octoprobe/tentacle/README.rst

Octoprobe Tentacle
==================

This is the `documentation <http://www.octoprobe.org/tentacle>`_

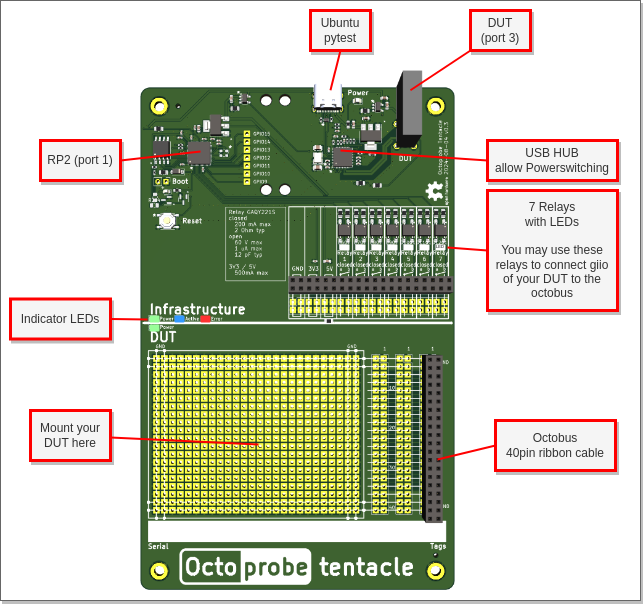
[picture p1: docs/tentacle_images/tentacle_intro.drawio.png]
