octoprobe/tentacle/docs/index.rst

Tentacle
======================

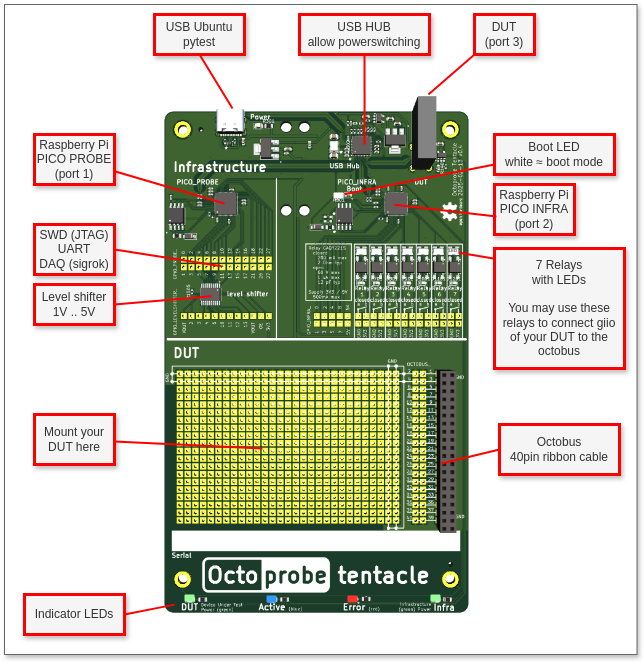
[picture p2: docs/tentacle_images/tentacle_intro_v0.4.drawio.png]


.. toctree::

    big_picture.rst
    tentacle_v0.9.rst
    tentacle_v0.8.rst
    tentacle_v0.7.rst
    tentacle_v0.6.rst
    tentacle_v0.5.rst
    tentacle_v0.4.rst
    tentacle_v0.3.rst
    pcb/bom.rst
    rp2_probe.rst
    rp2_probe-obsolete.rst
    license.rst
