octoprobe/tentacle/docs/tentacle_v0.9.rst

Tentacle v0.9 (recommended, 15 pieces produced)
=================================================================

This repo describes the hardware of a tentacle:

See also: :doc:`tentacle_v0.3`

Schematics
----------

:download:`Schematics v0.9 (Pdf) <../kicad/tentacle_v0.9/production_v0.9/schematics_tentacle_v0.9.pdf>`.

PCB
---
:doc:`Parts list <pcb/bom>`

The assembled PCB may be ordered at https://www.jclpcb.com. The production files are located here: `kicad/kicad_tentacle_v0.5/production_v0.5`.

The price of a assembled PCB is:

.. list-table::
    :header-rows: 1
    :align: right

    * - Pieces
      - USD total
      - USD per piece
    * - 15
      - 250
      - 16.7

The tentacle is described in more detail in :doc:`octoprobe:big_picture`



USB and Power
-----------------

This block diagram shows the power distribution with MT9700 switches and how to enable boot mode for `RP_INFRA` and `RP_PROBE`.
