octoprobe/tentacle/docs/big_picture.rst

Big Picture
===========================

A Octopus is flexible in using its tentacles. The same sence Octoprobe is flexible in using its tentacle PCB.
