octoprobe/tentacle/docs_working/working_v0.4/rp2_probe_logicanalyzer.md

# Logic Analyzer

https://github.com/gusmanb/logicanalyzer

https://github.com/gusmanb/logicanalyzer/blob/master/Schematic1.jpg

24 Channels

### JLC

* TXU0104PWR, JLC C2938871, USD0.7
