octoprobe/tentacle/docs_working/working_v0.4/rp2_probe_sigrok.md

# RP2 Sigrok

## Links

* https://github.com/dotcypress/ula/releases
  * https://forums.raspberrypi.com/viewtopic.php?t=350300
  * Written in Rust, Supported by standard Pulseview, seems to work.

* https://github.com/pico-coder/sigrok-pico/blob/main/README.md
  * No copyright
  * Written in C. Supported by standard Pulseview, seems to work.
