octoprobe/tentacle/docs/tentacle_v0.3.rst

Tentacle v0.3
===================

This repo describes the hardware of a tentacle:

Schematics
----------

:download:`Schematics v0.3 (Pdf) <../kicad/tentacle/production_v0.3/schematics.pdf>`.

PCB
---
:doc:`Parts list <pcb/bom>`

The assembled PCB may be ordered at https://www.jclpcb.com. The production files are located here: `kicad/kicad_tentacle_v0.3/production_v0.3`.

The price of a assembled PCB is ~USD10 when ordering 30 pieces.

The tentacle is described in more detail in :external+octoprobe:doc:`Octprobe <README>`

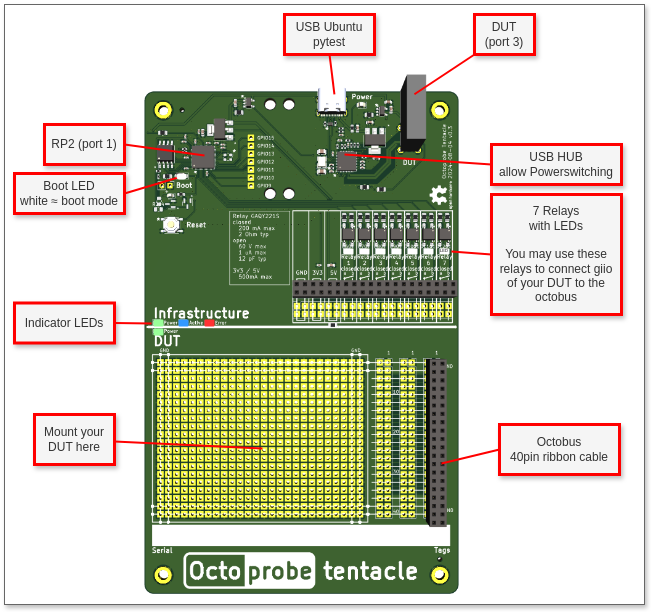
[picture p12: docs/tentacle_images/tentacle_intro_v0.3.drawio.png]
