octoprobe/tentacle/docs_working/2025-08_voltage-monitoring/2025-08-23_usb-cable-resistance_obsolete/README_usb_cable_resitance.md

## USB reference cable

| name | color |
| - | - |
| shield | None |
| GND | black |
| VBUS | red |
| D+ | green |
| D- | white |

| Connector | name | color | Treedix Pinrow | Treedix Pin |
| - | - | - | - | - |
| Micro | GND | black | B | 1 GND |
| Micro | VBUS | red | B | 9 VBUS |
| Micro | D+ | green | B | 6 D+ |
| Micro | D- | white | B | 7 D- |

## Treedix USB Cable Tester

TypeA 2.0: All connectors ARE CONNECTED!

Micro USB: As table above

## Instruction

Treedix USB Tester: Power Switch: Off
Treedix USB Tester: Plug TypeA / Micro: Plug cable
Treedix USB Tester: Measure resistance between GND and VBUS <== Meaningsless as everything is shortened

## Conclusion

Treedix USB Tester may not be used to measure the resitance
