octoprobe/tentacle/docs/pcb/bom_images/2x20_Header_mechanical_drawing.jpg

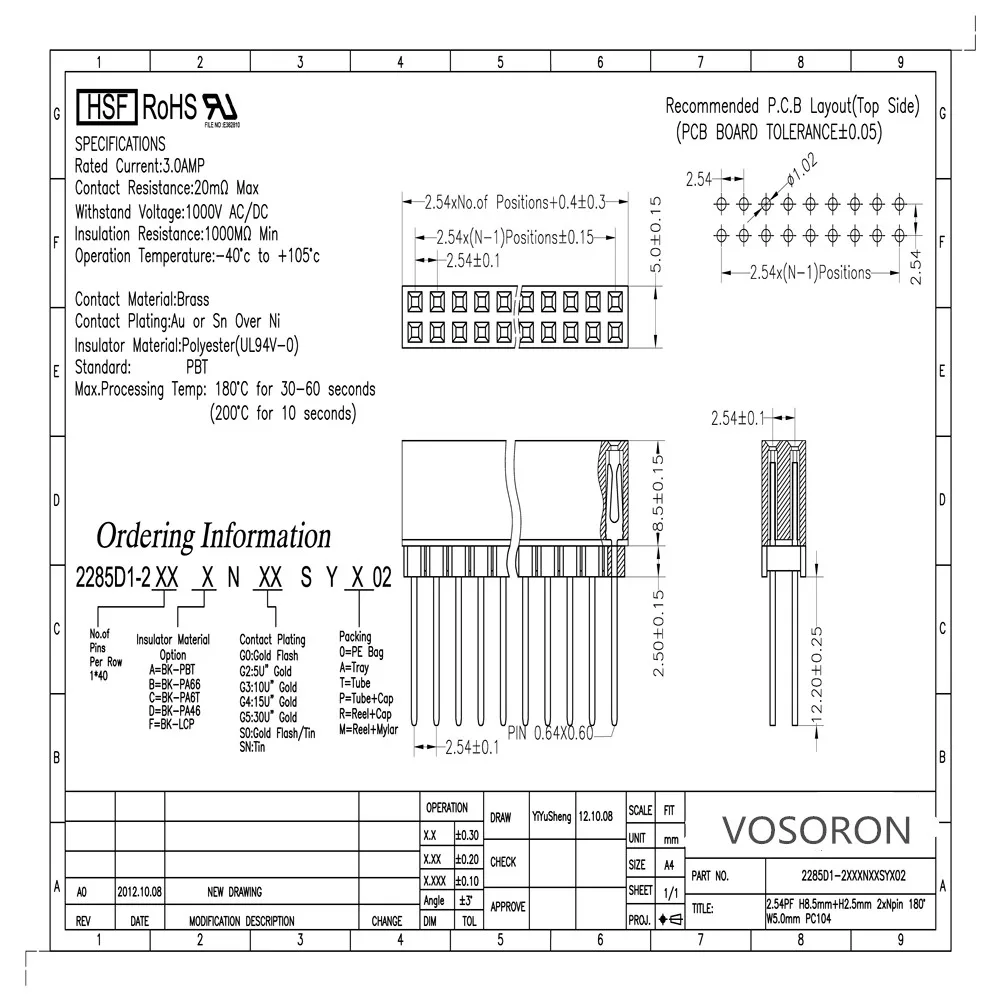
docs/pcb/bom_images/2x20_Header_mechanical_drawing.jpg
