octoprobe/tentacle/docs_working/2026-10-12_power_off_while_connecting/power_off_while_connecting.png

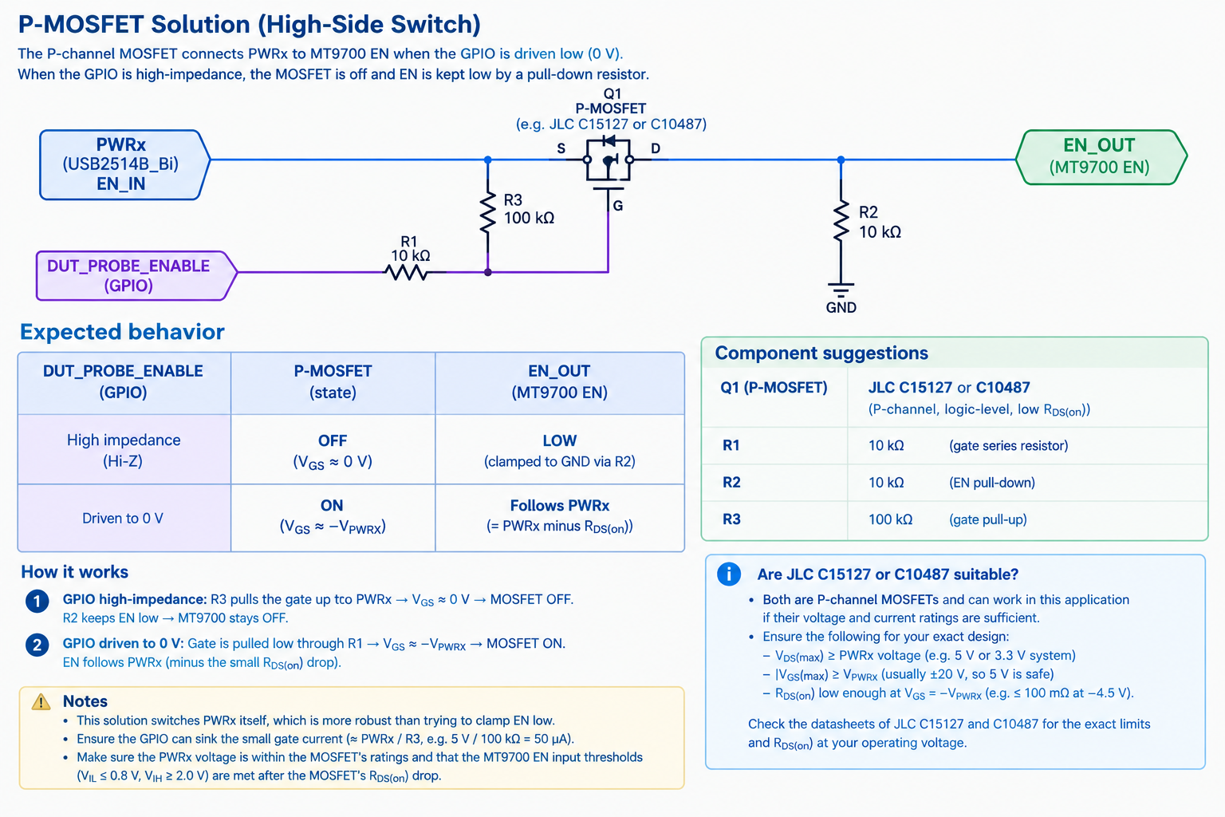
docs_working/2026-10-12_power_off_while_connecting/power_off_while_connecting.png
