octoprobe/tentacle/model3d_spacer_bolzone/20240719b_bolzone.png

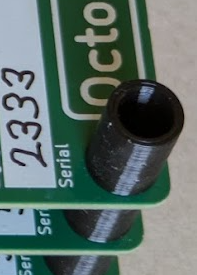
model3d_spacer_bolzone/20240719b_bolzone.png
