octoprobe/tentacle/kicad/tentacle_v0.8/00_project_parts/USB_A/USB-226-BRW_readme.md

https://componentsearchengine.com/part-view/USB-226-BRW/XUNPU
