octoprobe/tentacle/freecad_bolzone/bolzone_due_16.0.stl

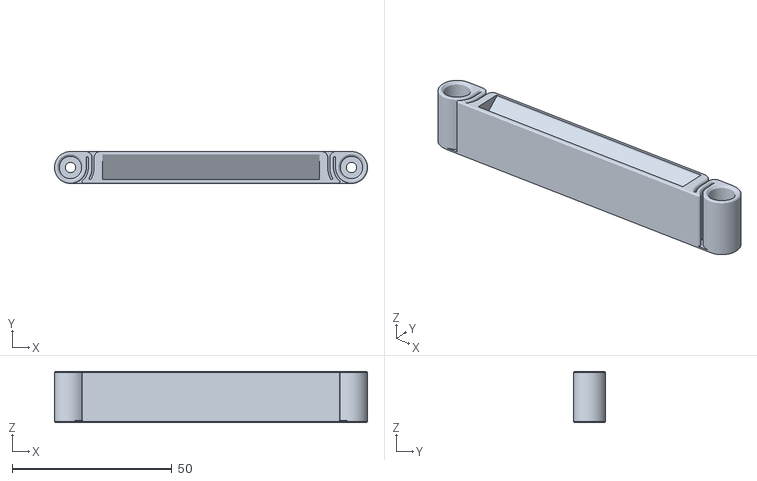
[picture p24: CAD file, 2026-05-20]
freecad_bolzone/bolzone_due_16.0.stl
98.0 x 10.0 x 16.0
