octoprobe/tentacle/freecad_bolzone/bolzone_uno_33.6.stl

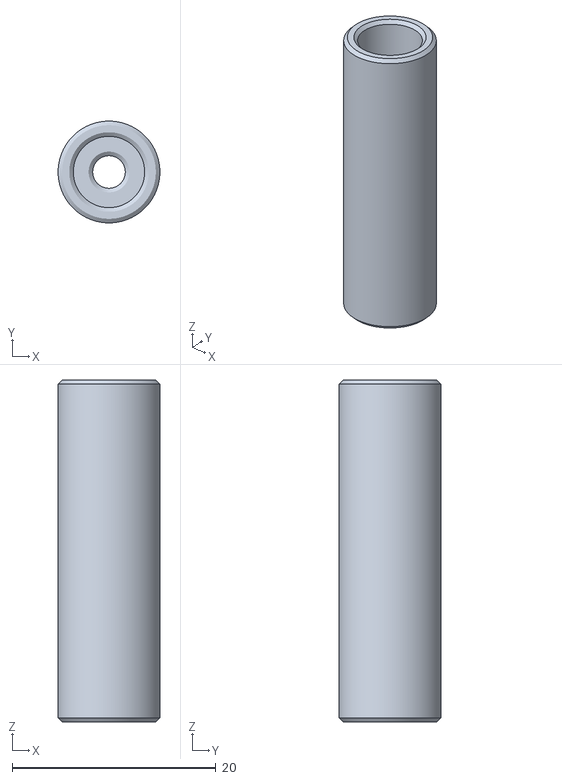
[picture p25: CAD file, 2026-05-20]
freecad_bolzone/bolzone_uno_33.6.stl
10.0 x 10.0 x 33.6
