octoprobe/tentacle/freecad_bolzone/bolzone_uno_16.0.stl

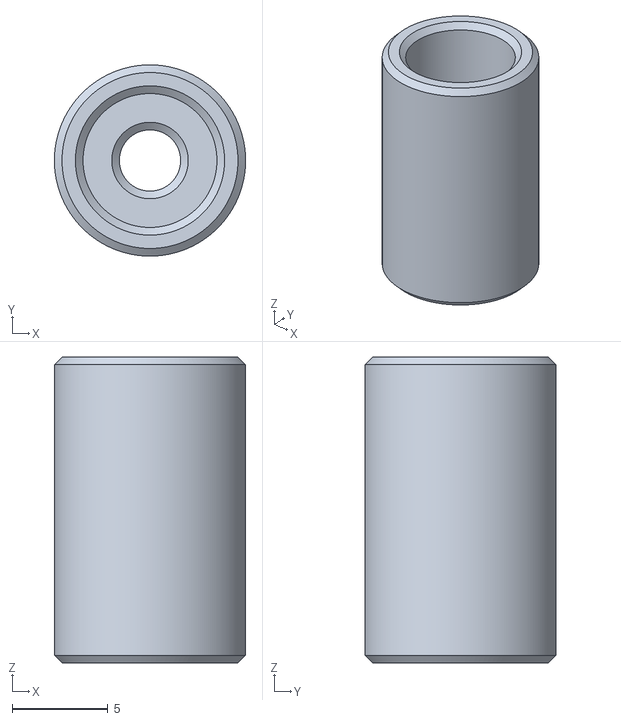
[picture p26: CAD file, 2026-05-20]
freecad_bolzone/bolzone_uno_16.0.stl
10.0 x 10.0 x 16.0
