octoprobe/tentacle/freecad_bolzone/bolzone_v20250418a.FCStd

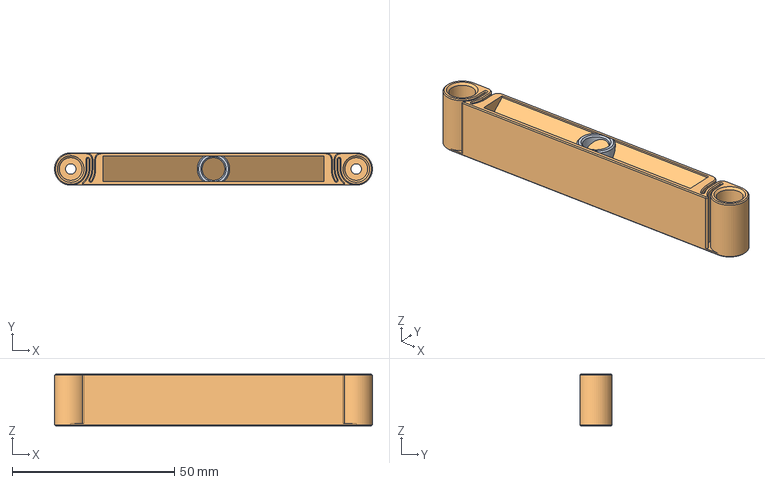
[picture p27: CAD file, 2026-05-20]
freecad_bolzone/bolzone_v20250418a.FCStd
98.0 x 10.0 x 16.0 mm
bolzone_uno
bolzone_due_label
