octoprobe/tentacle/freecad_bolzone/bolzone_due_33.6.stl

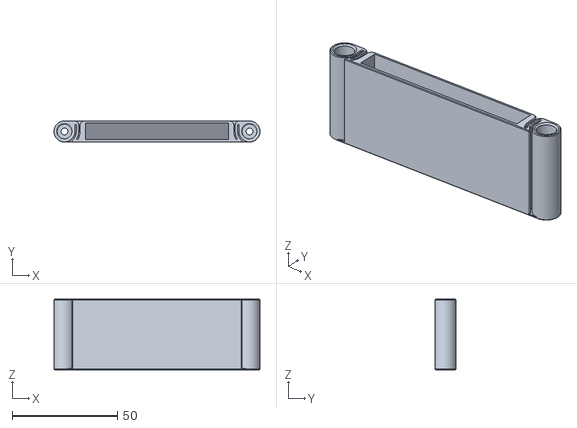
[picture p28: CAD file, 2026-05-20]
freecad_bolzone/bolzone_due_33.6.stl
98.0 x 10.0 x 33.6
