octoprobe/tentacle/kicad/tentacle_v0.8/00_project_parts/bizcard/footprints/TS-1187A-B-A-B.step

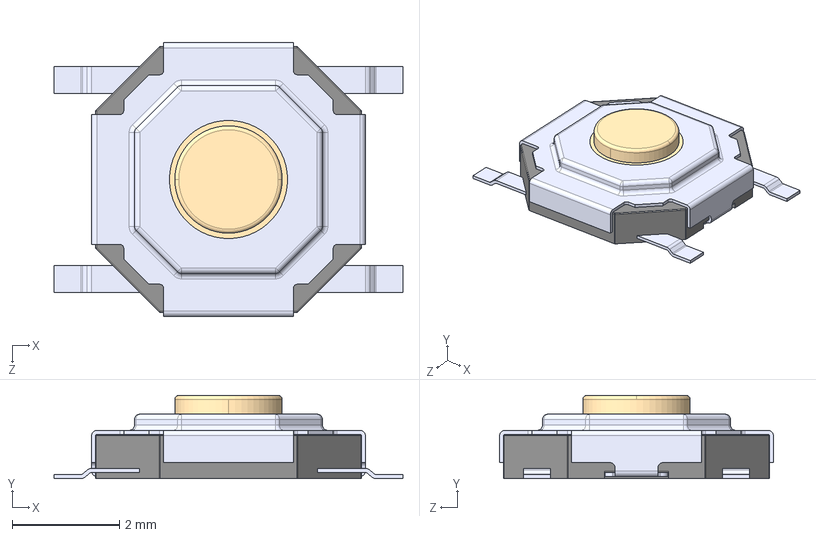
[picture p29: CAD file, 2024-08-17, an earlier design]
kicad/tentacle_v0.8/00_project_parts/bizcard/footprints/TS-1187A-B-A-B.step
6.50 x 1.55 x 5.10 mm
