octoprobe/tentacle/kicad/tentacle_v0.8/00_project_parts/USB_A/USB-226-BRW/USB-226-BRW.stp

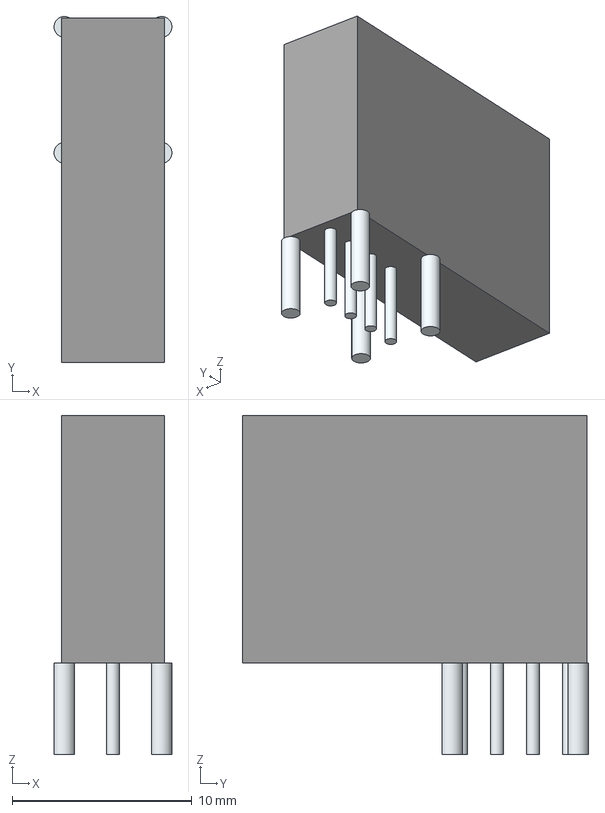
[picture p30: CAD file, 2024-08-17, an earlier design]
kicad/tentacle_v0.8/00_project_parts/USB_A/USB-226-BRW/USB-226-BRW.stp
6.55 x 19.2 x 18.9 mm
Leads
