octoprobe/tentacle/kicad/tentacle_v0.8/00_project_parts/bizcard/footprints/TYPE-C-31-M-12--3DModel-STEP-56544.STEP

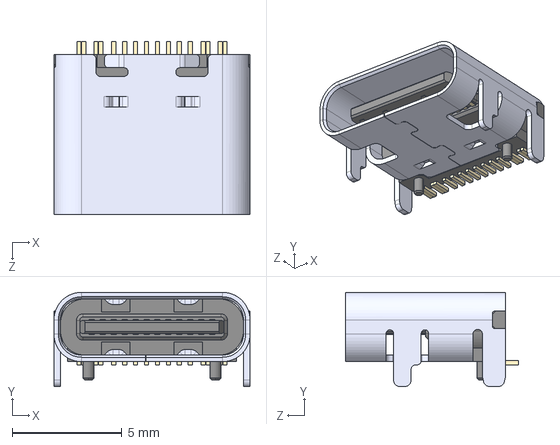
[picture p31: CAD file, 2024-08-17, an earlier design]
kicad/tentacle_v0.8/00_project_parts/bizcard/footprints/TYPE-C-31-M-12--3DModel-STEP-56544.STEP
8.94 x 4.30 x 7.90 mm
