octoprobe/tentacle/(list of files, cad)

Other CAD files:
model3d_spacer_bolzone/20240719b_bolzone.FCStd
model3d_spacer_bolzone/20240719b_bolzone.stl
