octoprobe/tentacle/docs_working/2025-08_voltage-monitoring/2025-08-23_usb-cable-resistance_obsolete/USB_Cable_Manual.pdf

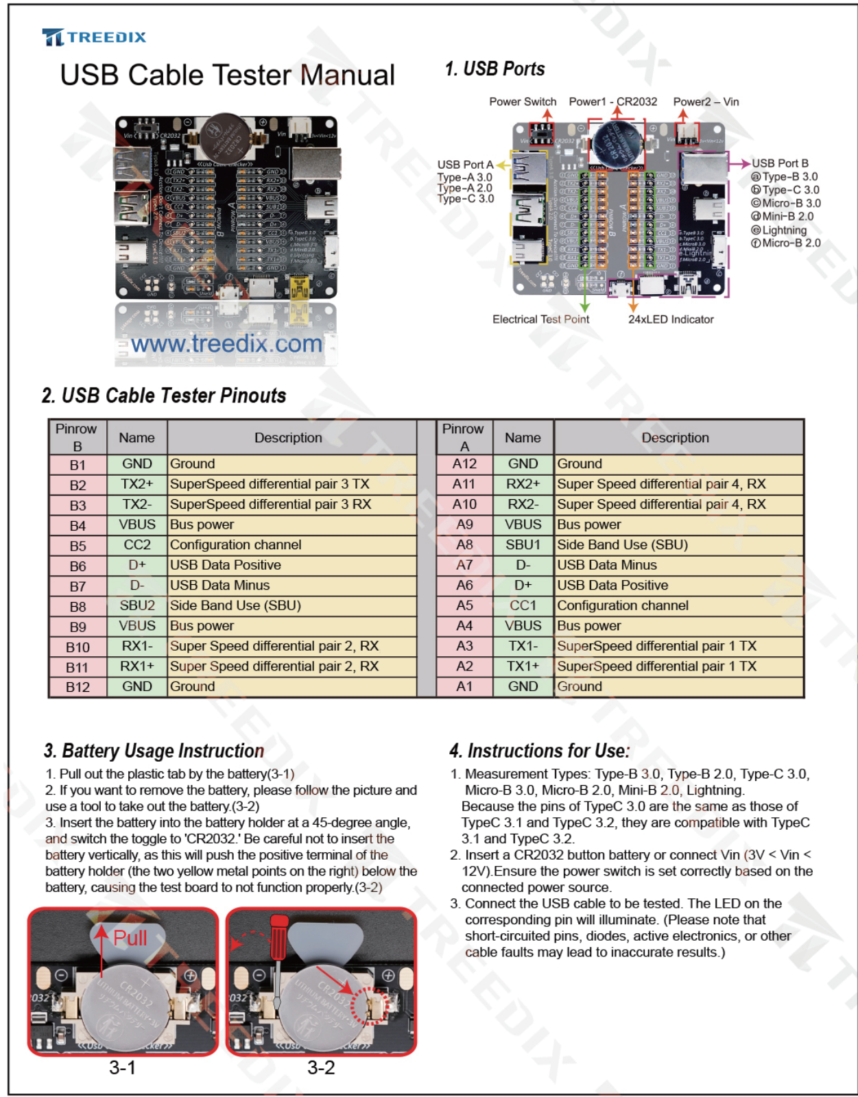
[picture p32: page 1]
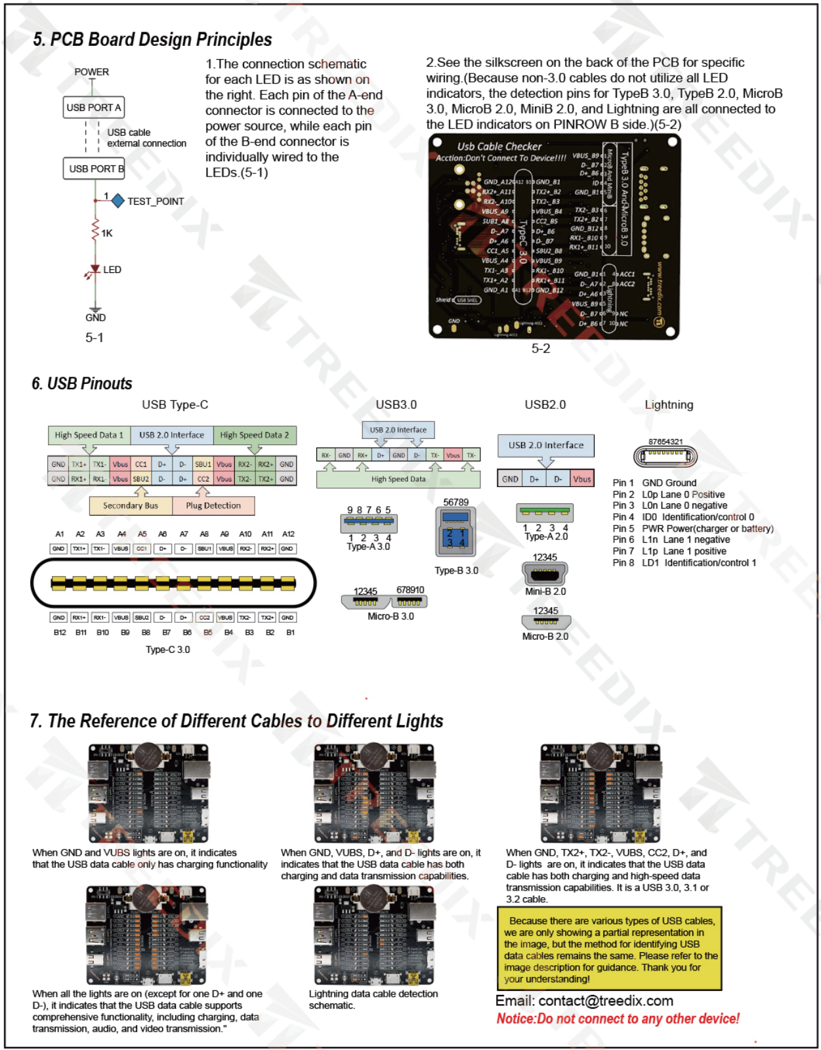
[picture p33: page 2]
