octoprobe/tentacle/docs_working/2025-12_voltage-monitoring/README_evaluation_hubs_powersupplies.md

# Evalation

## Power supplies

* https://www.distrelec.ch/de/industrie-netzteil-30w-5v-6a-mean-well-irm-30-5st/p/30060583

  CHF15, 6A

* https://www.distrelec.ch/de/netzteil-gst25-series-5v-4a-20w-iec-60320-c8-zylinderstecker-mm-mean-well-gst25b05-p1j/p/30042763

  CHF14, 4A

## USB Hubs, 2.0, USB-A, 4Port

* https://www.distrelec.ch/de/usb-hub-usb-stecker-usb-ports-usb-buchse-startech-com-st4200mini2/p/30214248

  CHF16, StarTech.com

* https://www.distrelec.ch/de/usb-hub-usb-stecker-usb-ports-usb-buchse-rs-pro-2206492/p/30390908

  CHF11, RS PRO

* https://www.distrelec.ch/de/usb-hub-mini-usb-buchse-usb-ports-usb-buchse-roline-14-02-5013/p/30114486

  CHF34, Roline

* https://www.distrelec.ch/de/usb-hub-usb-stecker-usb-ports-usb-buchse-rs-pro-1411989/p/30394878

  CHF14, RS PRO

* https://de.aliexpress.com/item/1005003614172238.html, https://de.aliexpress.com/item/1005006482609043.html

  USD3, Aiersai, GL850G-Chip, https://www.genesyslogic.com.tw/

  chip seams to be too cheap
