octoprobe/tentacle/docs_working/working_v0.4/tentacle_v04_bring_up.md

# Tentacle v0.4 bring up

Goal: Test all aspects of the tentacle

## Features of tentacle v0.3: Relays

Rationale:
 * Demonstrate that the relays work as expected
 * Demonstrate that the USB connection to the DUT works.
Setup:
 * Tentacle: MCU_RPI_PICO_W, de646cc20b684f25, v0.4
 * Tentacle: DAQ SALEAE, v0.3
 * Tentacle: DEVICE_POTPOURRY, v0.3
