octoprobe/tentacle/kicad/tentacle_v0.9/production_v0.9/schematics_tentacle_v0.9.pdf

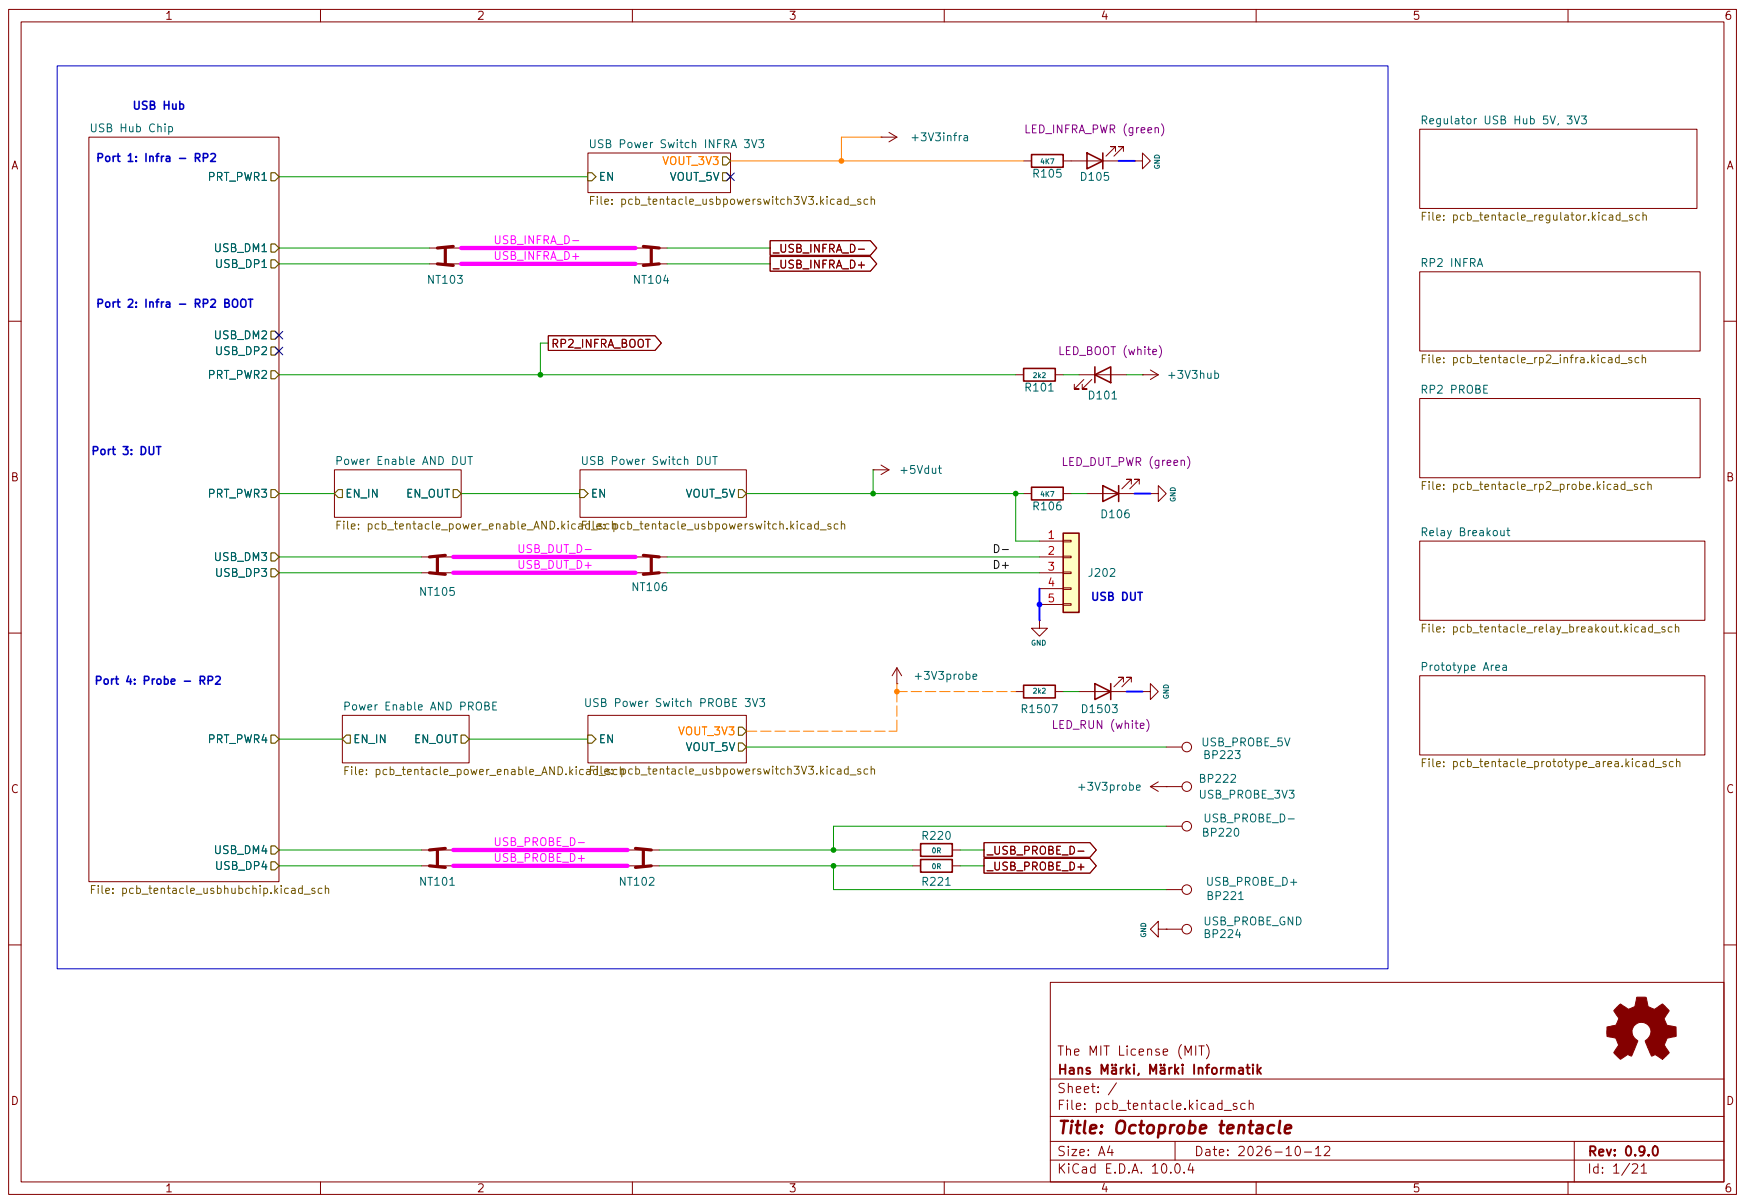
[picture p34: page 1]

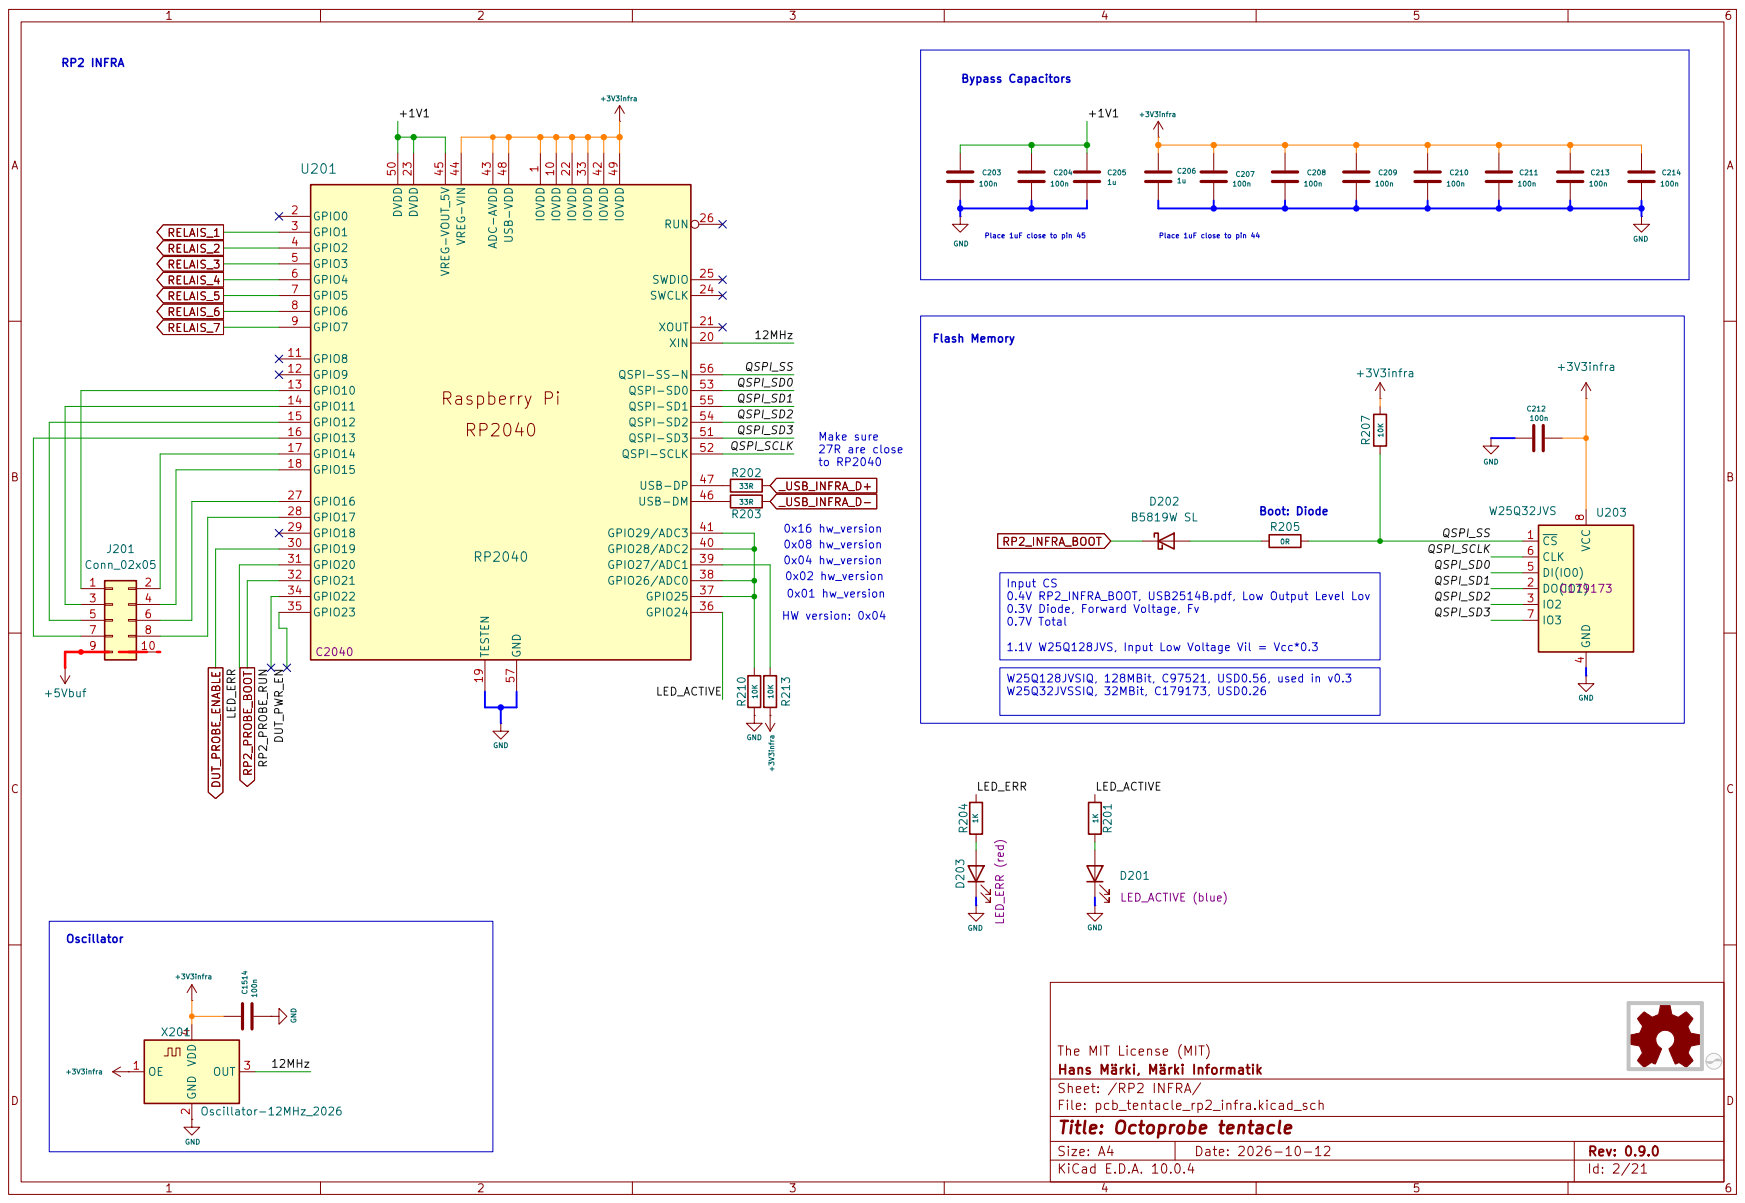
[picture p35: page 2]

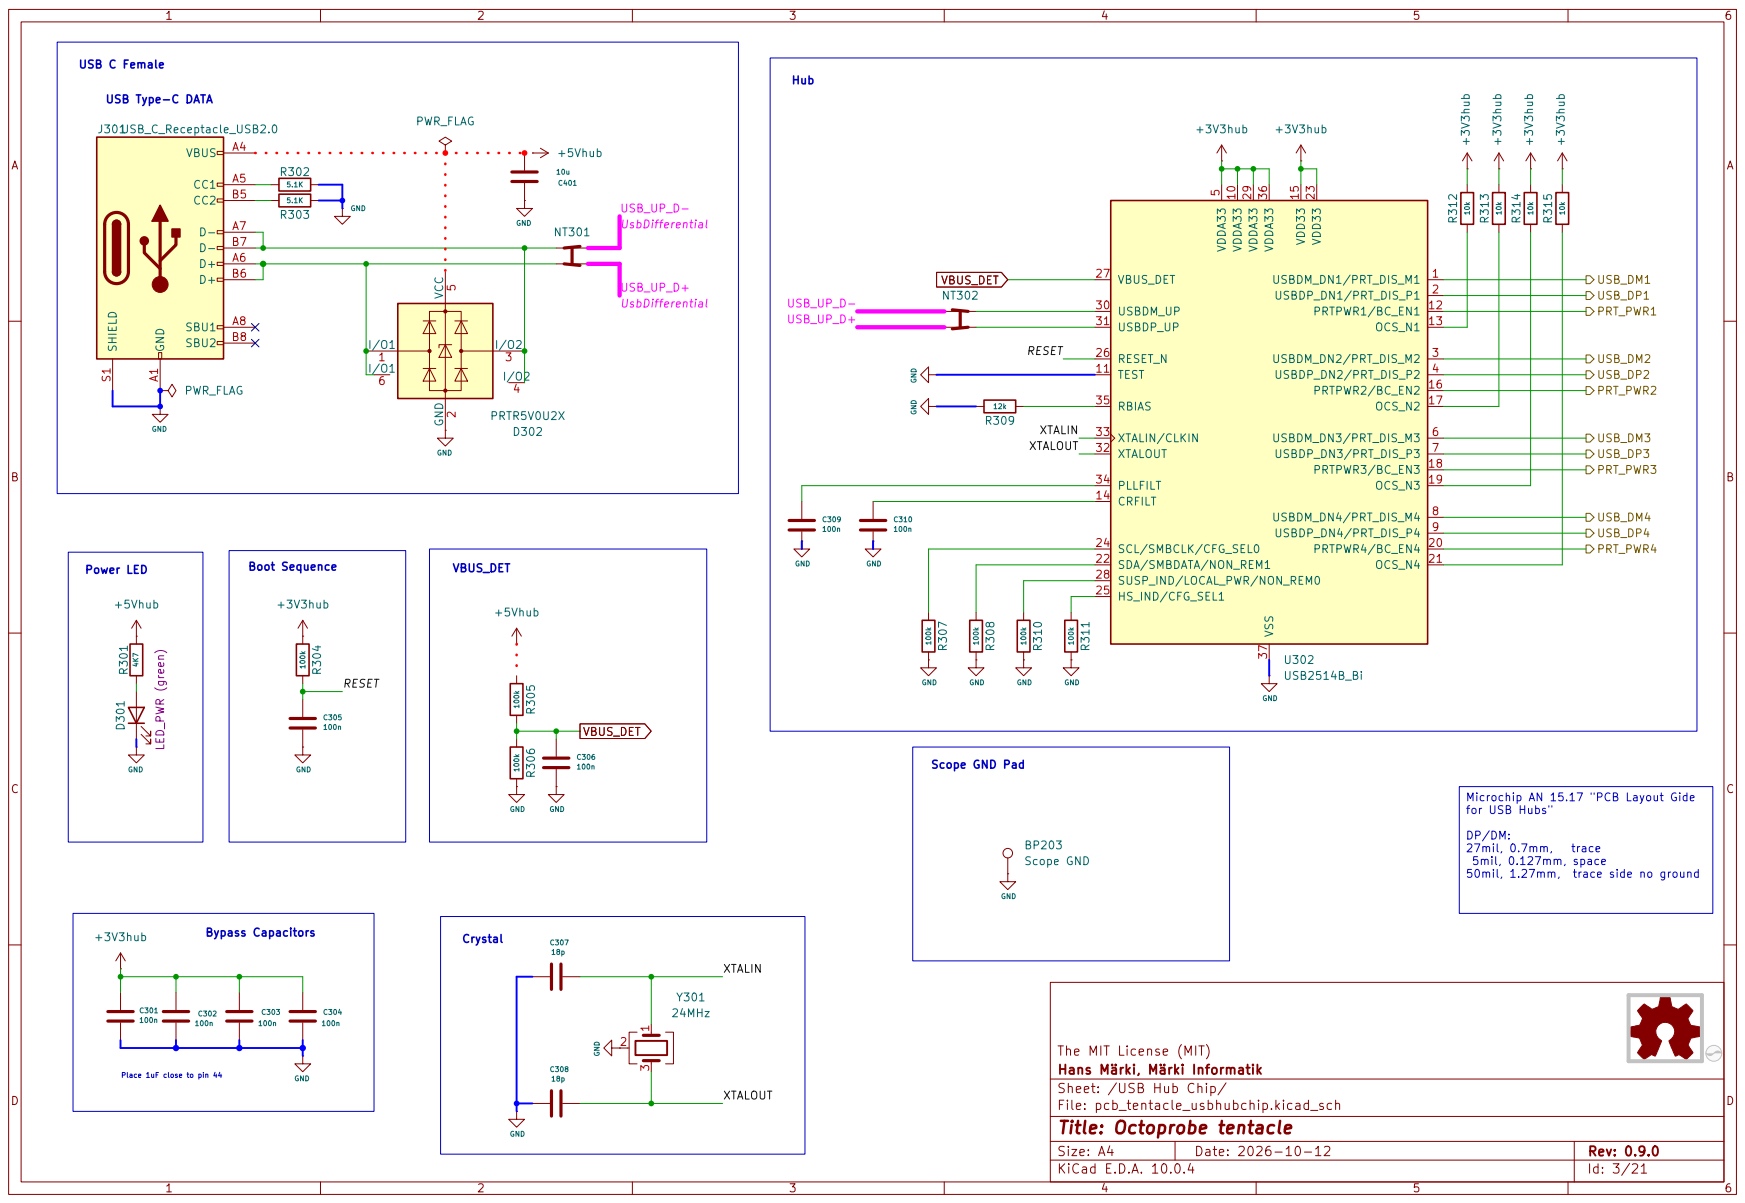
[picture p36: page 3]

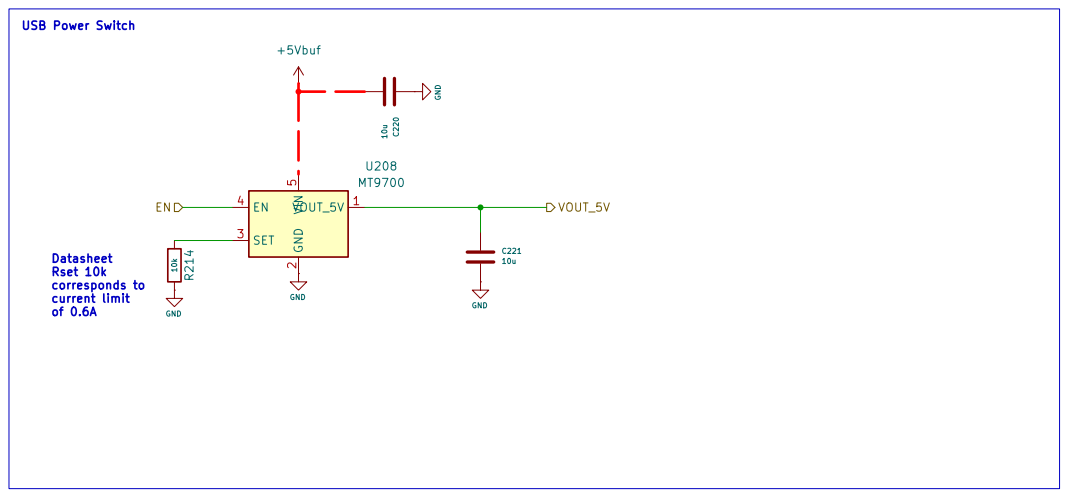
[picture p37: page 4]

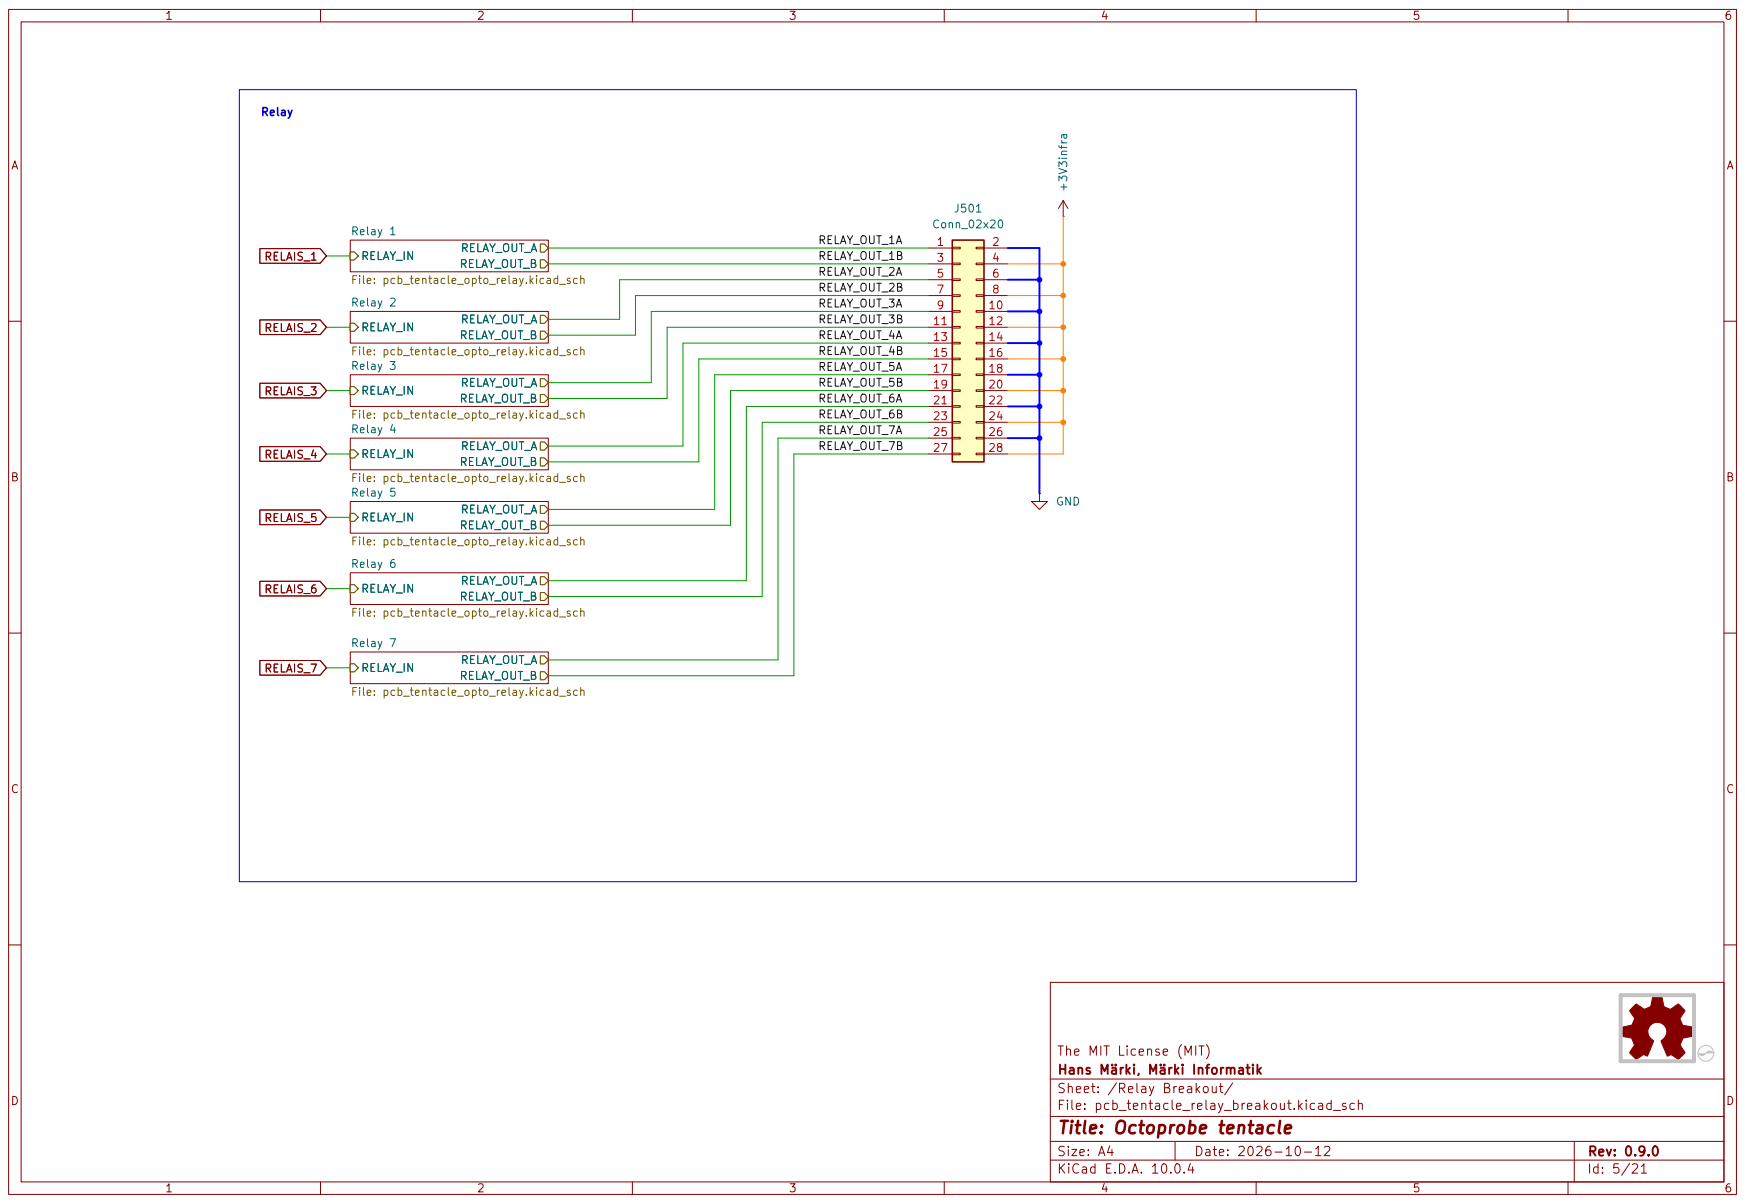
[picture p38: page 5]

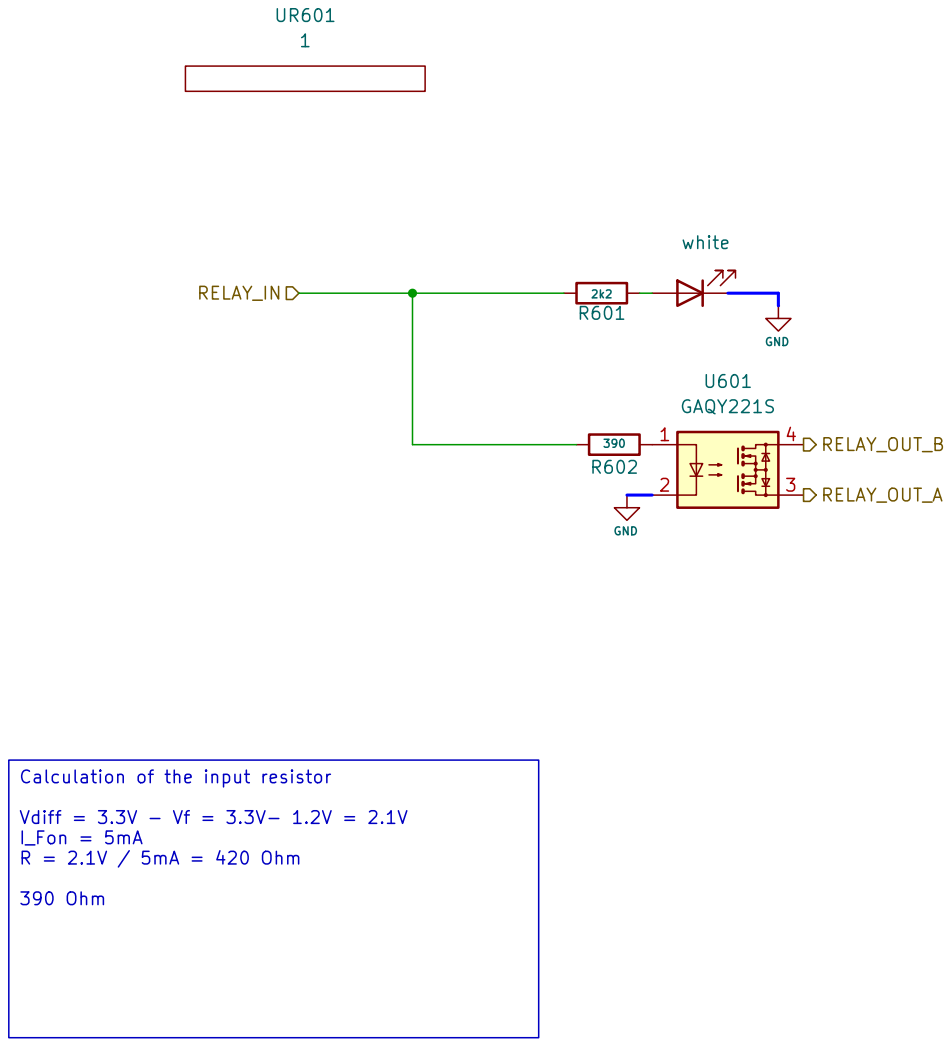
[picture p39: page 6]

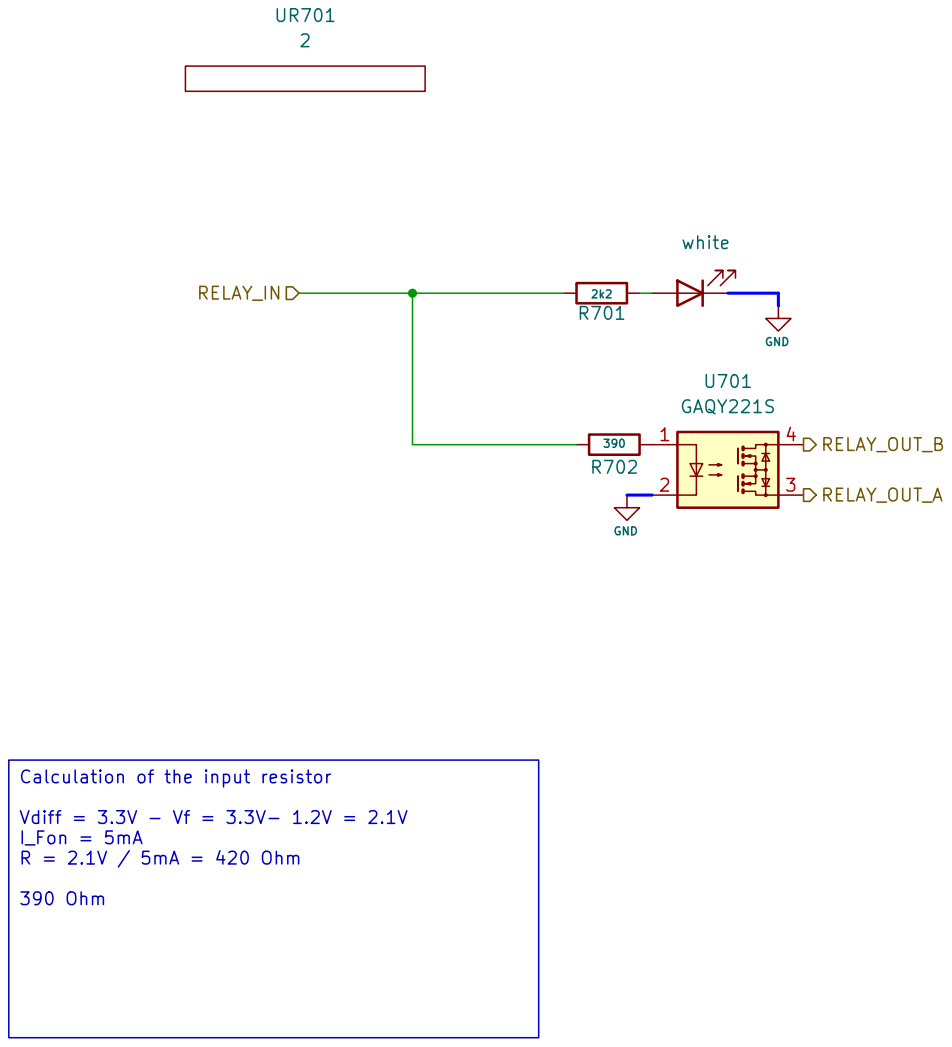
[picture p40: page 7]

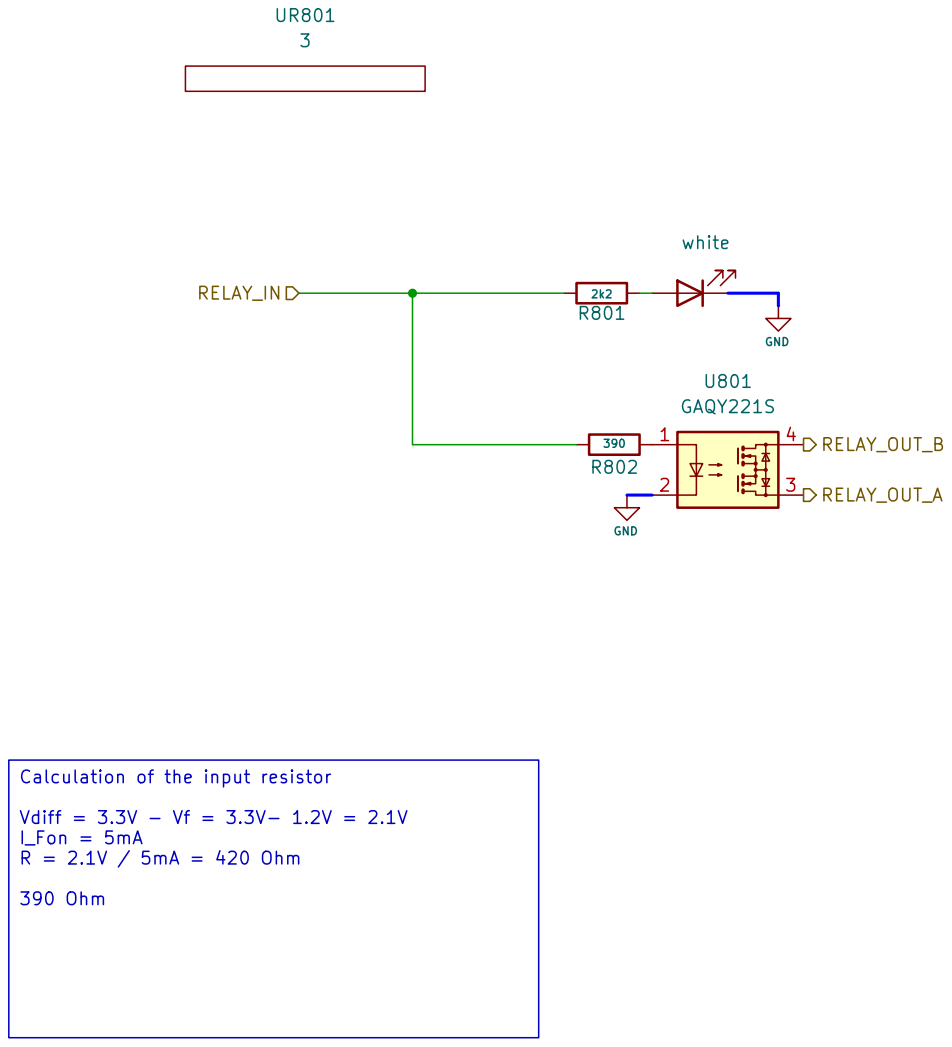
[picture p41: page 8]

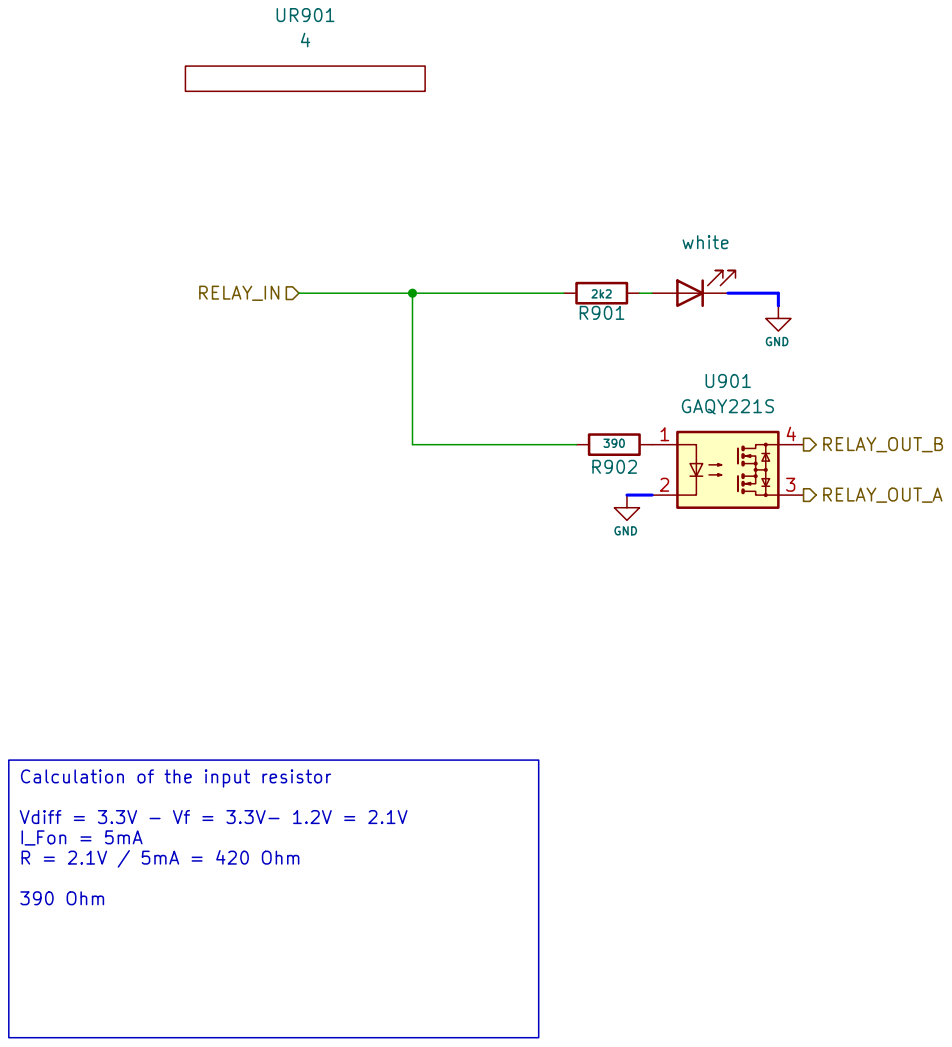
[picture p42: page 9]

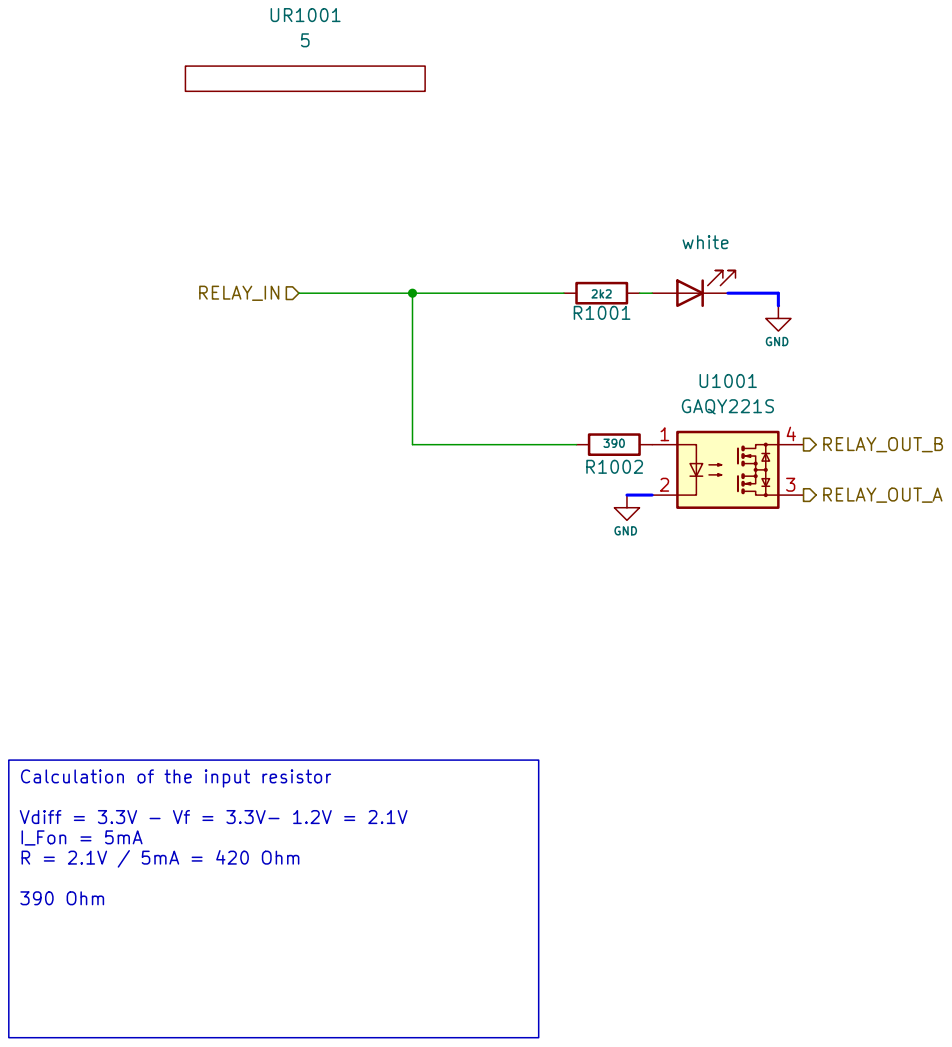
[picture p43: page 10]

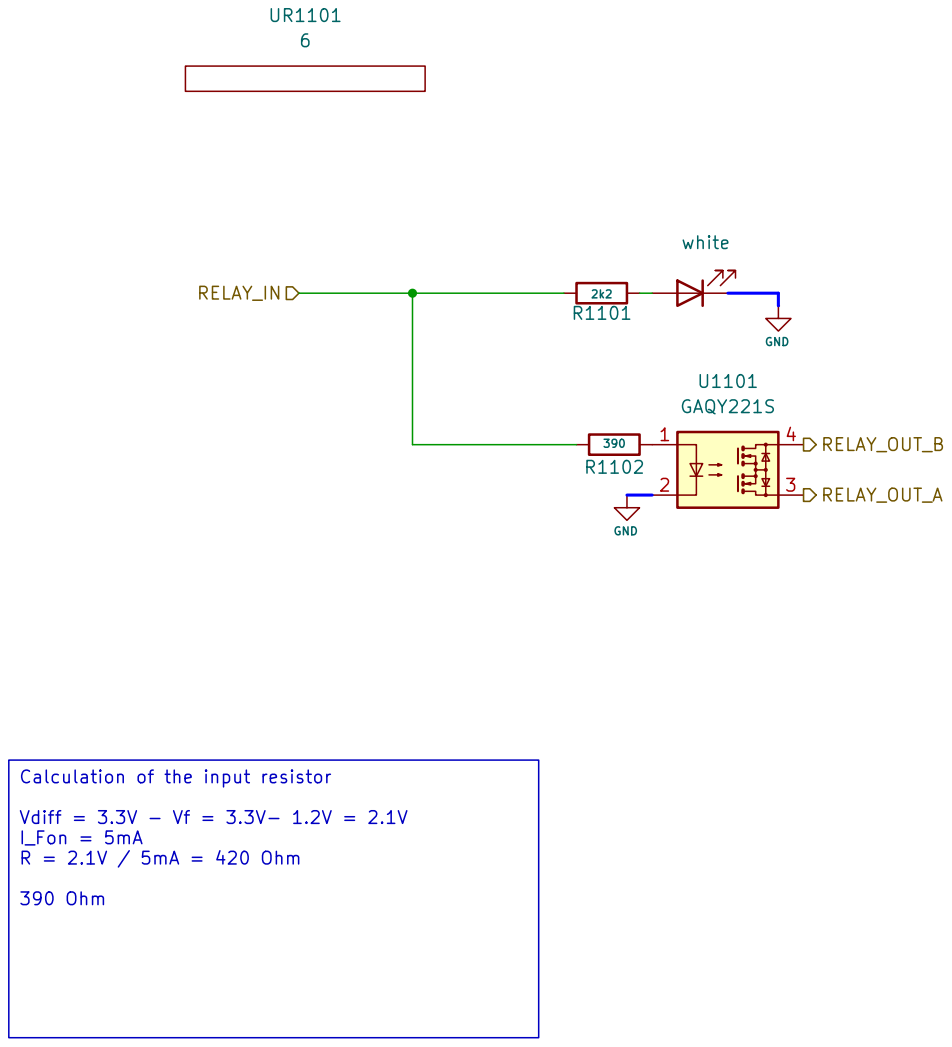
[picture p44: page 11]

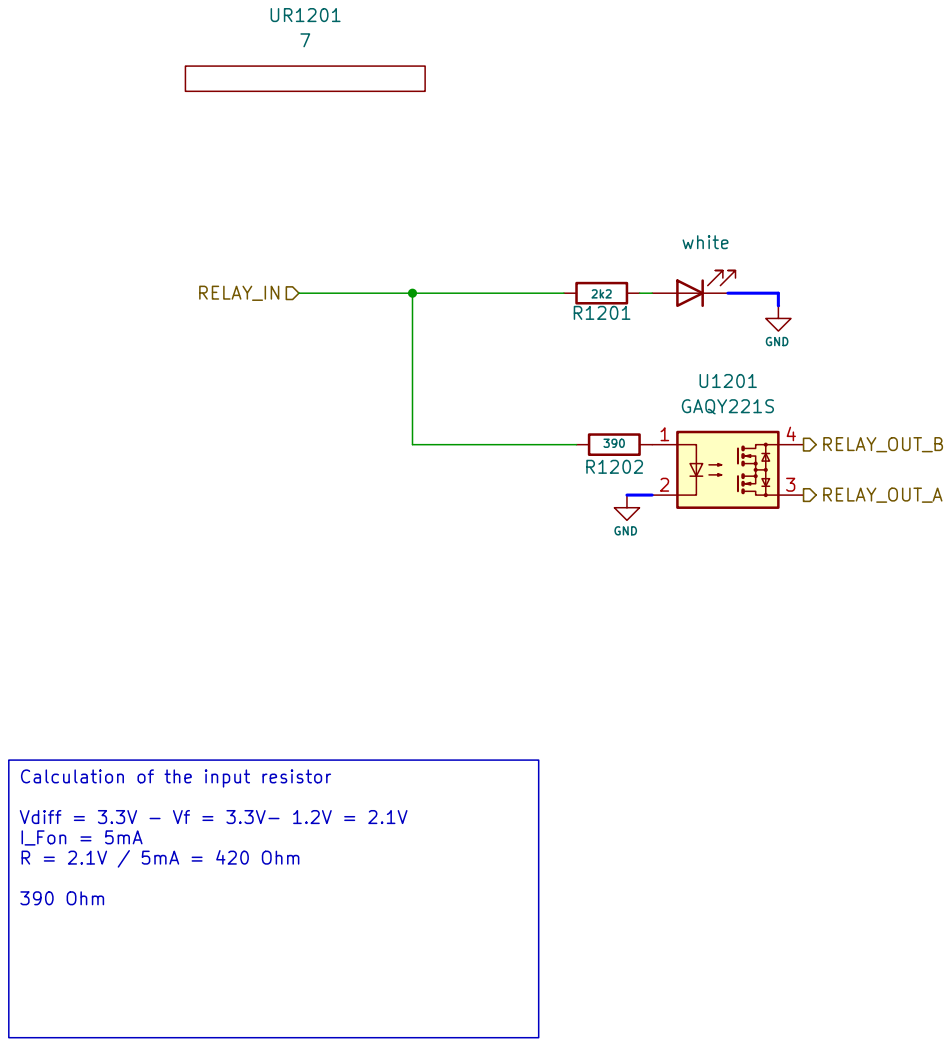
[picture p45: page 12]

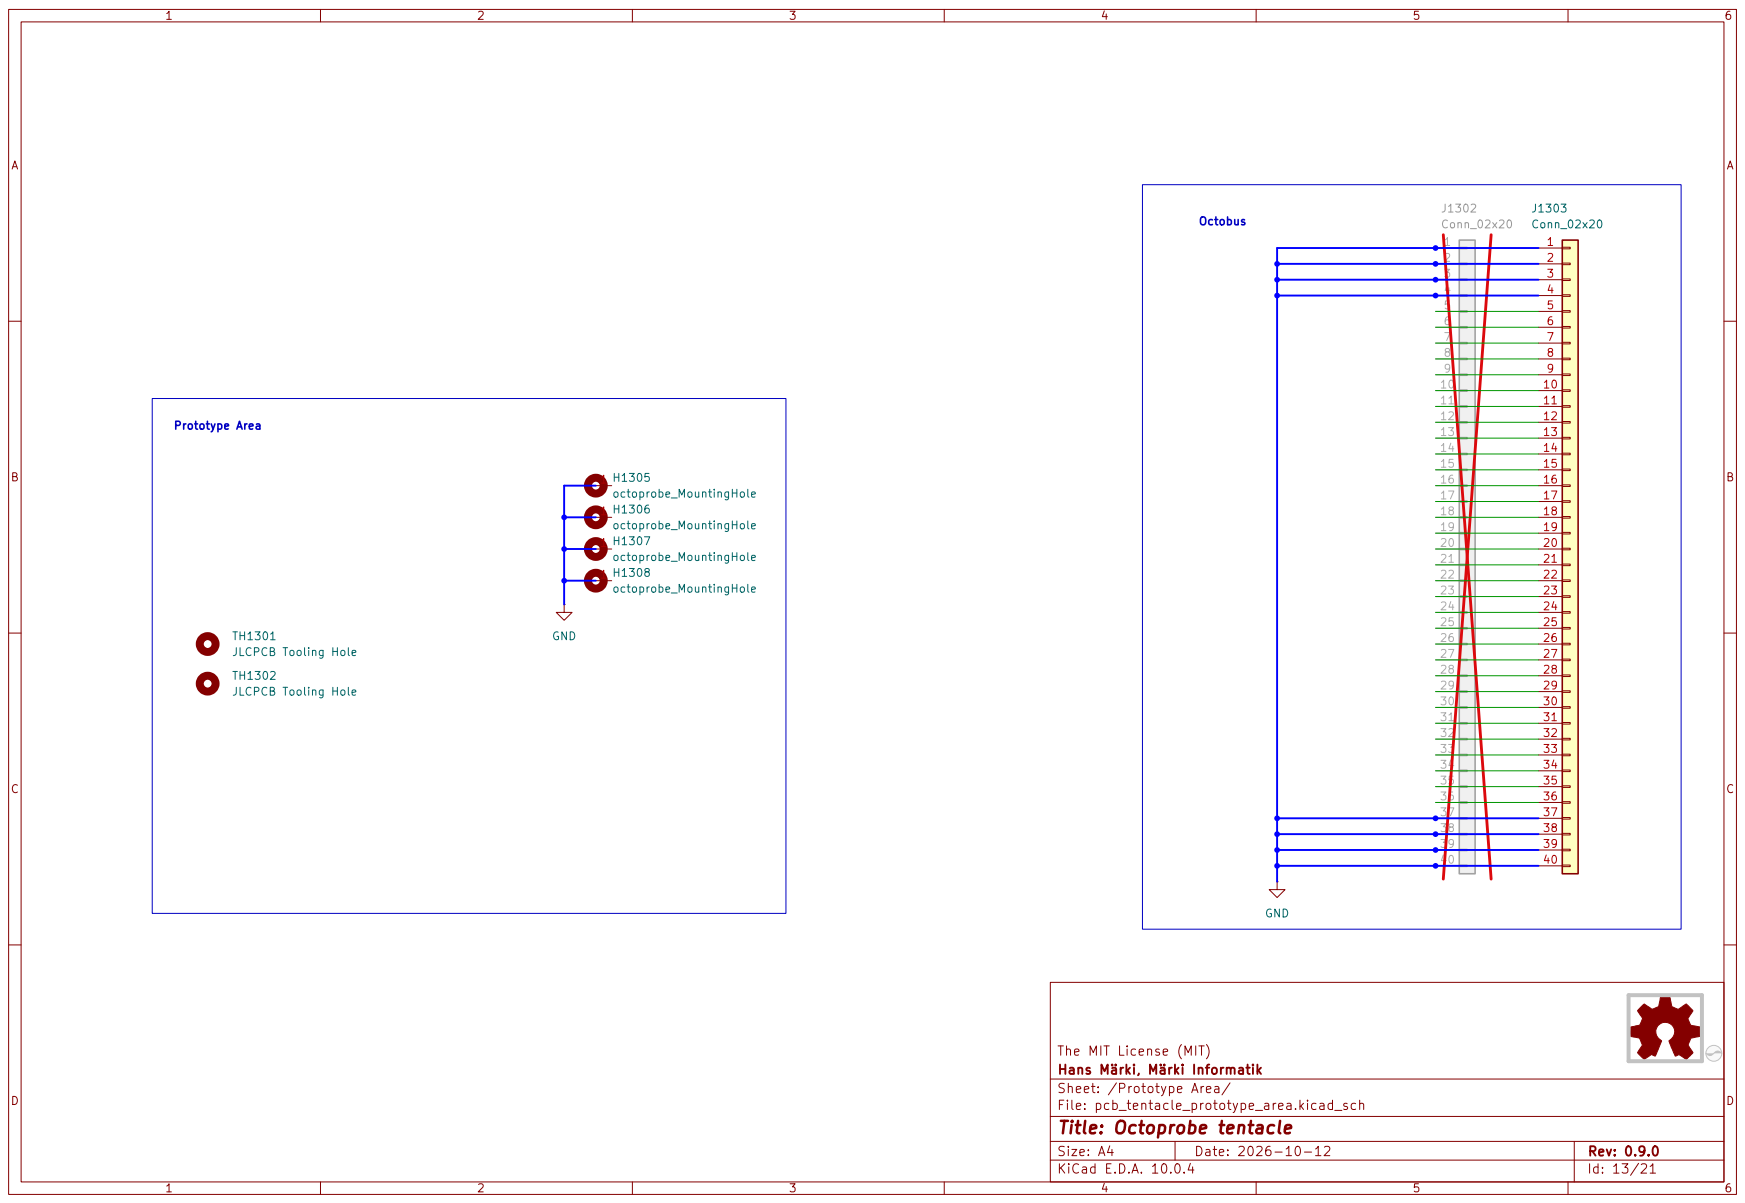
[picture p46: page 13]

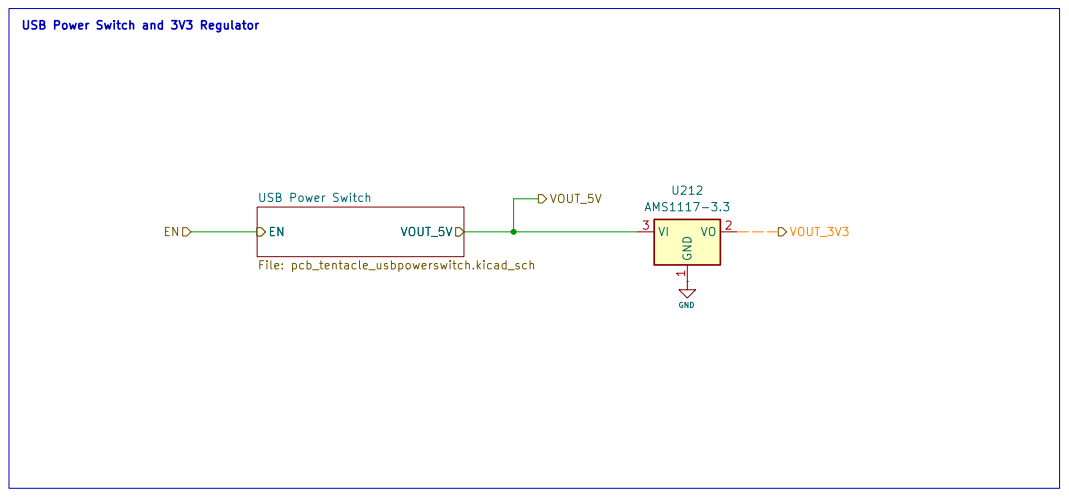
[picture p47: page 14]

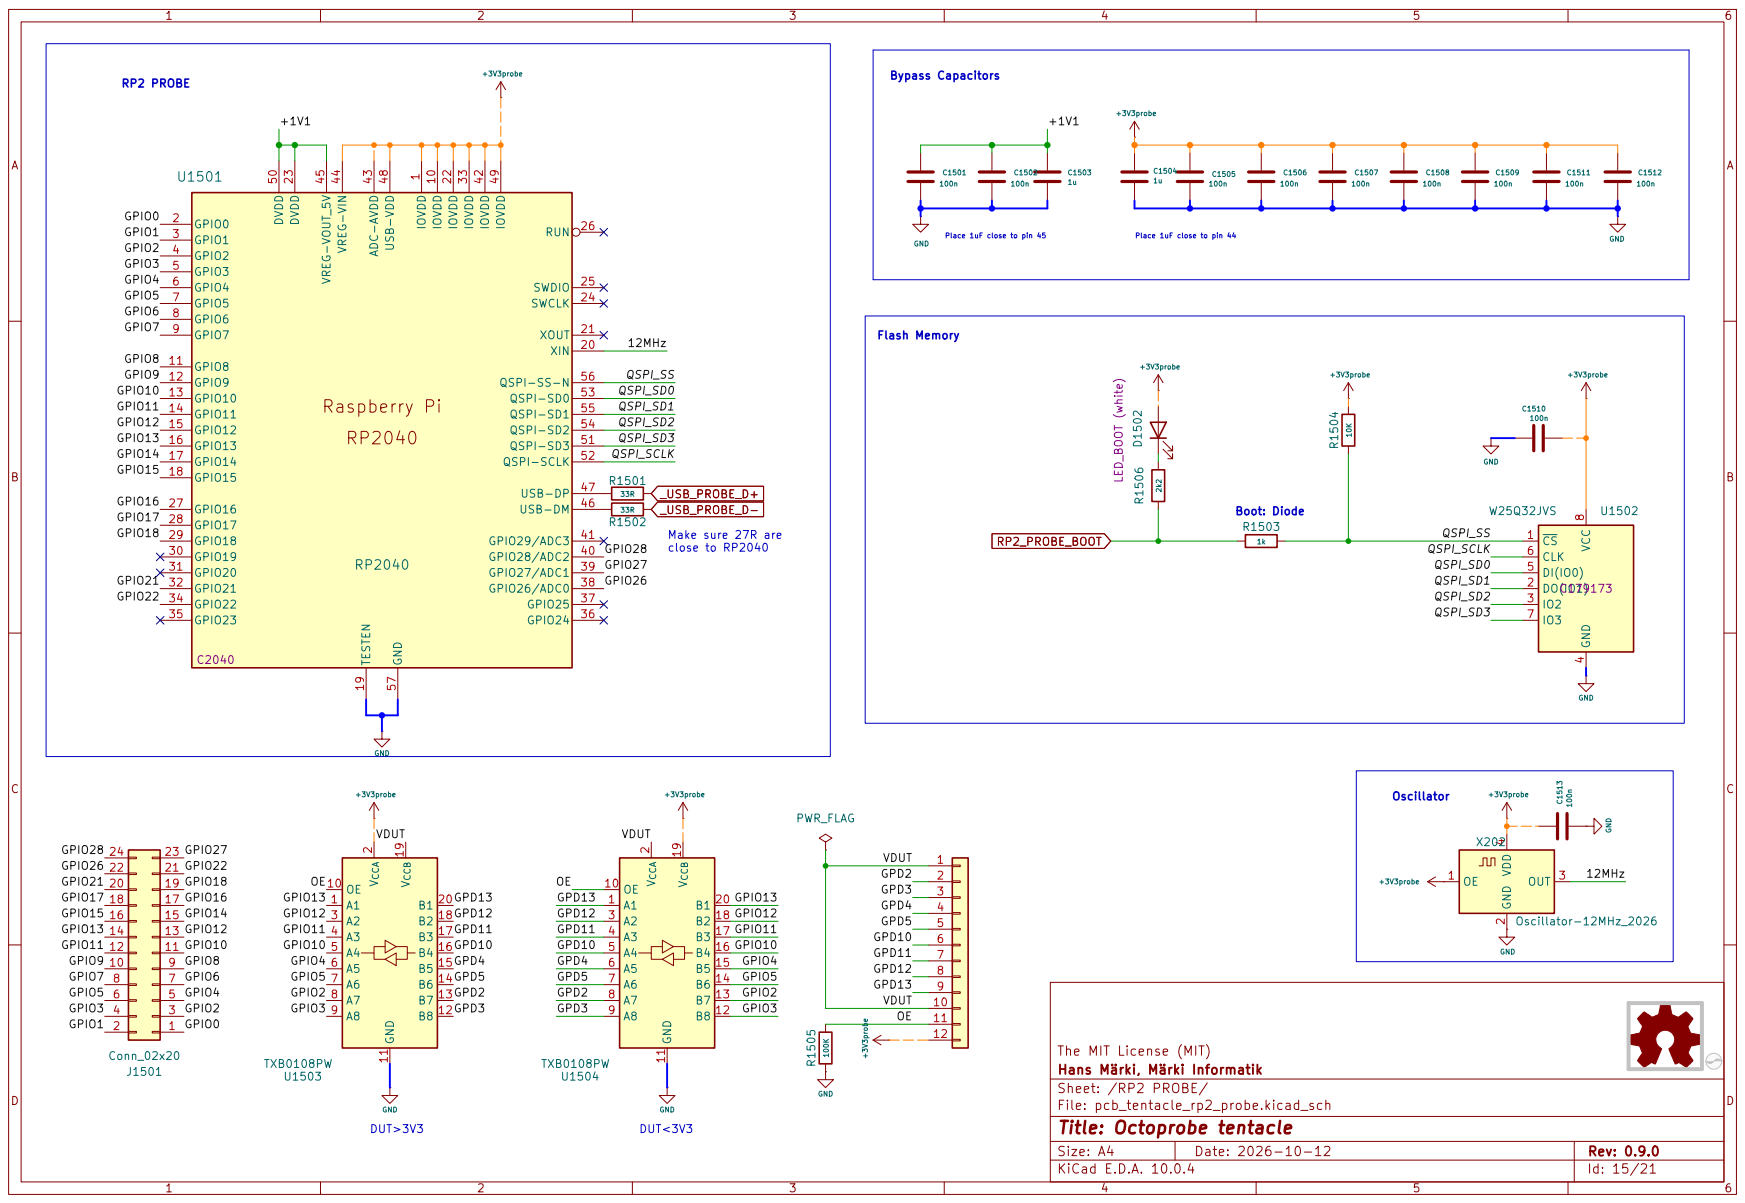
[picture p48: page 15]

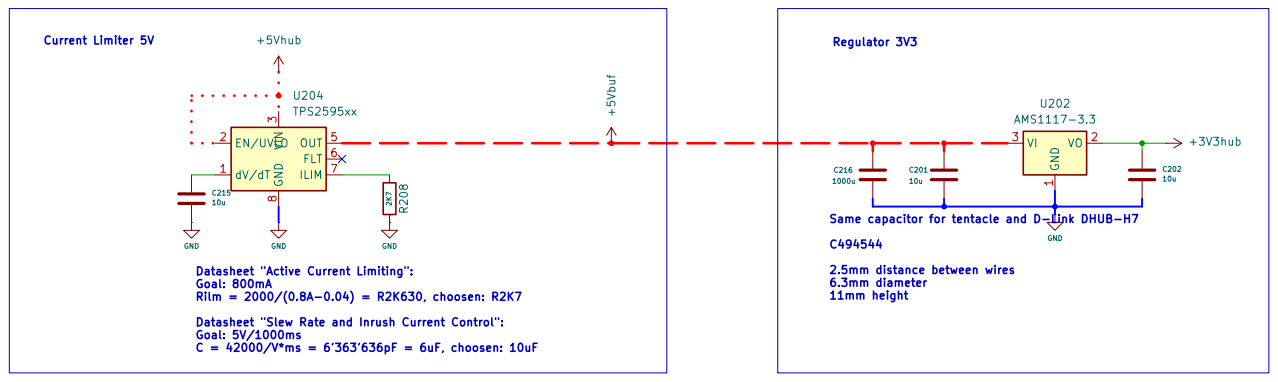
[picture p49: page 16]

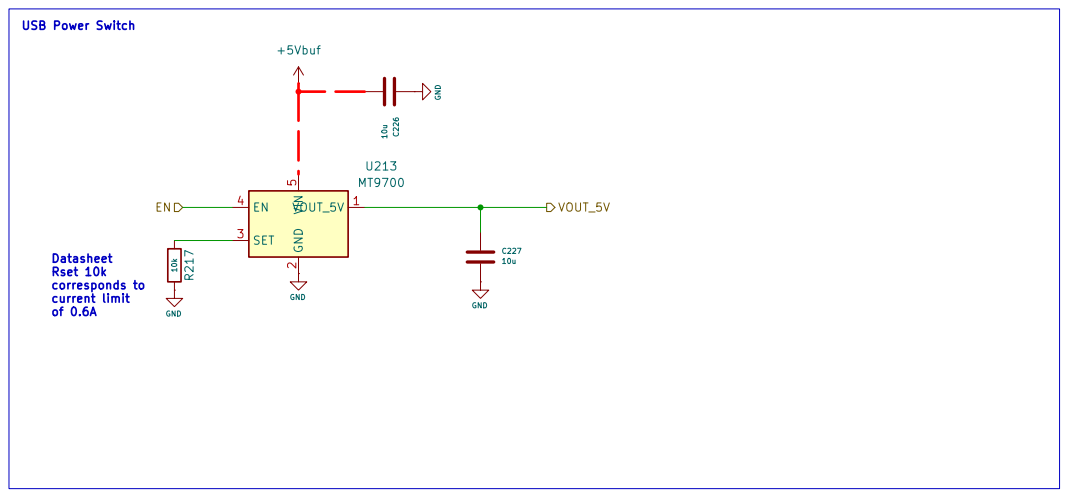
[picture p50: page 17]

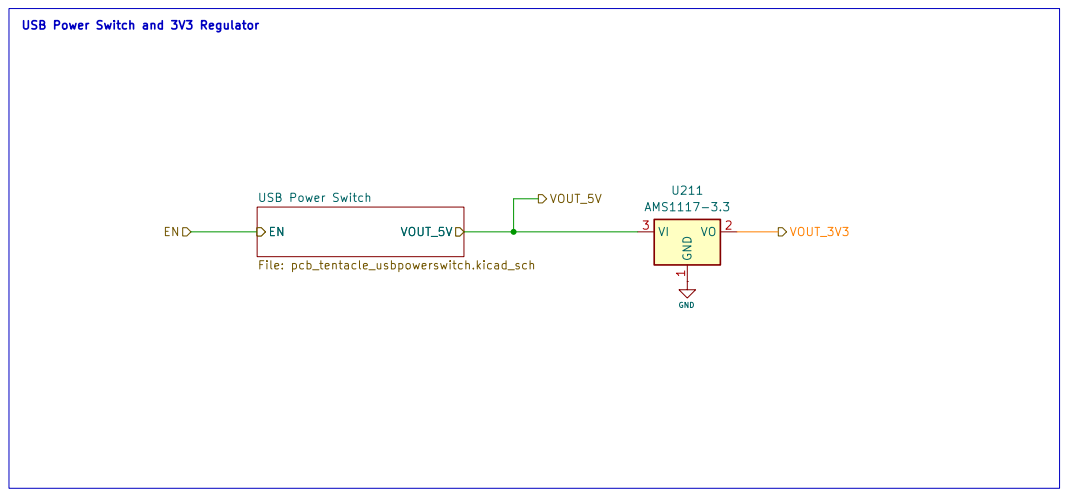
[picture p51: page 18]

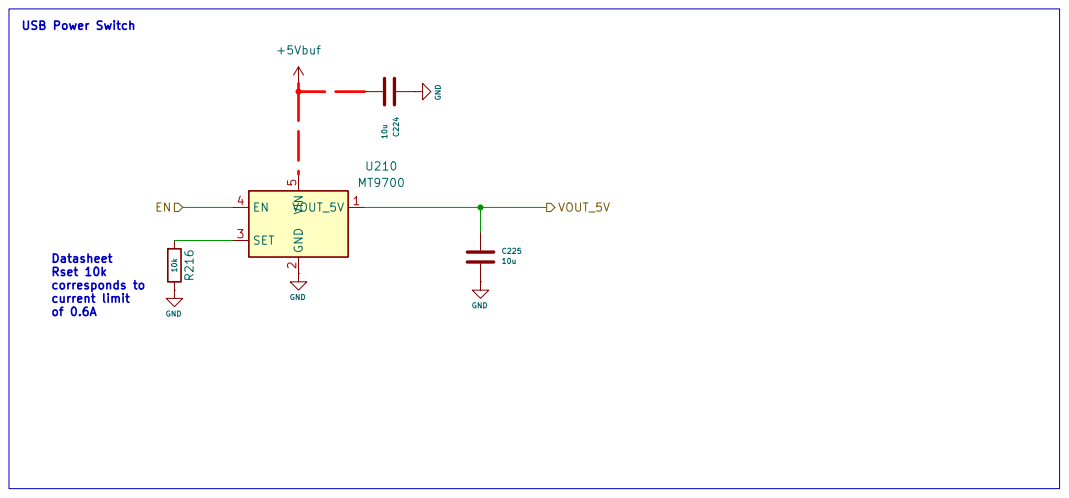
[picture p52: page 19]

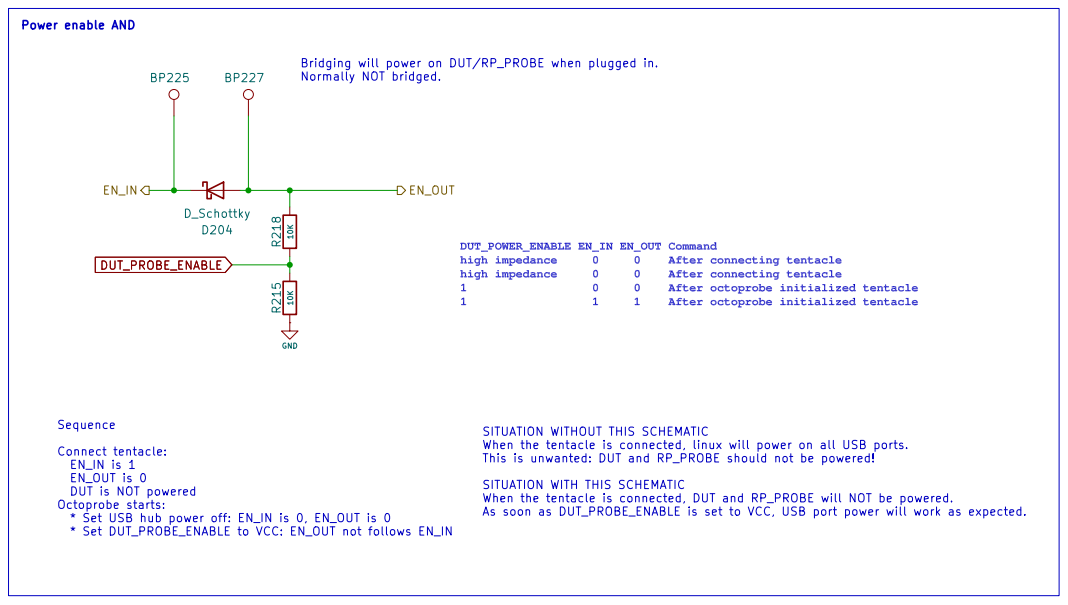
[picture p53: page 20]

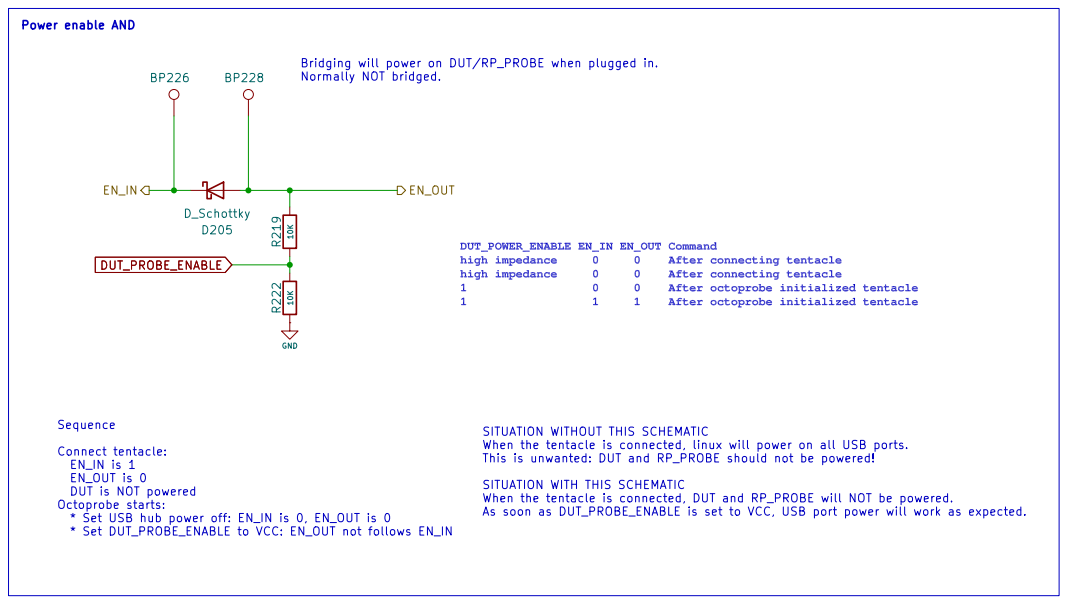
[picture p54: page 21]
