octoprobe/tentacle/kicad/tentacle_v0.8/production_v0.8/schematics_tentacle_v0.8.pdf

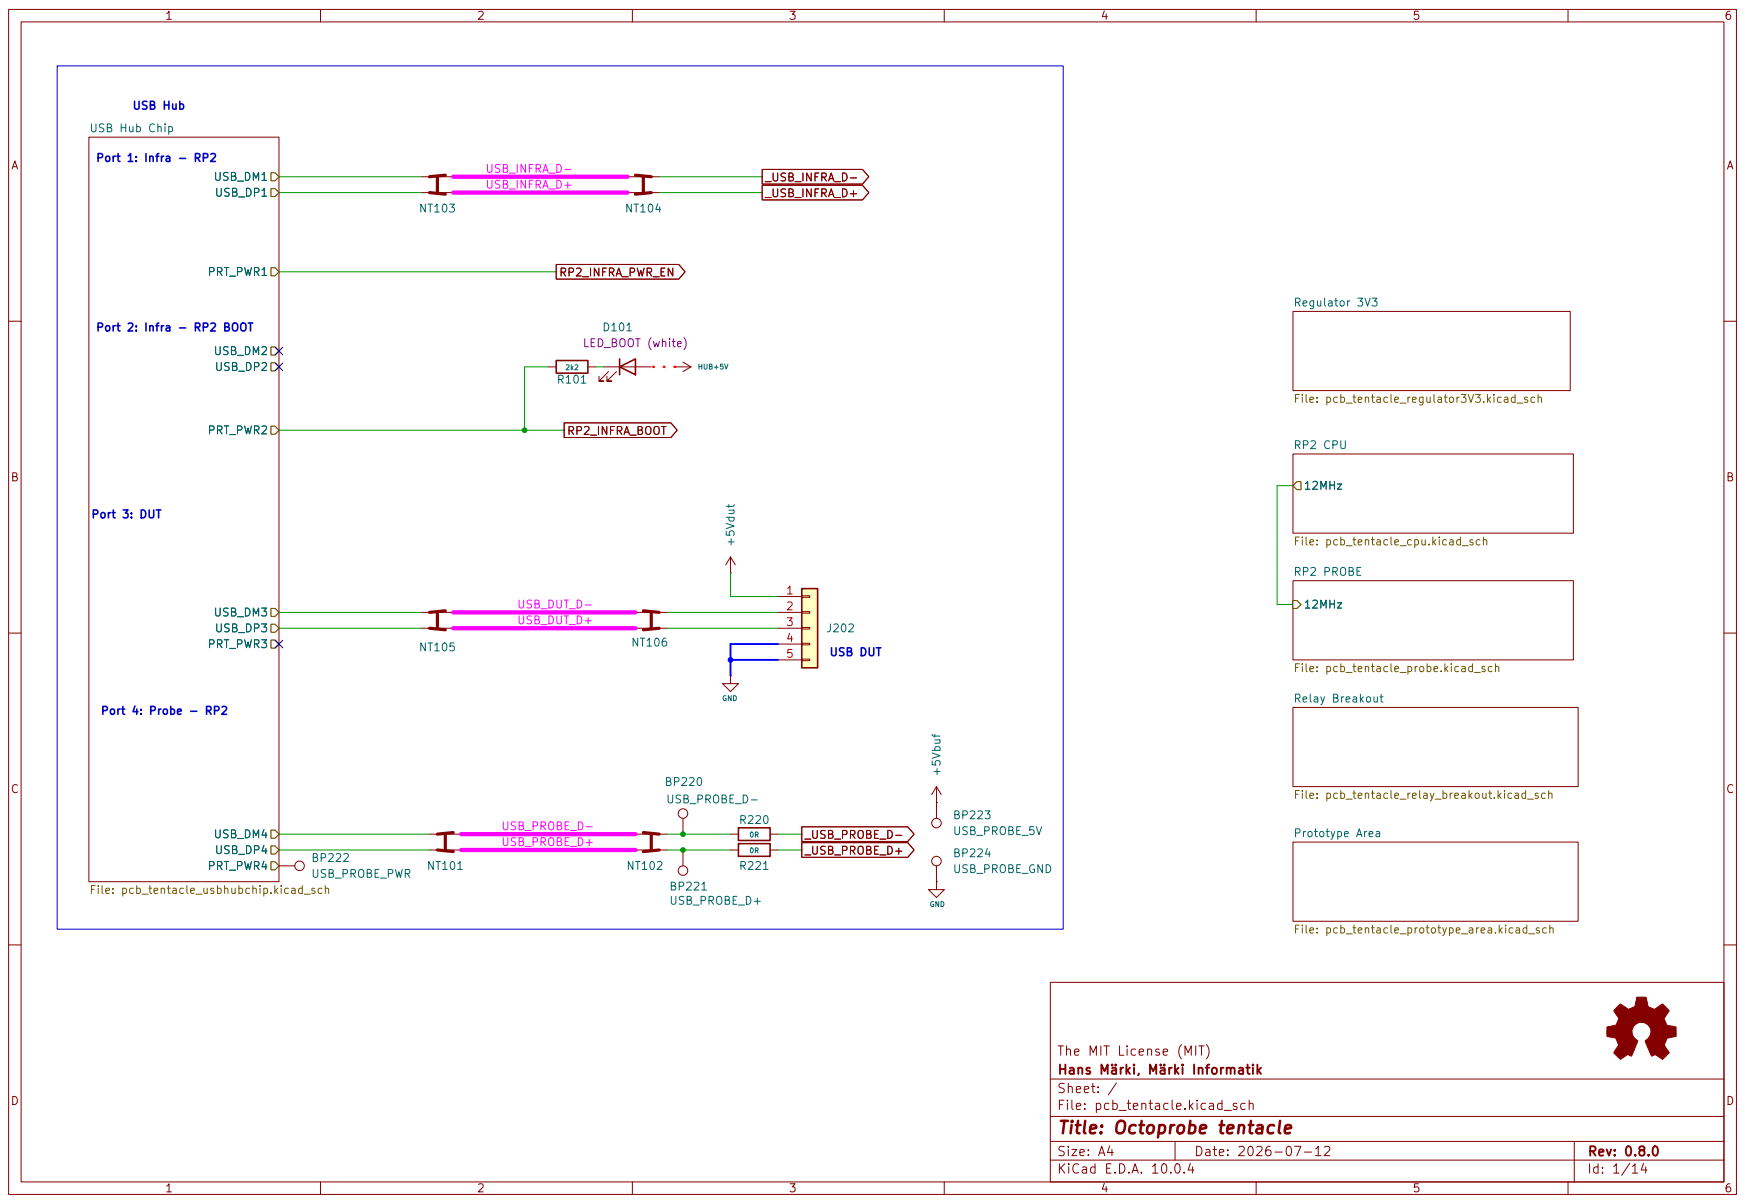
[picture p55: page 1]

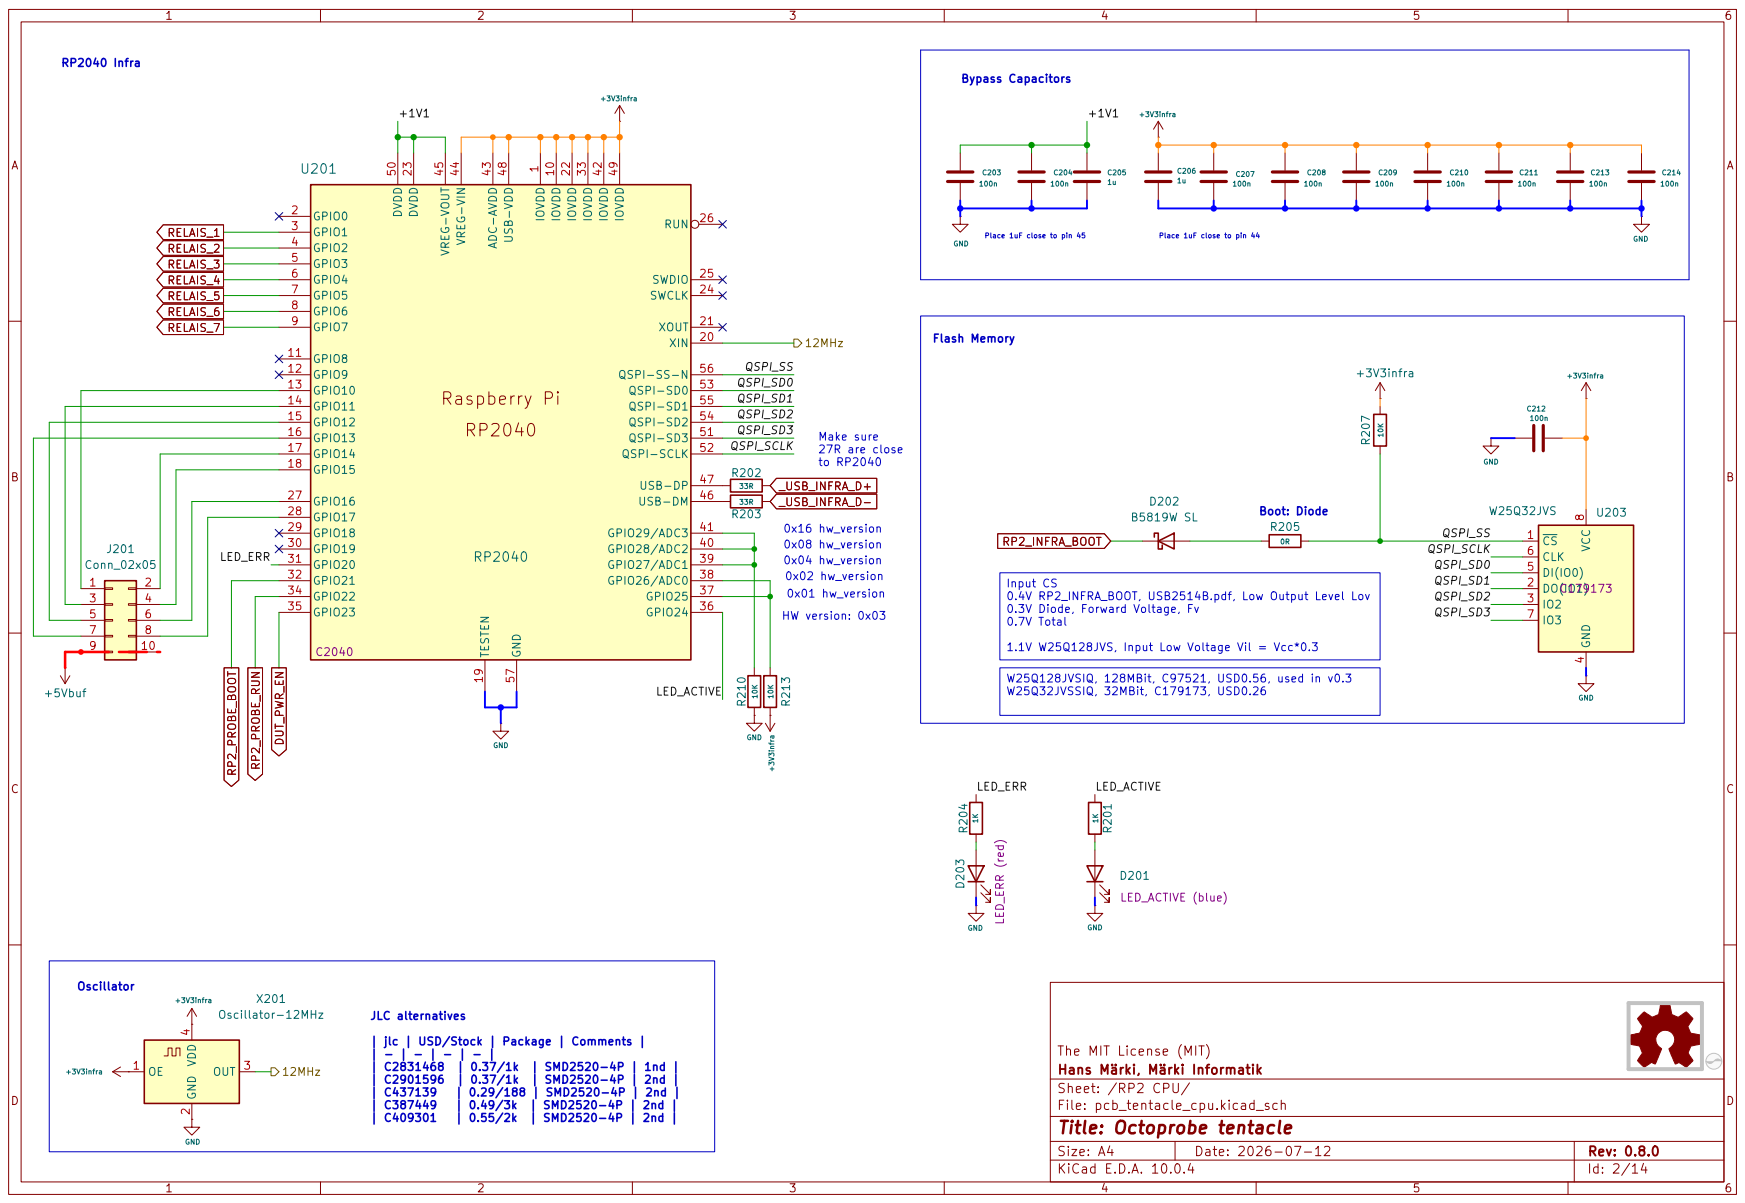
[picture p56: page 2]

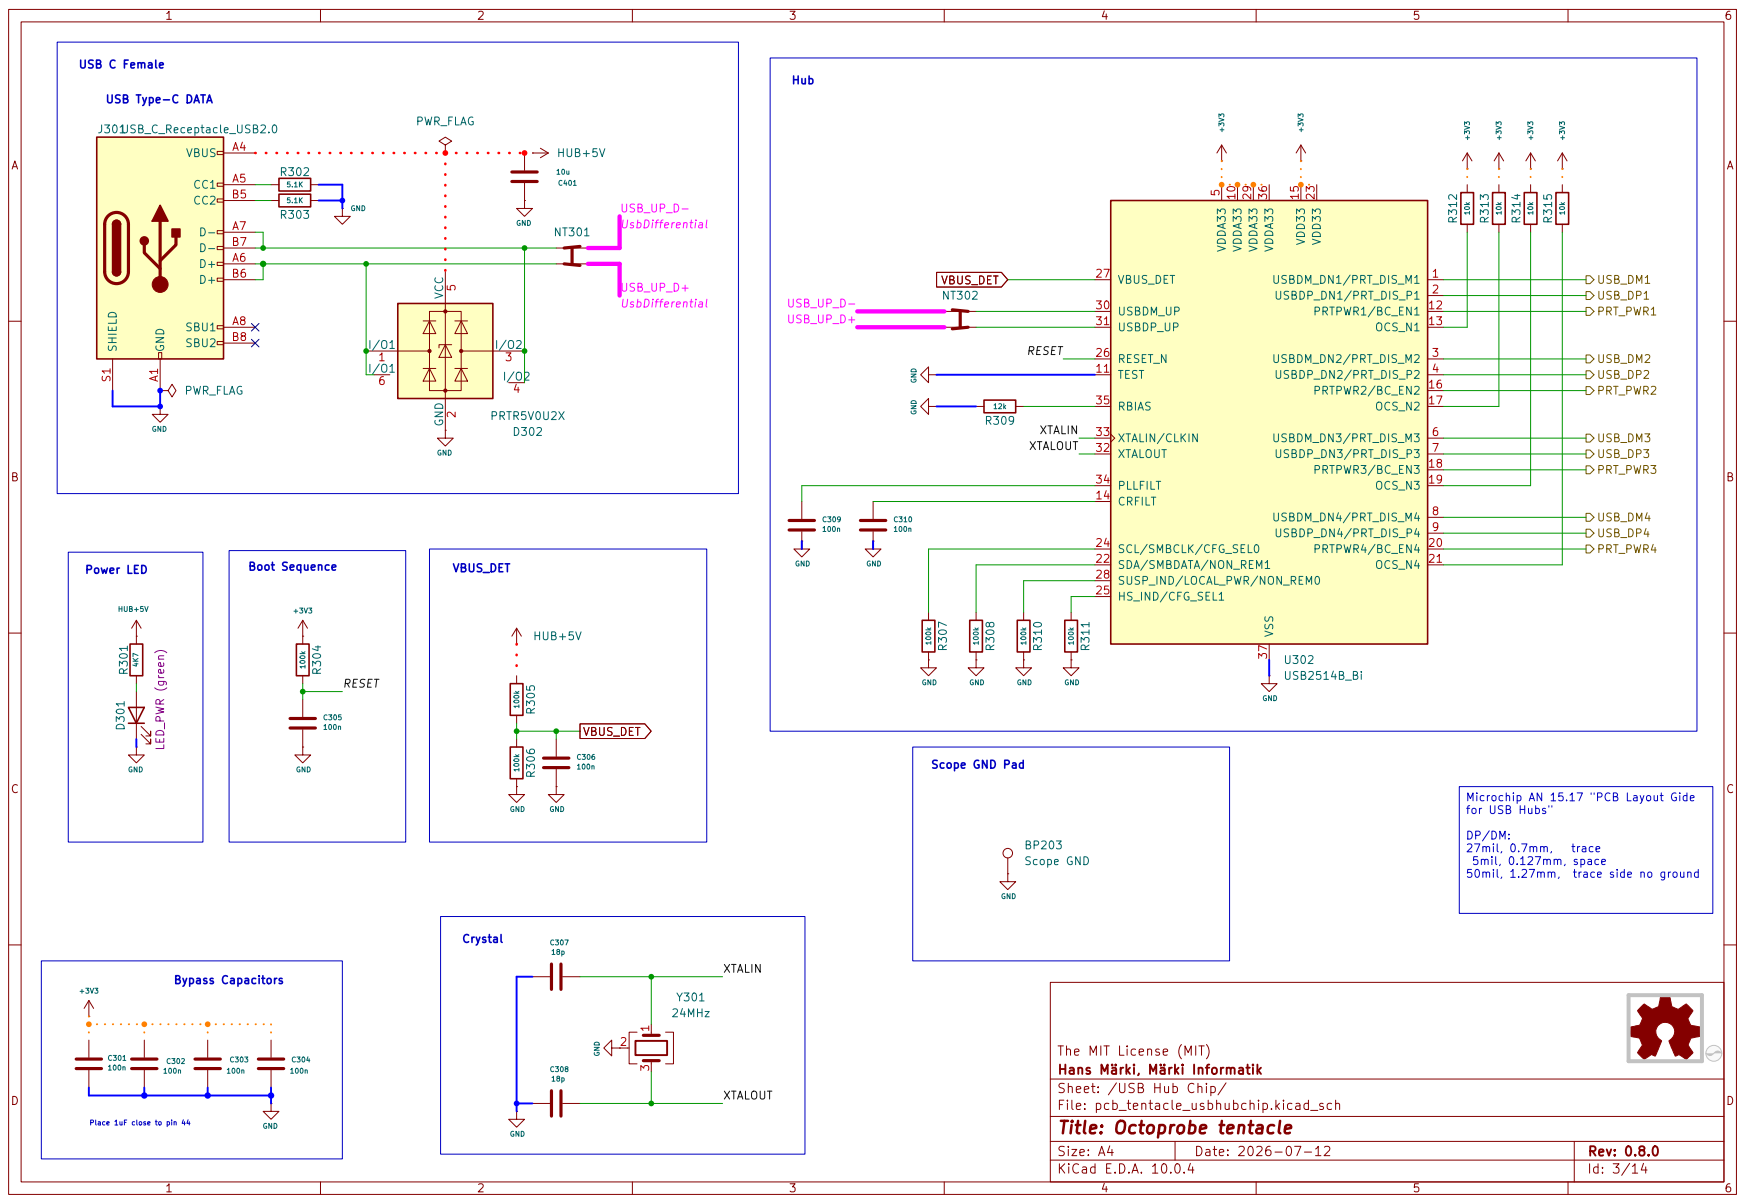
[picture p57: page 3]

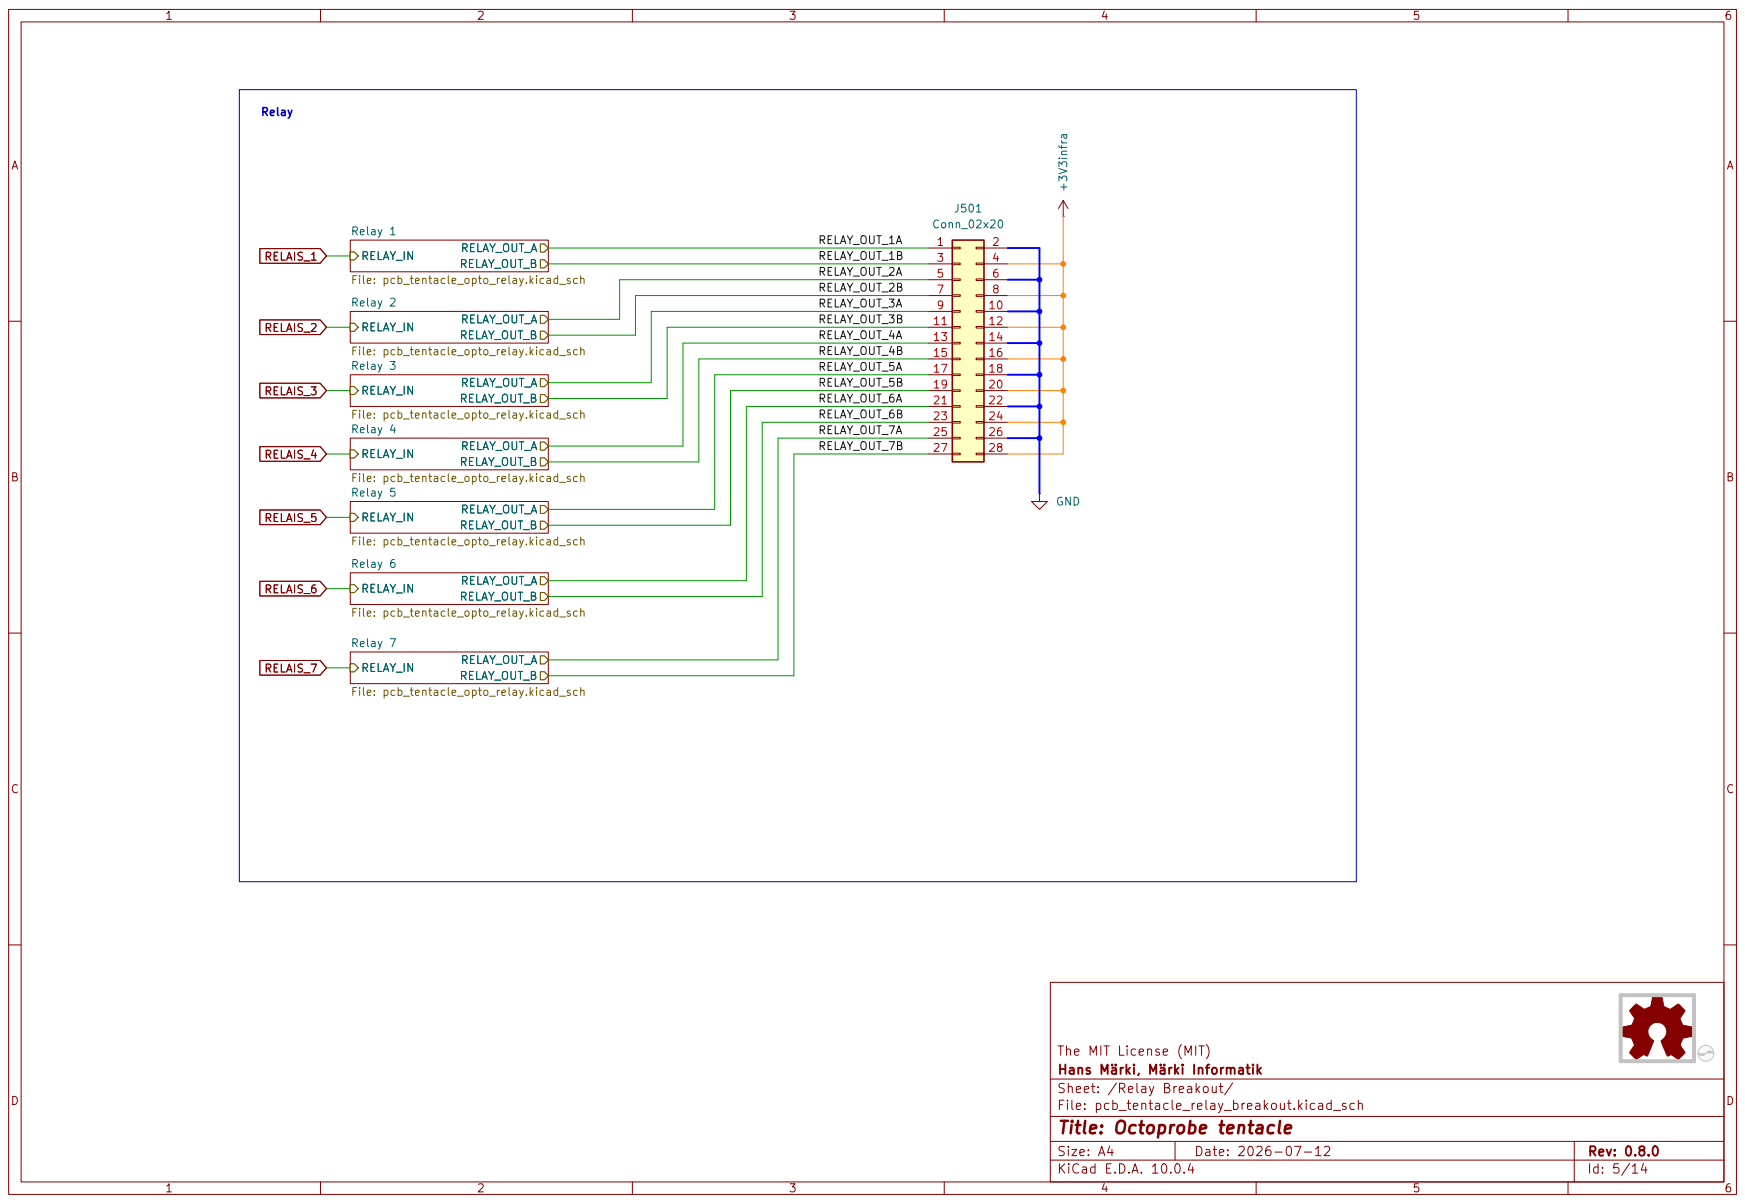
[picture p58: page 4]








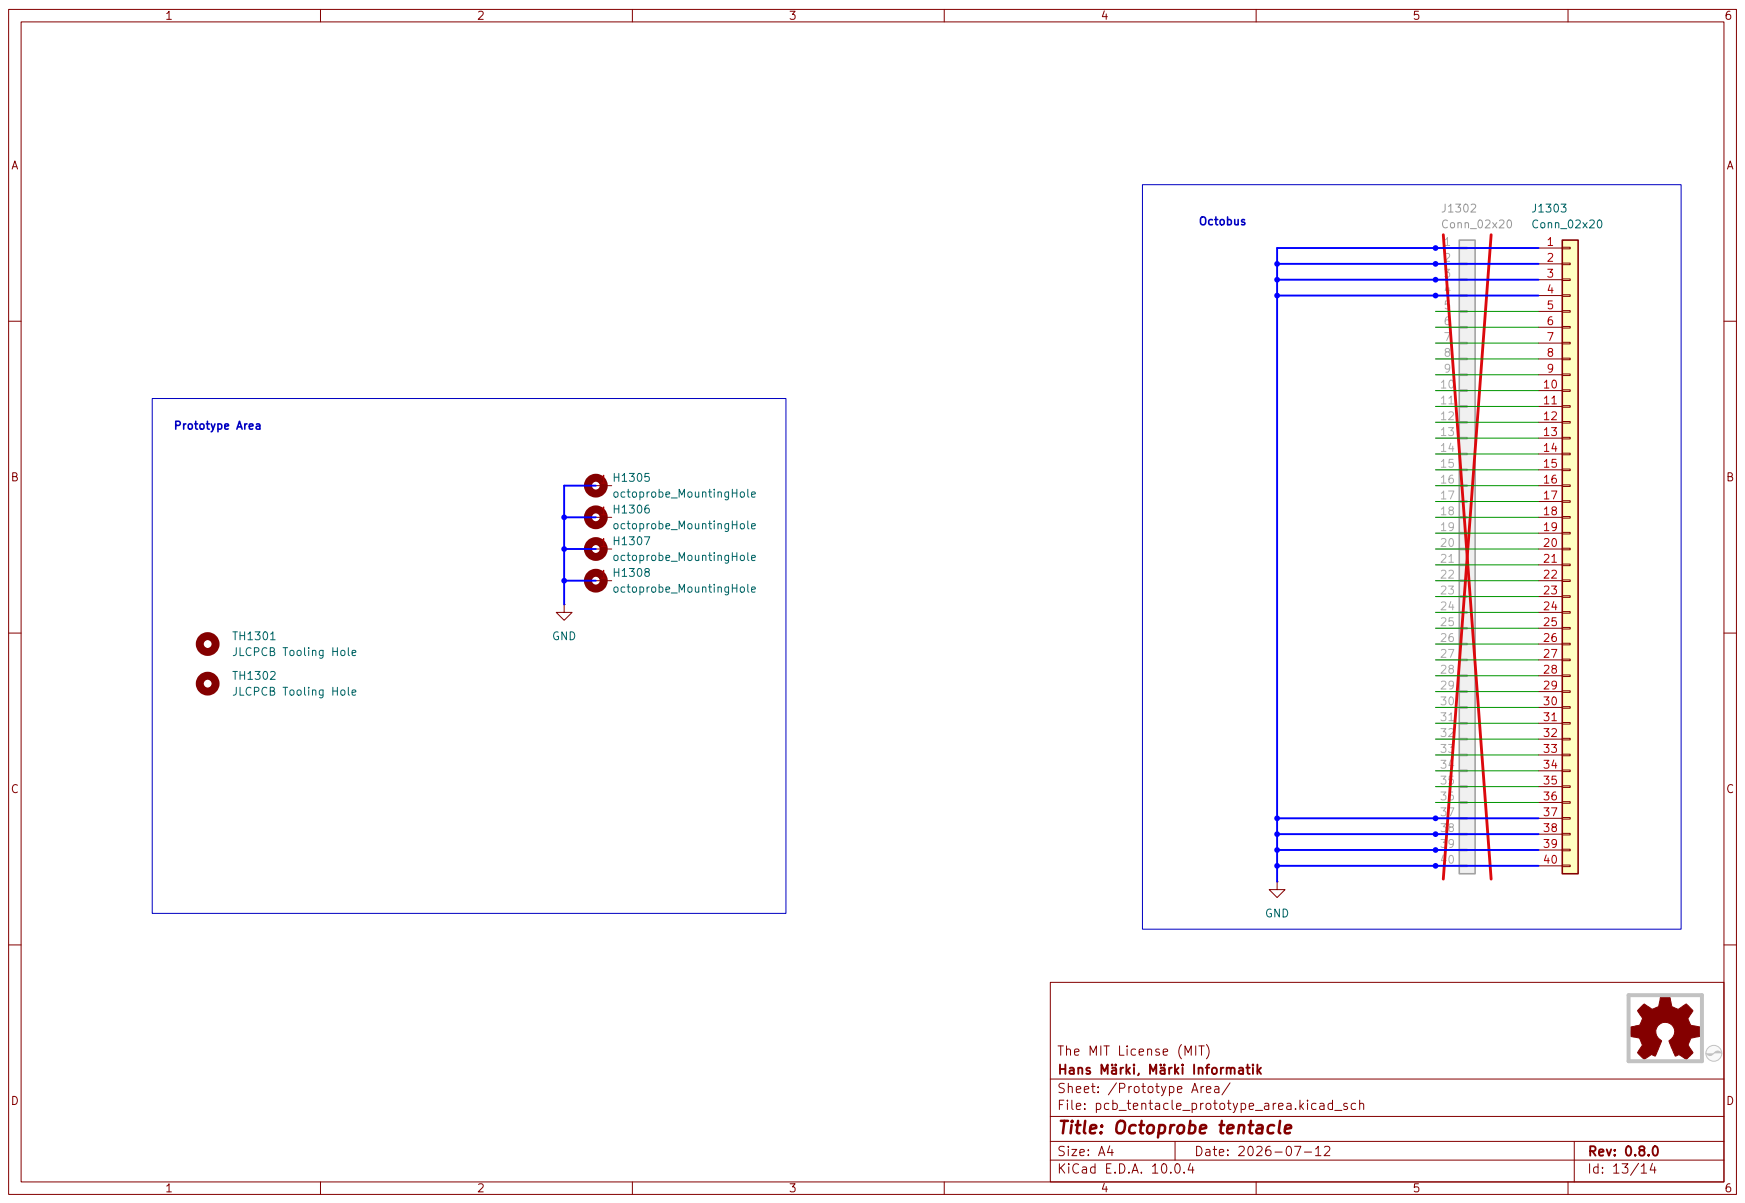
[picture p59: page 12]

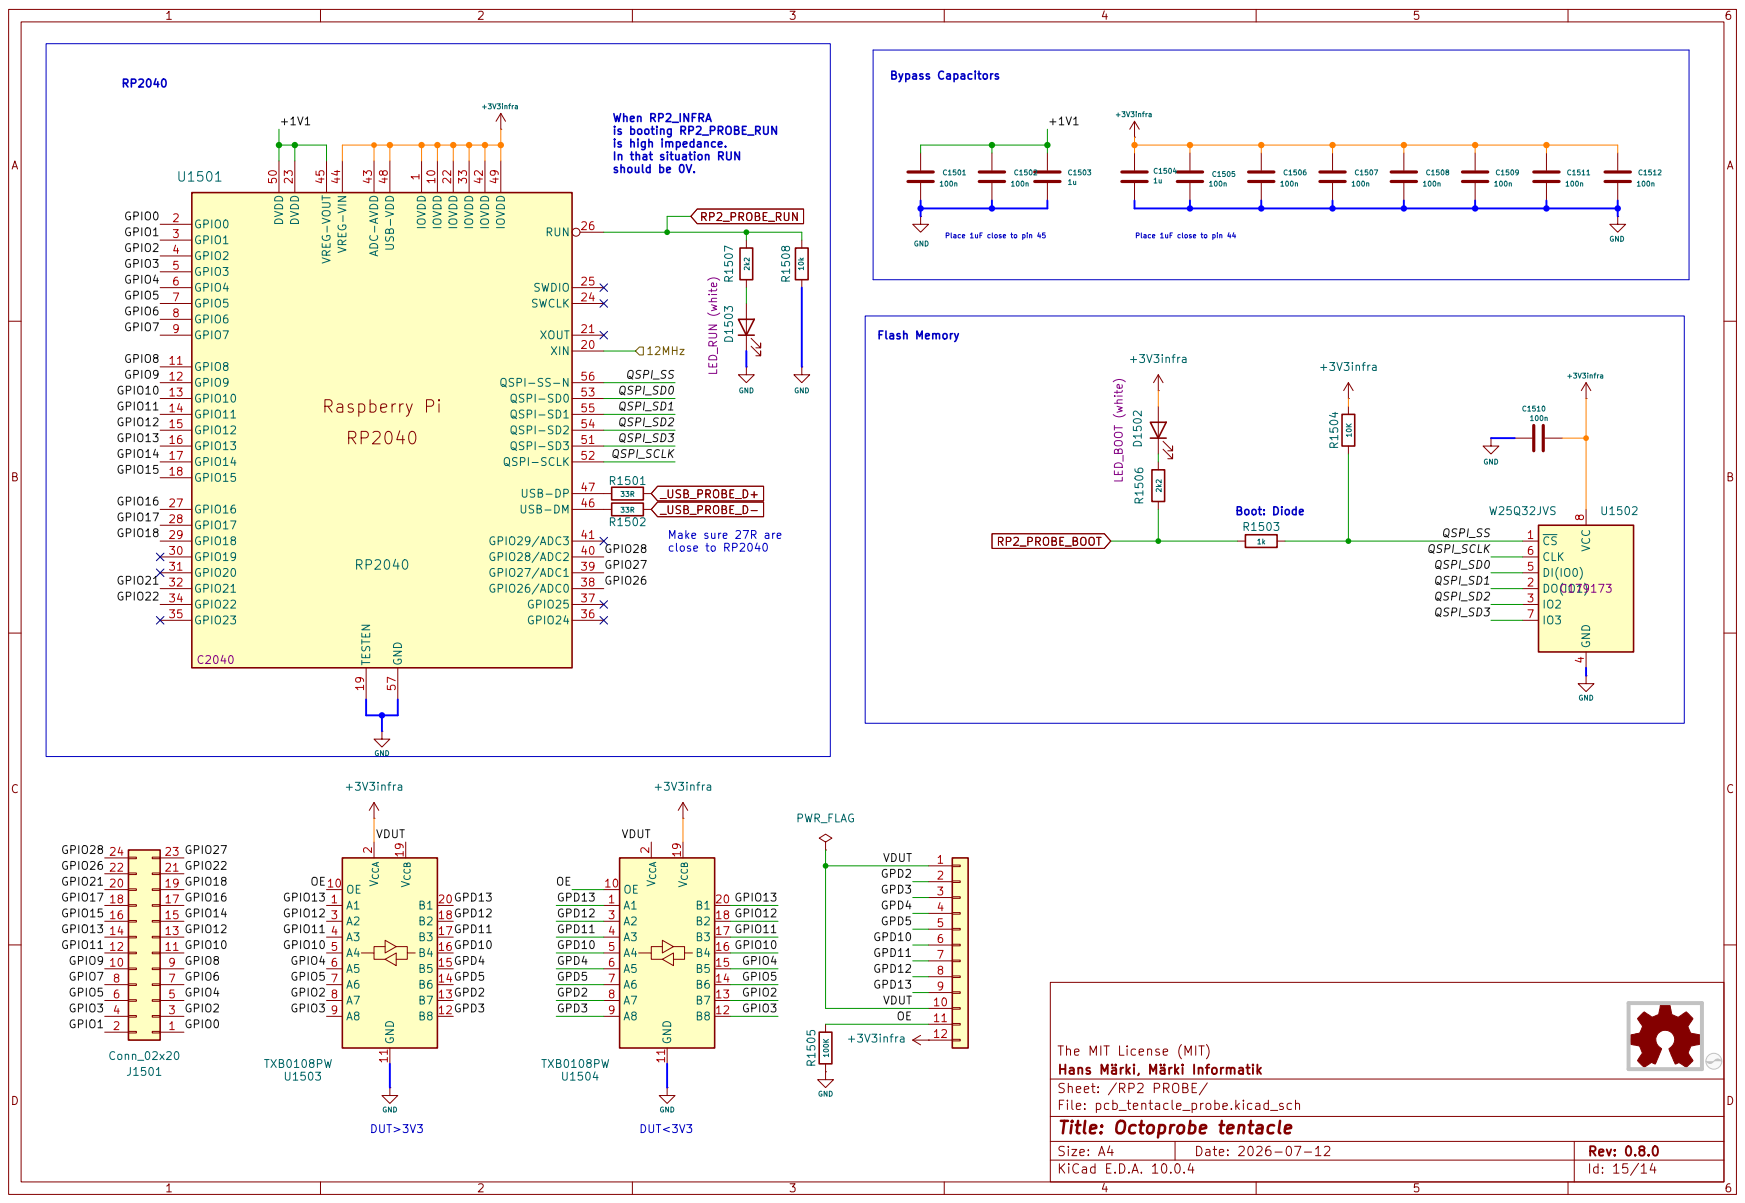
[picture p60: page 13]

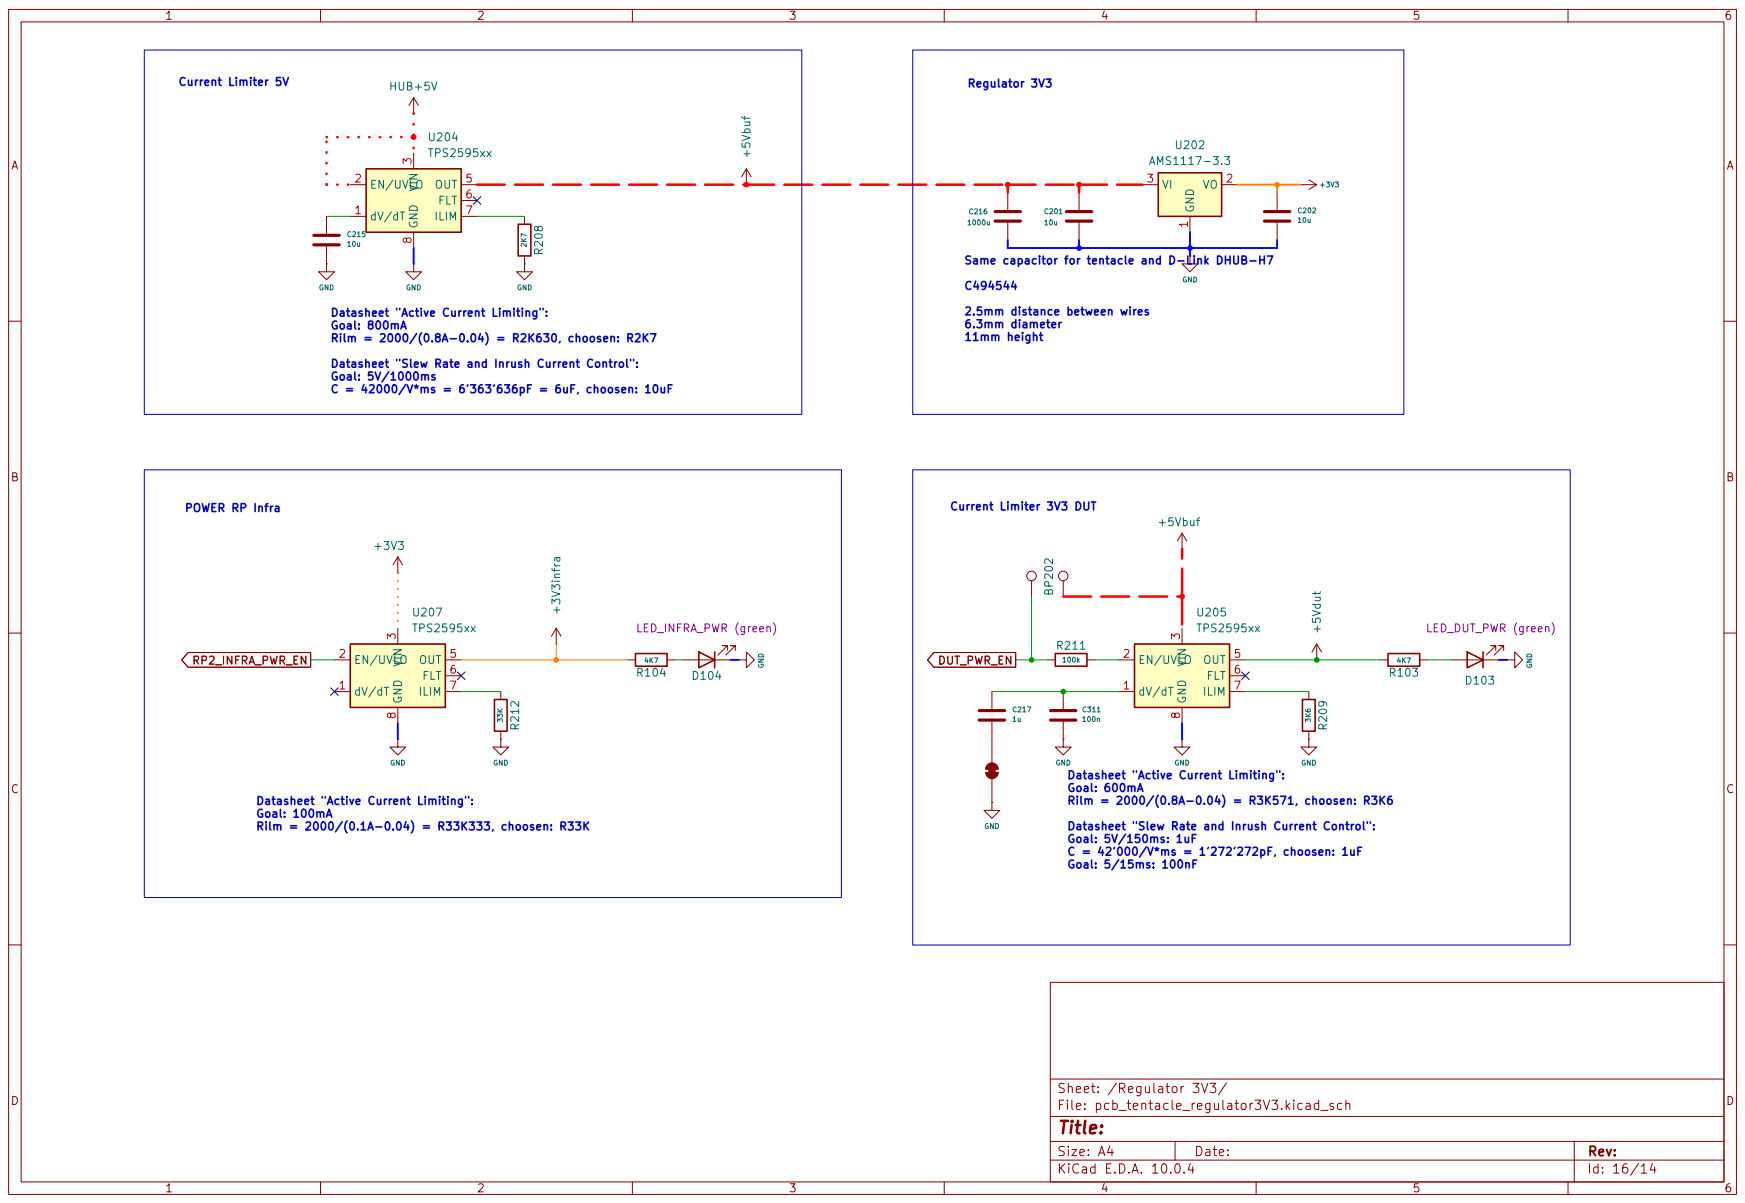
[picture p61: page 14]
