octoprobe/tentacle/kicad/tentacle/production_v0.4/schematics.pdf

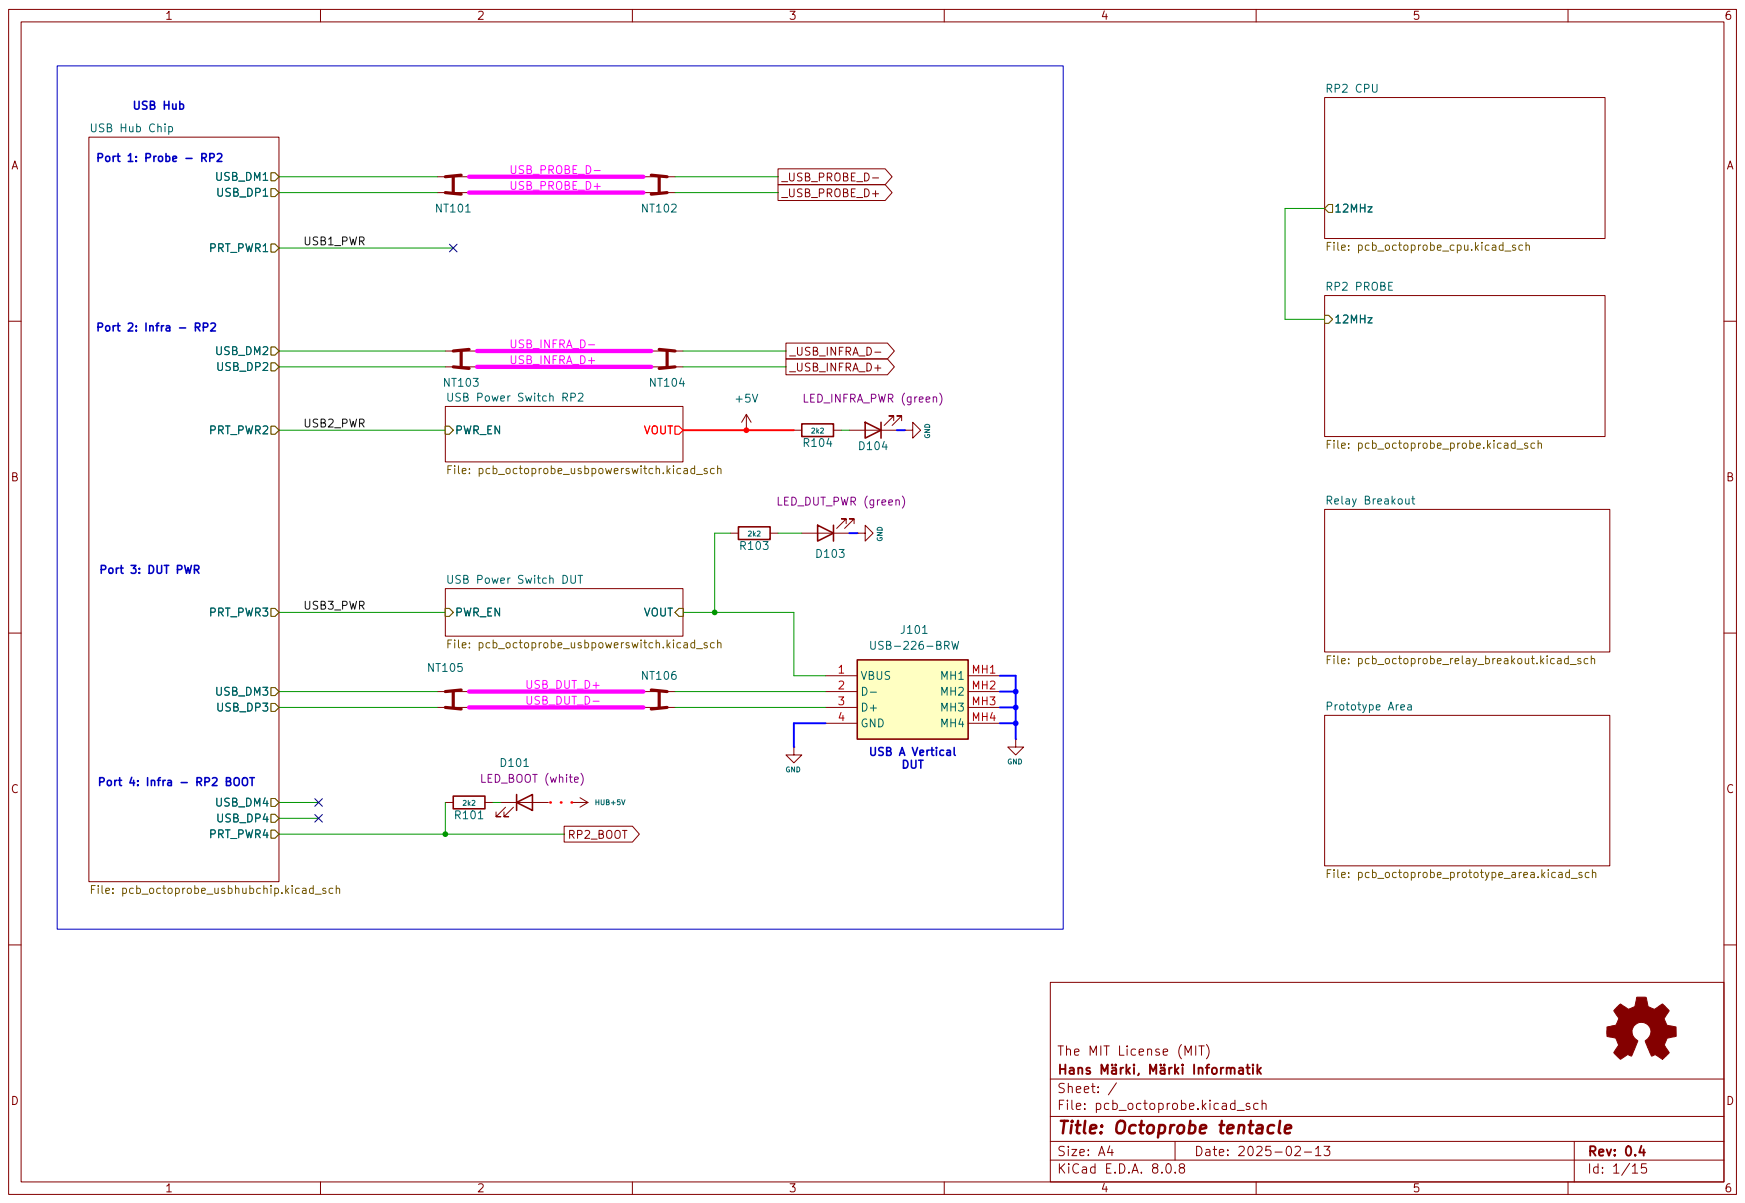
[picture p62: page 1]

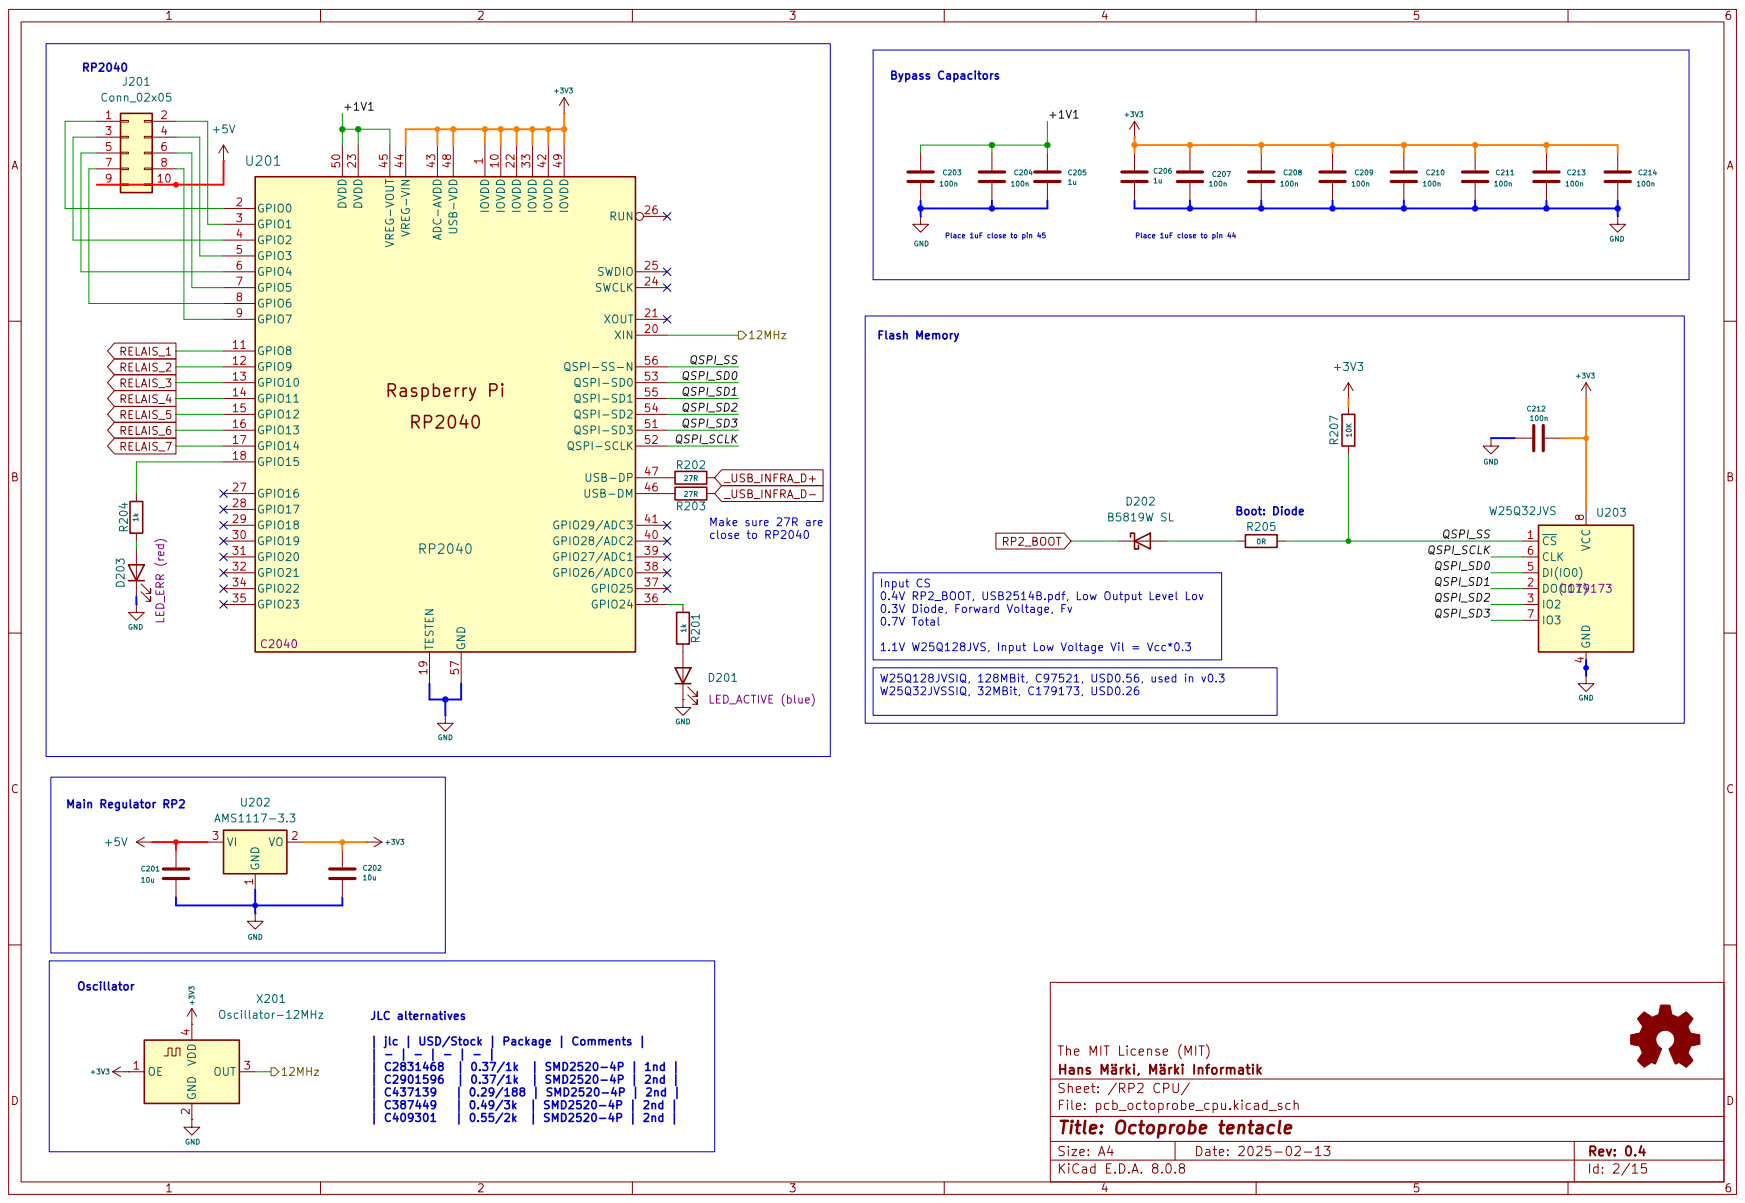
[picture p63: page 2]

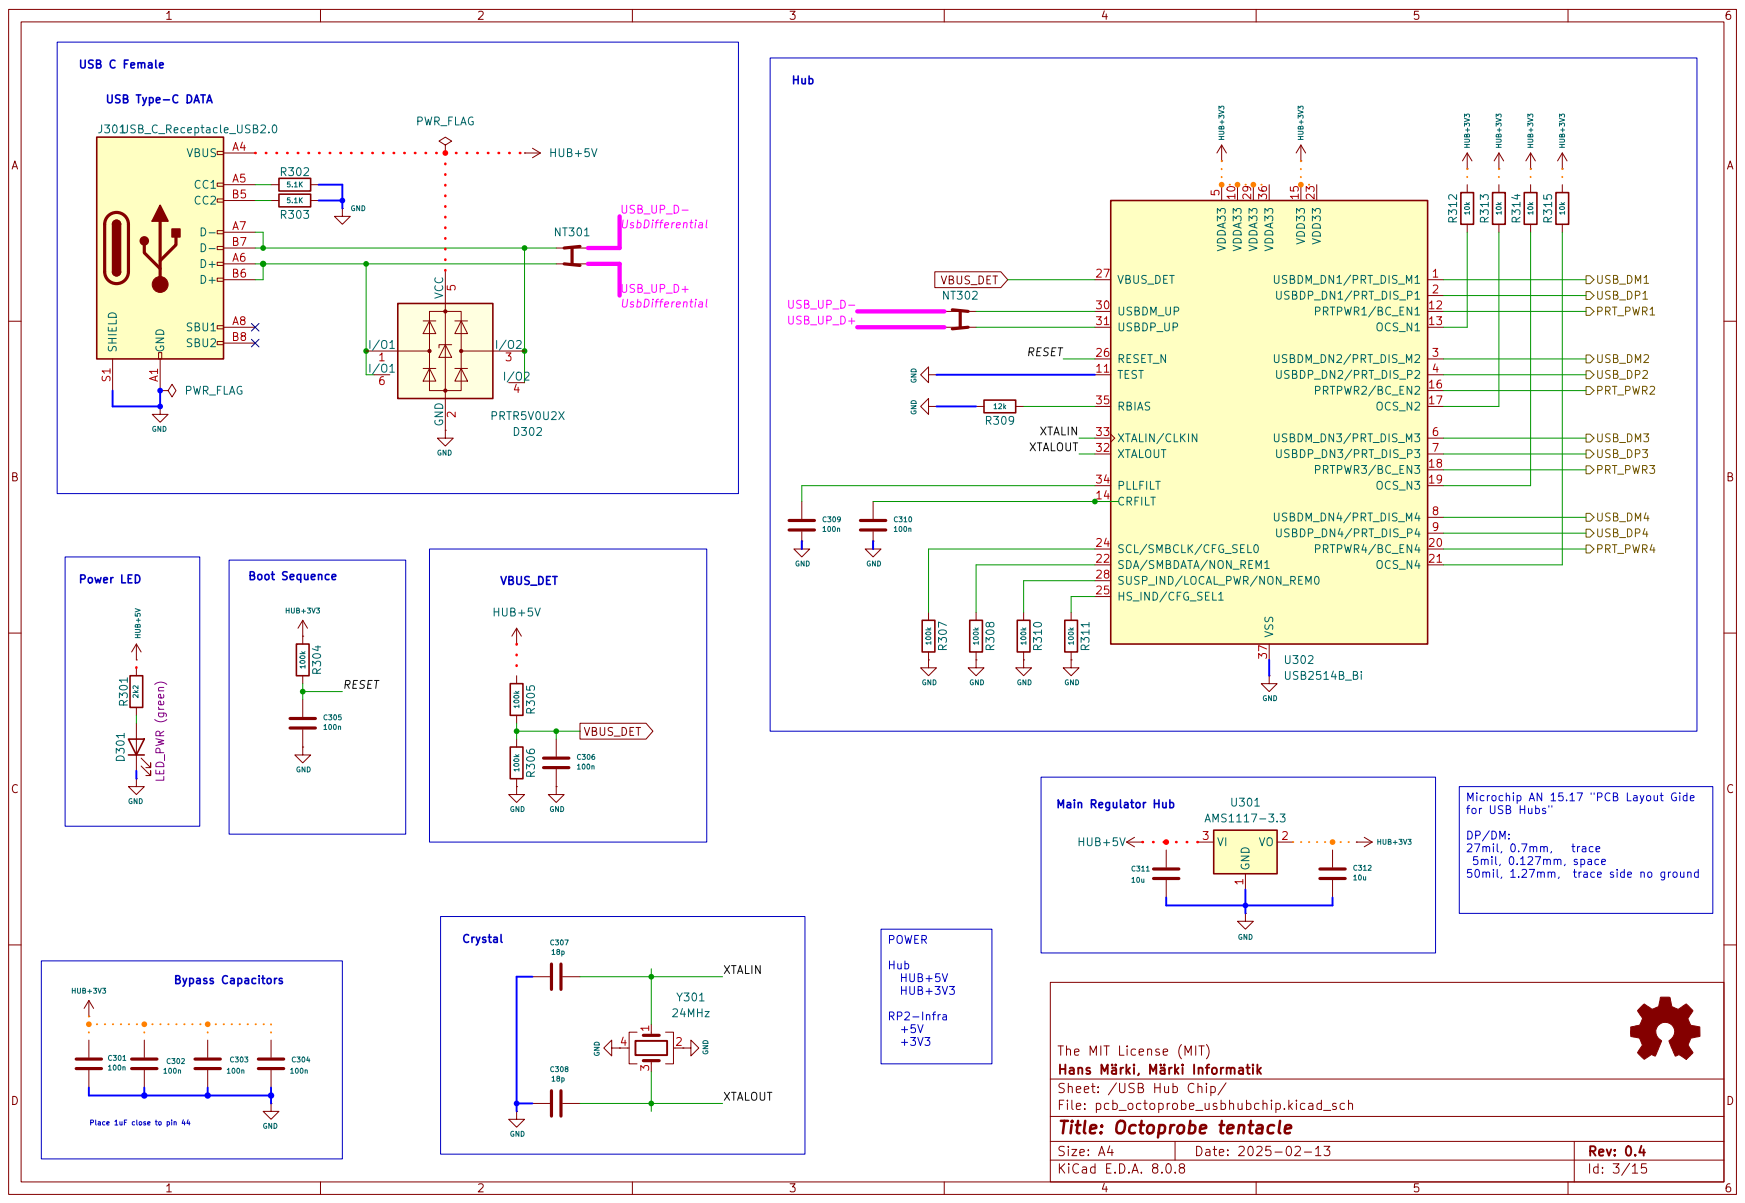
[picture p64: page 3]

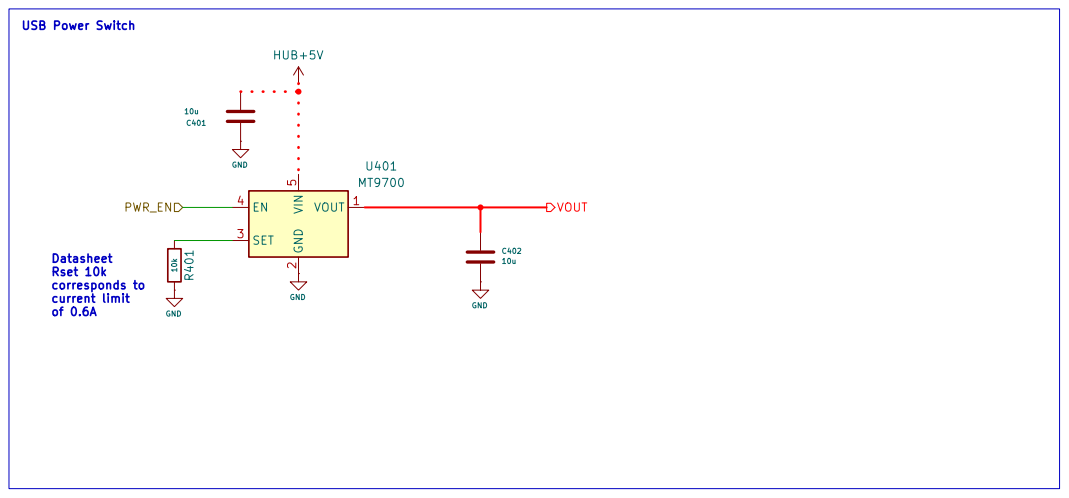
[picture p65: page 4]

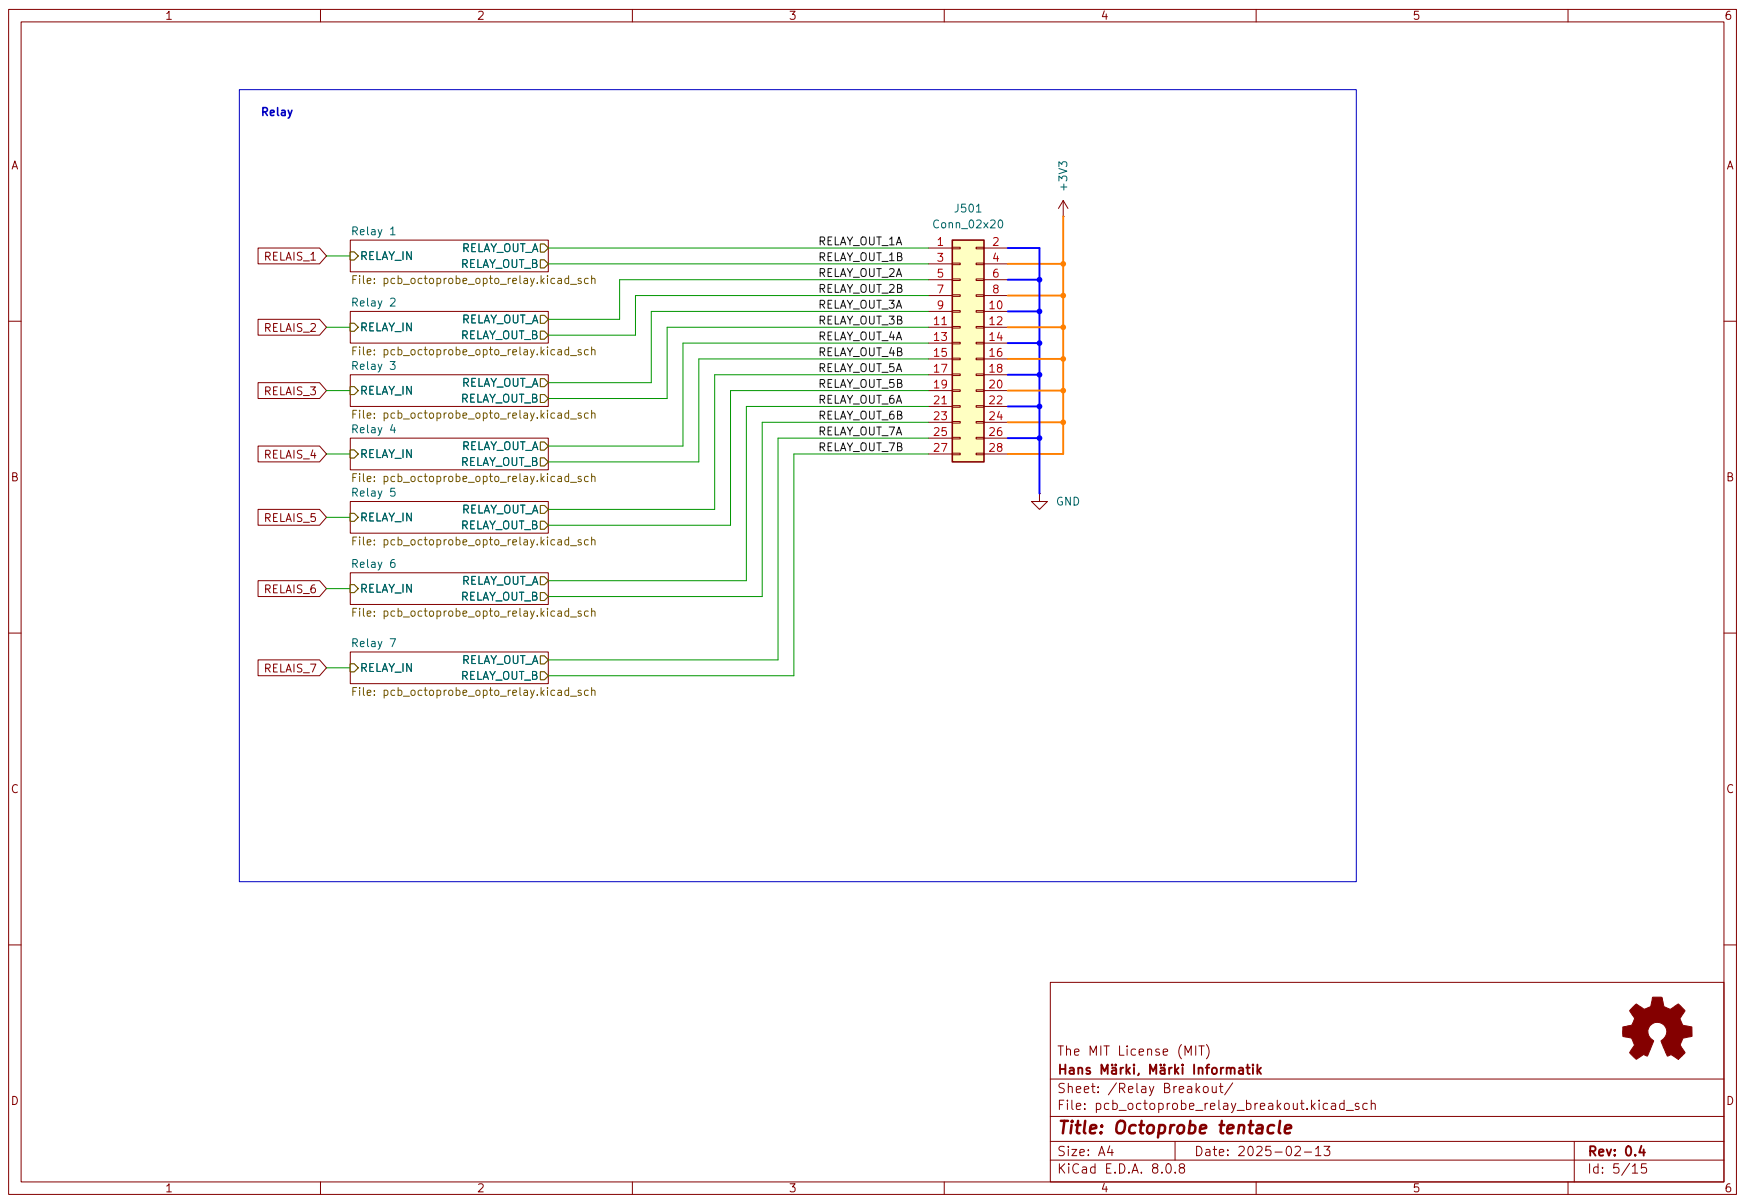
[picture p66: page 5]

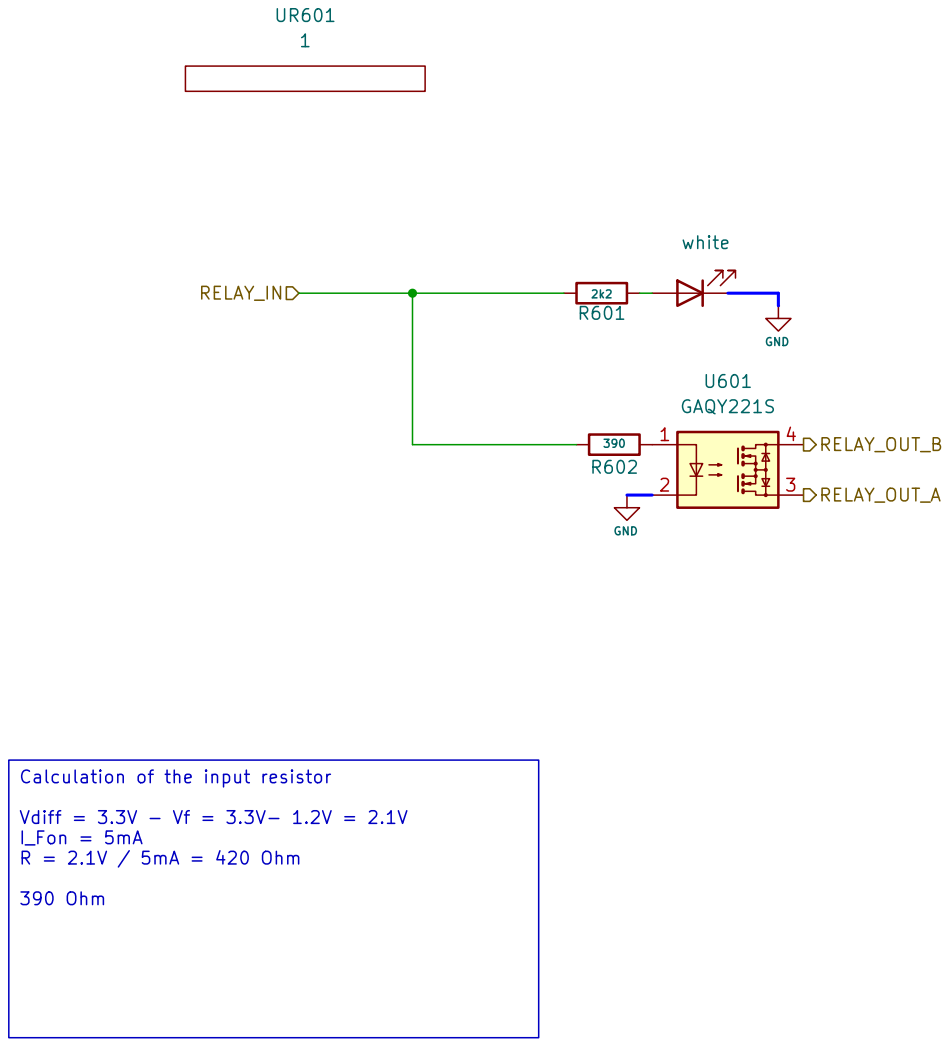
[picture p67: page 6]

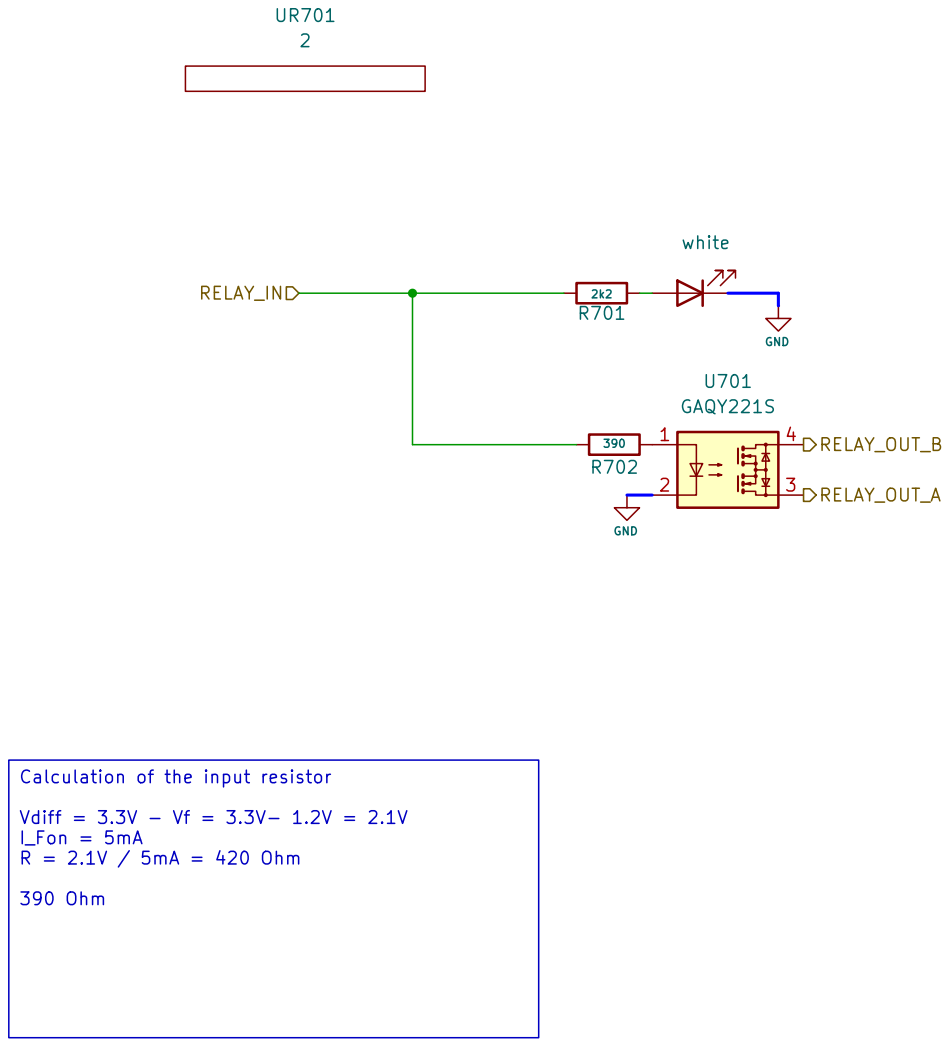
[picture p68: page 7]

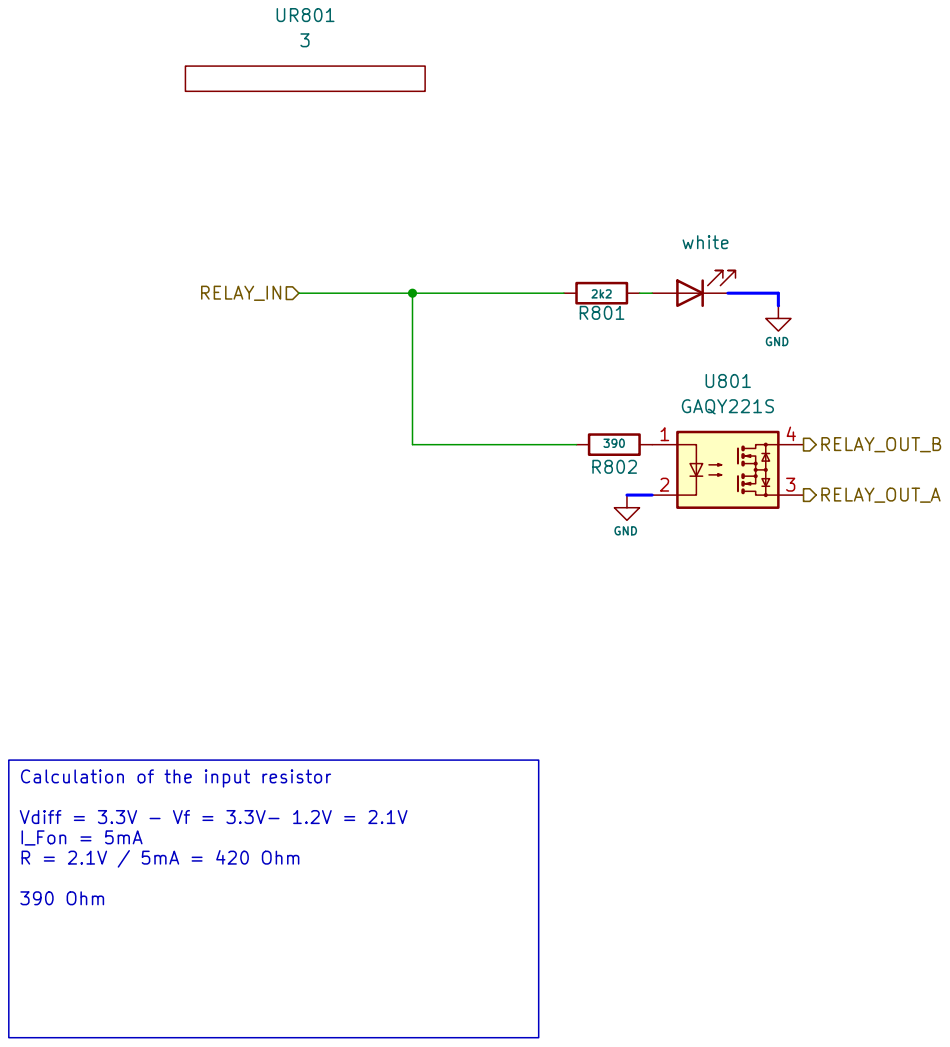
[picture p69: page 8]

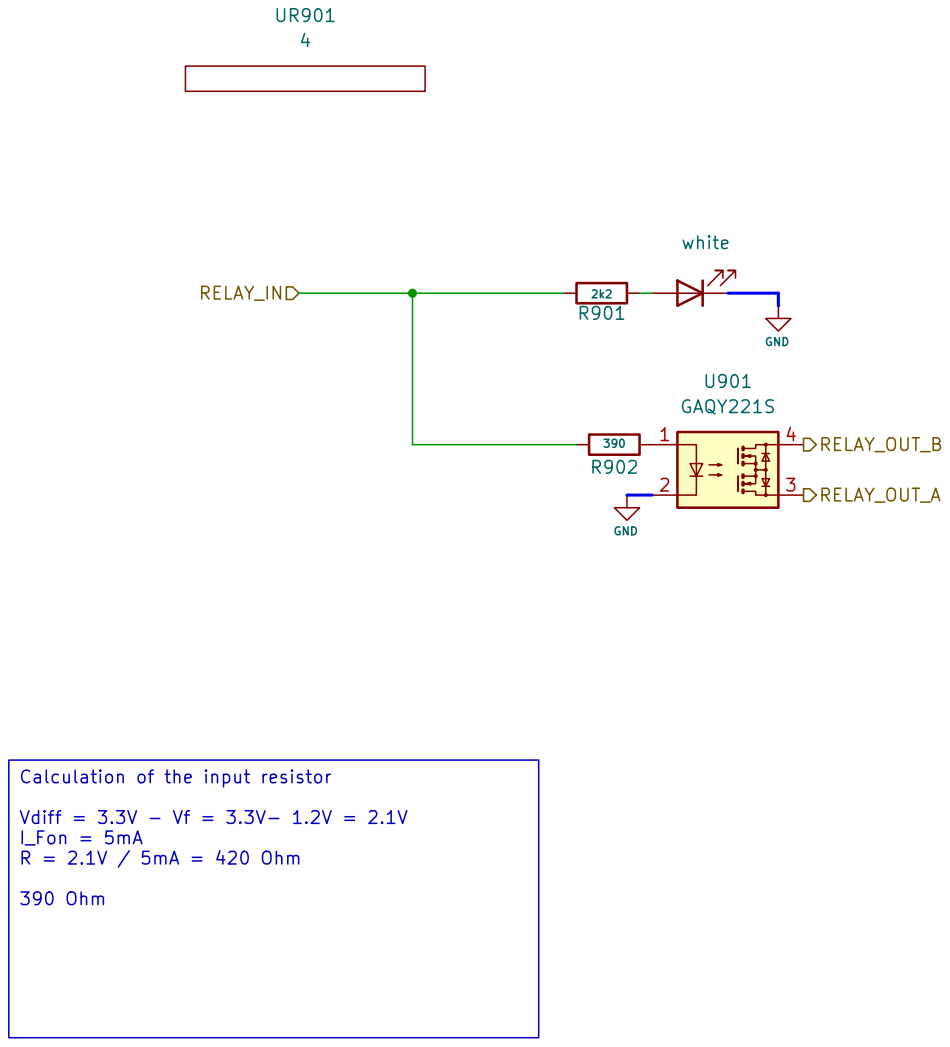
[picture p70: page 9]

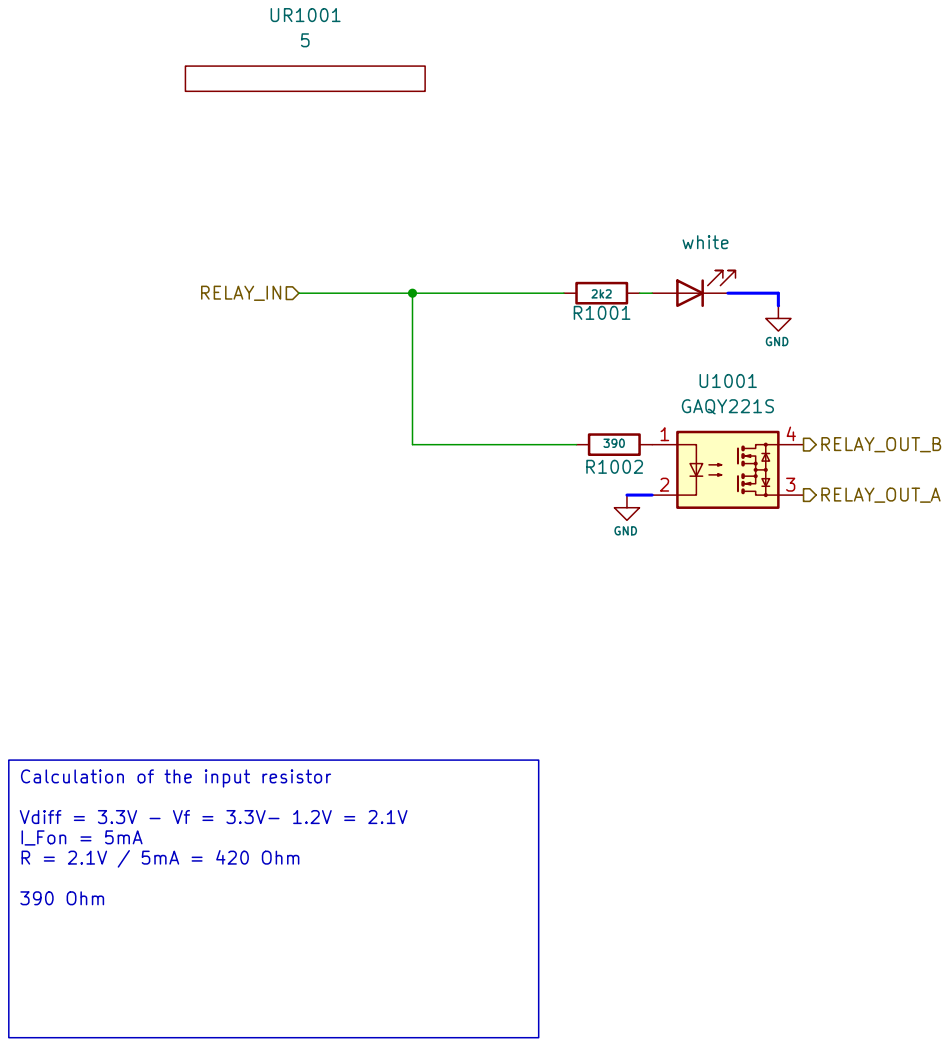
[picture p71: page 10]

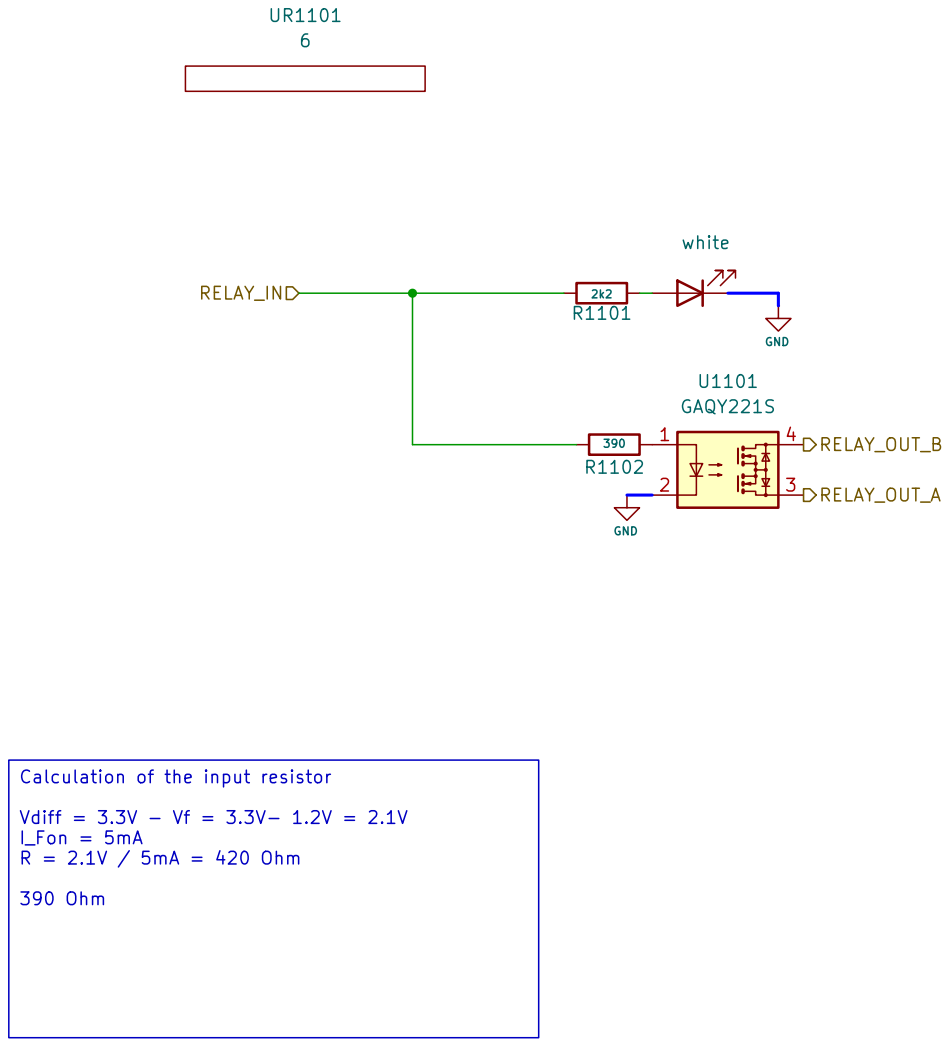
[picture p72: page 11]

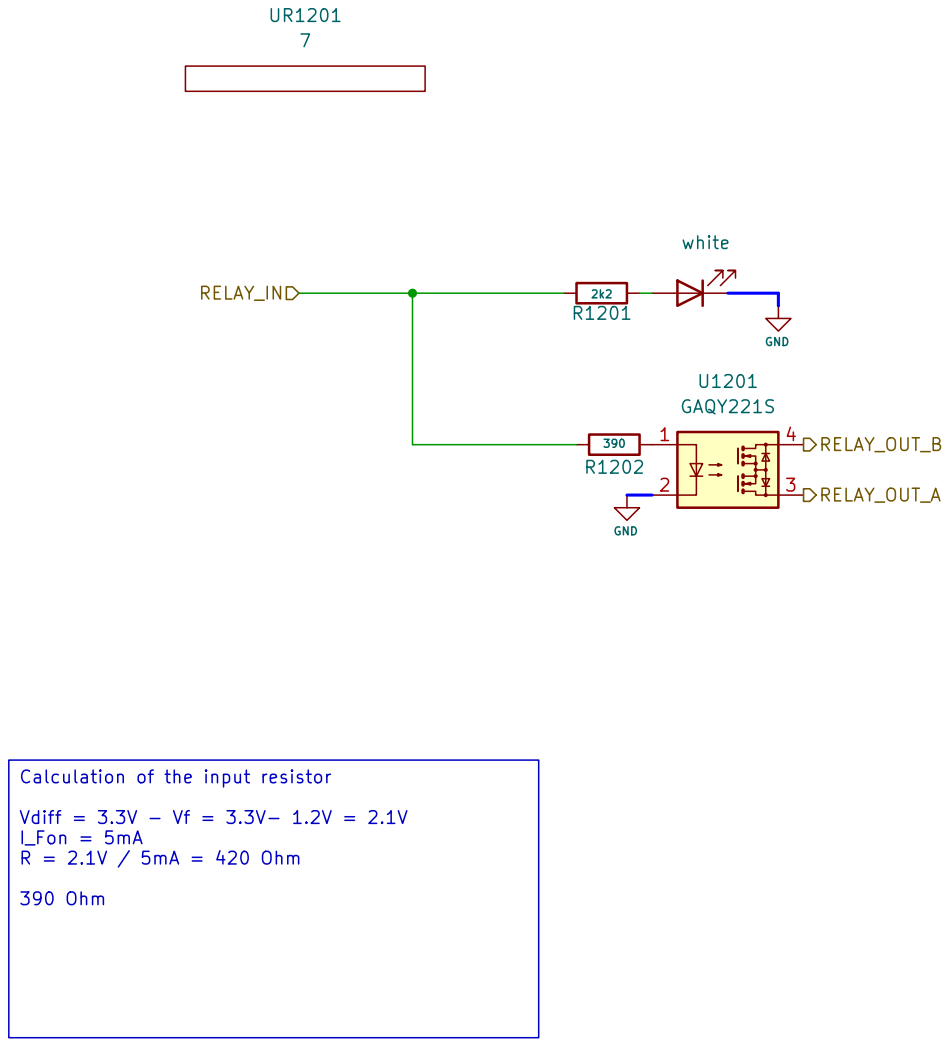
[picture p73: page 12]

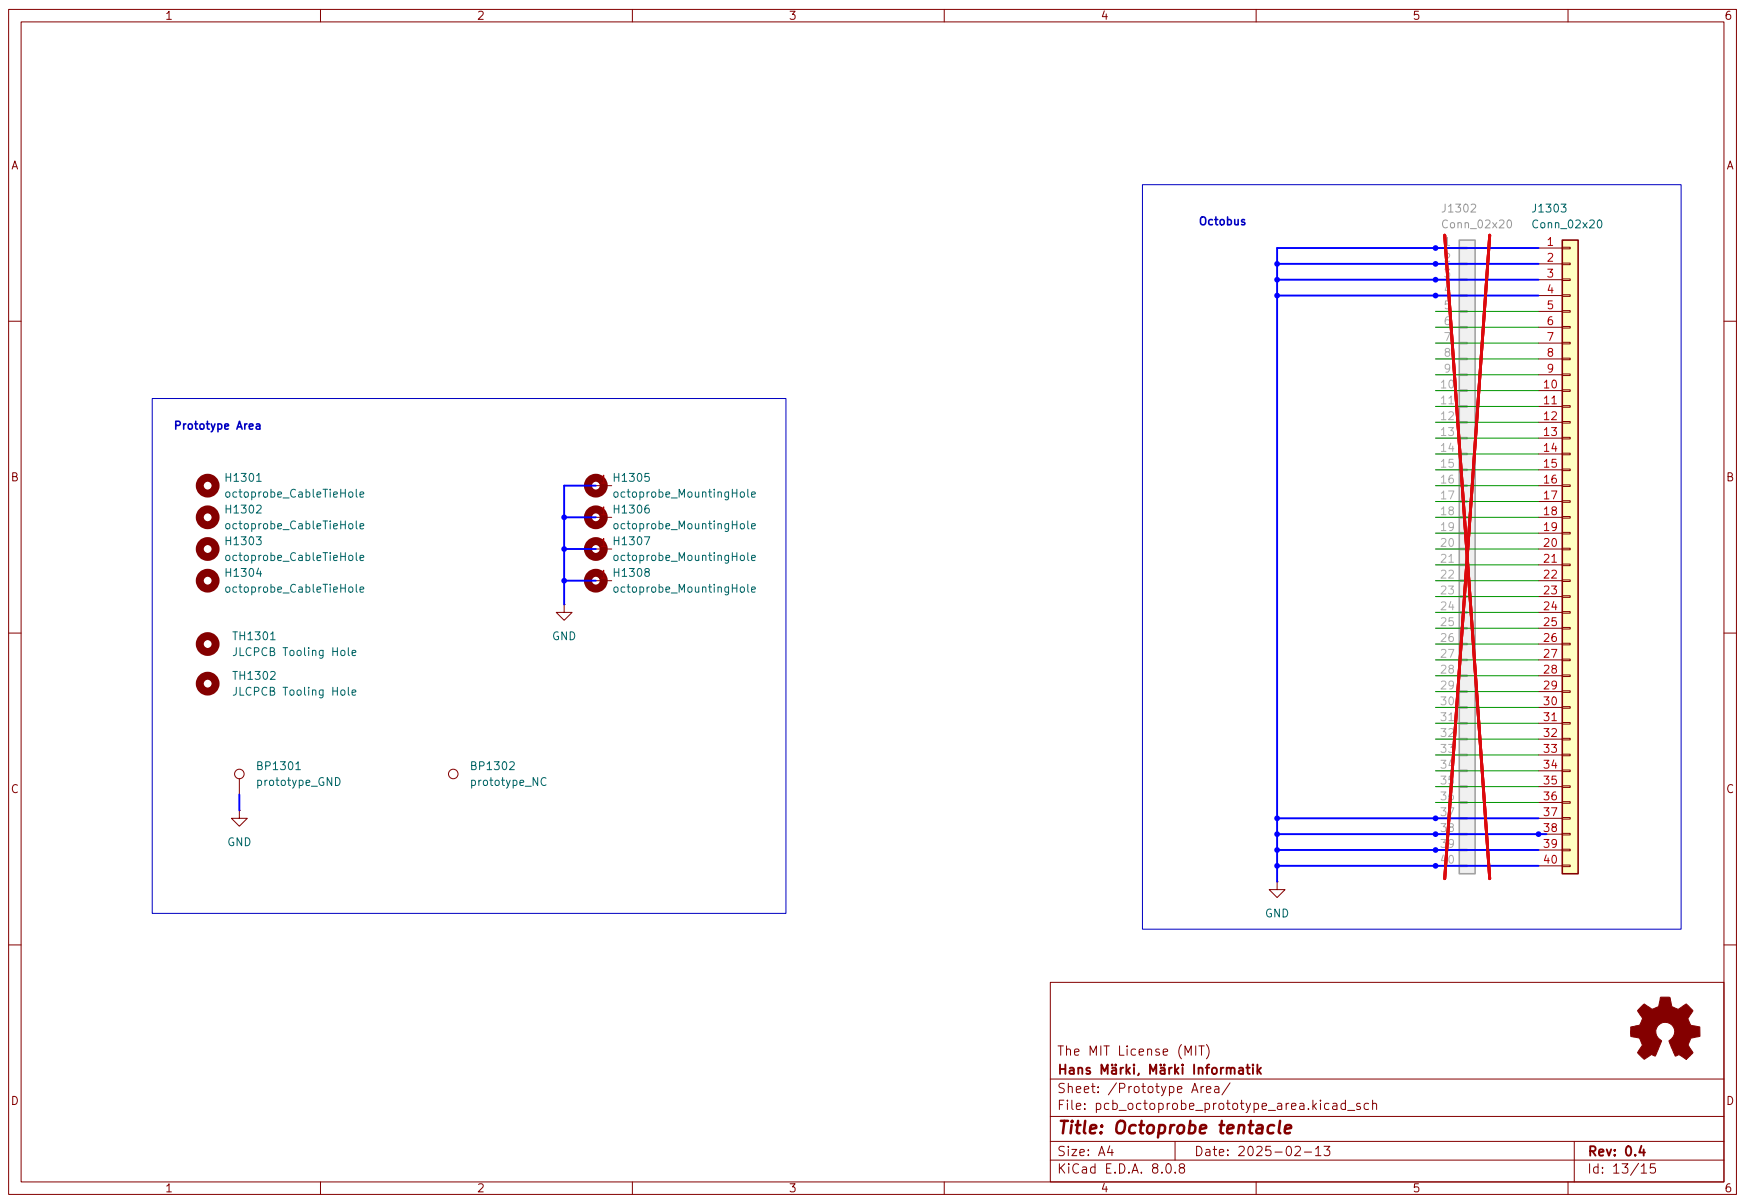
[picture p74: page 13]

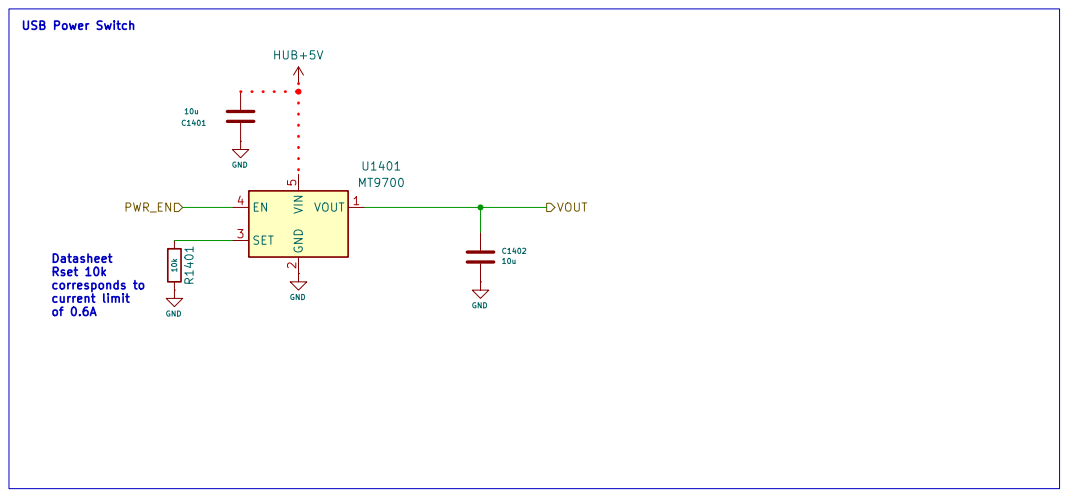
[picture p75: page 14]

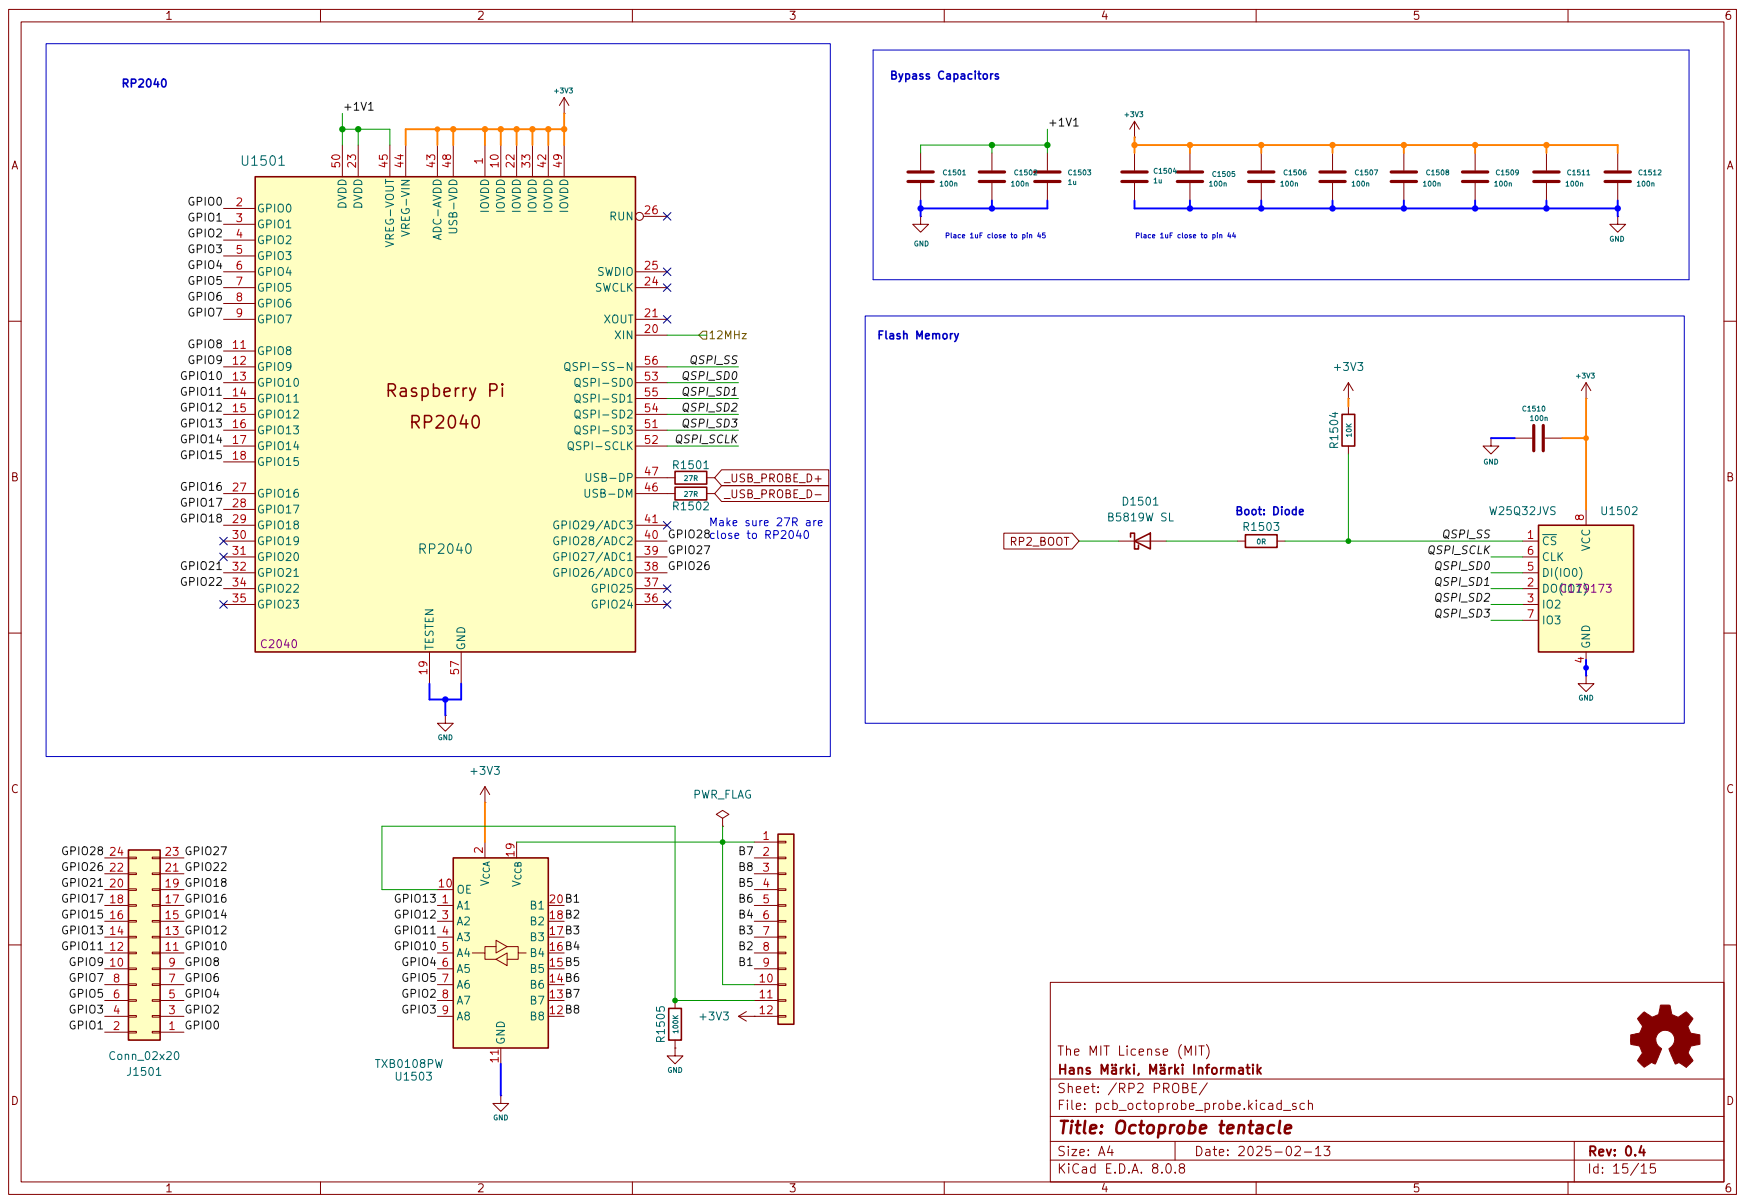
[picture p76: page 15]
