octoprobe/tentacle/(commit log)

2024-08-17 Copied from github.com/hmaerki/experiment_microoctopus
    [20240719b_bolzone.FCStd, 20240719b_bolzone.stl, TS-1187A-B-A-B.step, TYPE-C-31-M-12--3DModel-STEP-56544.STEP, USB-226-BRW.stp, bom.csv, designators.csv, pcb_octoprobe.kicad_pcb]
2025-02-06 Rename kicad folder. Update version number
    [TS-1187A-B-A-B.step, TYPE-C-31-M-12--3DModel-STEP-56544.STEP, USB-226-BRW.stp, bom.csv, designators.csv, pcb_octoprobe.kicad_pcb, pcb_octoprobe.kicad_sch, pcb_octoprobe_cpu.kicad_sch]
2025-02-25 Tentacle v0.4
    [bom.csv, designators.csv, pcb_octoprobe.kicad_pcb, pcb_octoprobe.kicad_sch, pcb_octoprobe_cpu.kicad_sch, pcb_octoprobe_opto_relay.kicad_sch, pcb_octoprobe_probe.kicad_sch, pcb_octoprobe_prototype_area.kicad_sch]
2025-02-25 Fix D302
    [designators.csv, pcb_octoprobe.kicad_pcb, pcb_octoprobe_usbhubchip.kicad_sch, positions.csv]
2026-01-20 Tentacle v0.7: Initial commit
    [TS-1187A-B-A-B.step, TYPE-C-31-M-12--3DModel-STEP-56544.STEP, USB-226-BRW.stp, pcb_tentacle.kicad_pcb, pcb_tentacle.kicad_sch, pcb_tentacle_cpu.kicad_sch, pcb_tentacle_gnd.kicad_sch, pcb_tentacle_opto_relay.kicad_sch]
2026-01-20 Tentacle v0.7: Fix LEDs. Import new symbols and footprints
    [pcb_tentacle.kicad_pcb, pcb_tentacle.kicad_sch, pcb_tentacle_cpu.kicad_sch, pcb_tentacle_opto_relay.kicad_sch, pcb_tentacle_probe.kicad_sch, pcb_tentacle_regulator3V3.kicad_sch, pcb_tentacle_usbhubchip.kicad_sch]
2026-01-20 Tentacle v0.7: hw_version 0x02 -> 0x03
    [pcb_tentacle_cpu.kicad_sch]
2026-01-20 Tentacle v0.7: HUB U302: CFG_SEL_1 0->1
    [pcb_tentacle.kicad_pcb, pcb_tentacle_usbhubchip.kicad_sch]
2026-01-22 Tentacle: v0.7
    [bom.csv, designators.csv, pcb_tentacle.kicad_pcb, pcb_tentacle.kicad_sch, pcb_tentacle_cpu.kicad_sch, positions.csv]
2026-02-04 through_hole_diameter 0.2 -> 0.3 mm
2026-02-04 Copy footprint from library
2026-02-04 USB hub footprint: hole 0.2 mm -> 0.3 mm
    [pcb_tentacle.kicad_pcb, pcb_tentacle_usbhubchip.kicad_sch]
2026-02-04 kicad_jlc_vias.py automatically via dia 0.4->0.45, hole 0.2->0.3
    [pcb_tentacle.kicad_pcb]
2026-02-04 Tenatcle: v0.7. Manually fix all violations.
    [pcb_tentacle.kicad_pcb]
2026-02-17 Add usb cables to BOM
2026-02-20 Tentacle: v0.7.1
    [bom.csv, pcb_tentacle.kicad_pcb, pcb_tentacle.kicad_sch, pcb_tentacle_cpu.kicad_sch, pcb_tentacle_opto_relay.kicad_sch, pcb_tentacle_probe.kicad_sch, pcb_tentacle_prototype_area.kicad_sch, pcb_tentacle_relay_breakout.kicad_sch]
2026-04-28 Tentacle v0.6 and newer: ESP32 C3 did not reset correctly due to slow power up ramp of 5V/150ms.
2026-05-13 Update rp2_probe.rst: pico-coder
2026-05-20 Add 16mm and 33.6 mm bolzone
    [20241207b_bolzone-bolzone_due_label.stl, 20241207b_bolzone.FCStd, bolzone_due_16.0.stl, bolzone_due_33.6.stl, bolzone_uno_16.0.stl, bolzone_uno_33.6.stl, bolzone_v20250418a.FCStd]
2026-07-12 Tentacle v0.8: Initial commit
    [TS-1187A-B-A-B.step, TYPE-C-31-M-12--3DModel-STEP-56544.STEP, USB-226-BRW.stp, bom.csv, designators.csv, pcb_tentacle.kicad_pcb, pcb_tentacle.kicad_sch, pcb_tentacle_cpu.kicad_sch]
2026-07-12 Saved in kicad 10.0.4
    [pcb_tentacle.kicad_pcb, pcb_tentacle.kicad_sch, pcb_tentacle_cpu.kicad_sch, pcb_tentacle_opto_relay.kicad_sch, pcb_tentacle_probe.kicad_sch, pcb_tentacle_prototype_area.kicad_sch, pcb_tentacle_regulator3V3.kicad_sch, pcb_tentacle_relay_breakout.kicad_sch]
2026-07-12 PCB C217/1uF: 0402 -> 0805
    [pcb_tentacle.kicad_pcb, pcb_tentacle_regulator3V3.kicad_sch]
2026-07-12 Solder bridge, 100nF parallel to C217
    [pcb_tentacle.kicad_pcb, pcb_tentacle_regulator3V3.kicad_sch]
2026-07-12 Solder bridge, 100nF parallel to C217 (solder bridge on back)
    [pcb_tentacle.kicad_pcb]
2026-07-12 Tentacle: v0.8.0
    [bom.csv, designators.csv, positions.csv]
2026-11-10 BOM: Add better USB Micro Connector
2026-11-11 bom: Add white label
