octoprobe/tentacle/(notices)

Notices in the files:
kicad/tentacle/pcb_octoprobe_gnd.kicad_sch:
The MIT License (MIT)
parts and their libraries:
License: CC BY 4.0
